Mr-JoE1/SS_AI_Traffic_Radar/README.md

<H1 align="center">SS_Project Backend Development </H1>

## Repo Structure

  -
