Mr-JoE1/SS_AI_Traffic_Radar/ML/README.md

<H1 align="center">SS_Project Backend Development </H1>

## Repo Structure

  - Hardware : contains hardware components config scripts for both cm4 and jetson
  	For repo structure: $ tree -d

  - Plate_detection:  contains sw for YOLOv8 modules for plate detection and text extraction using easyOCR
