Mr-JoE1/SS_AI_Traffic_Radar/Hardware/SS_CM4IO/SS_CM4IO_V2_1/SS_CM4IO_V2_2.png

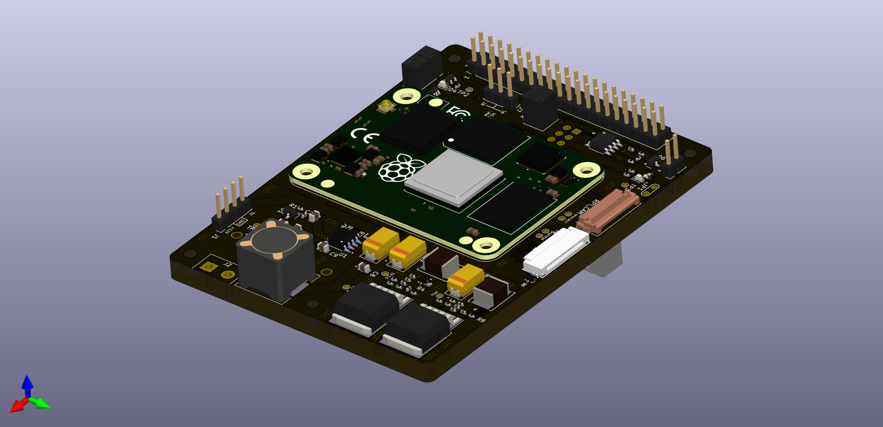
Hardware/SS_CM4IO/SS_CM4IO_V2_1/SS_CM4IO_V2_2.png
