Mr-JoE1/SS_AI_Traffic_Radar/Hardware/SS_JET_ORIN/LT_SIM/TimerDelay_Sim.png

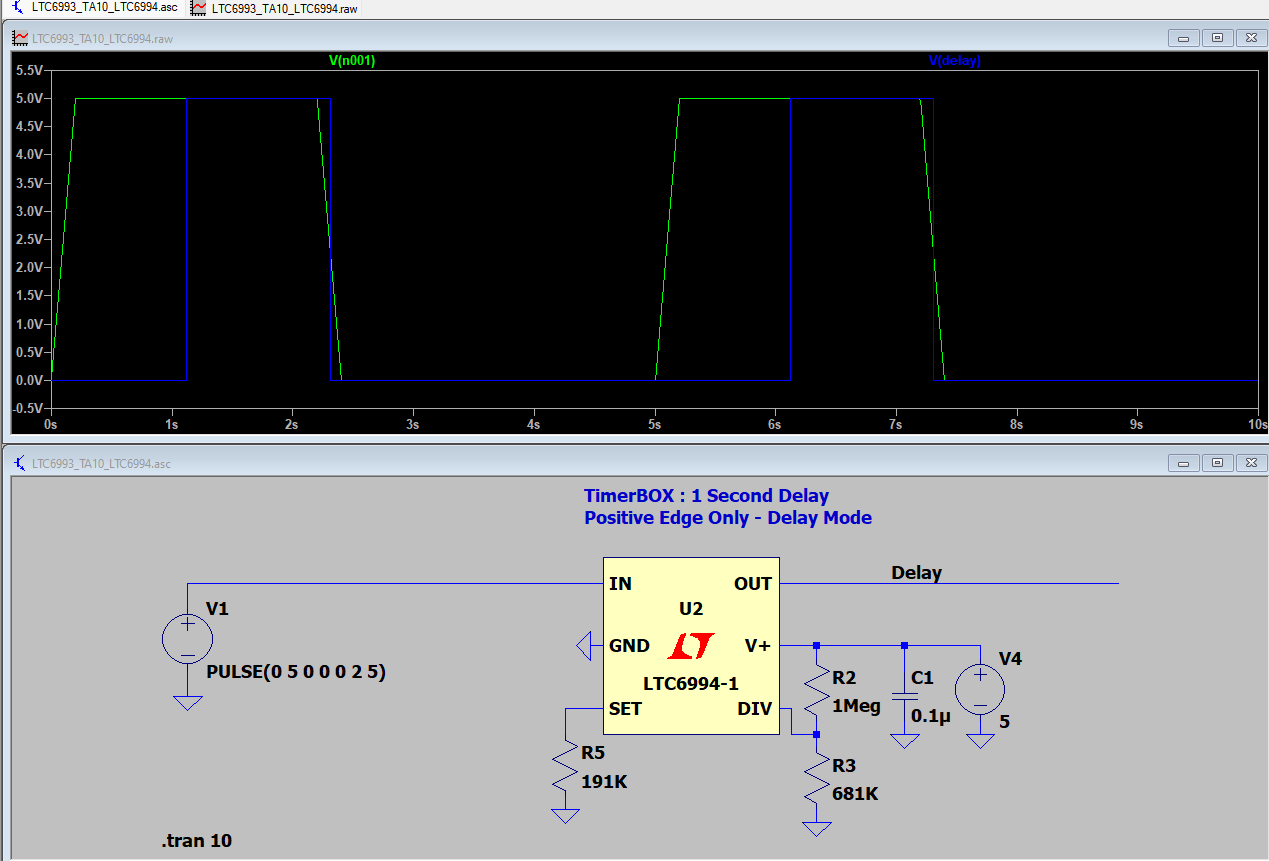
Hardware/SS_JET_ORIN/LT_SIM/TimerDelay_Sim.png
