Mr-JoE1/SS_AI_Traffic_Radar/Hardware/SS_JET_ORIN/REF/Block-diagram-of-Jetson-Orin-Nano.png

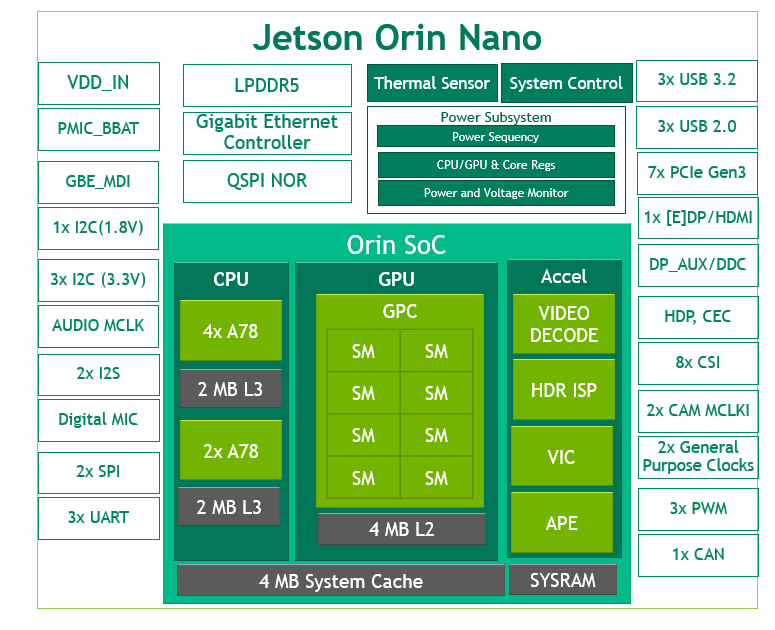
Hardware/SS_JET_ORIN/REF/Block-diagram-of-Jetson-Orin-Nano.png
