Mr-JoE1/SS_AI_Traffic_Radar/Hardware/SS_JET_ORIN/SS_JetOrin_V1/SS_JetOrin_2.png

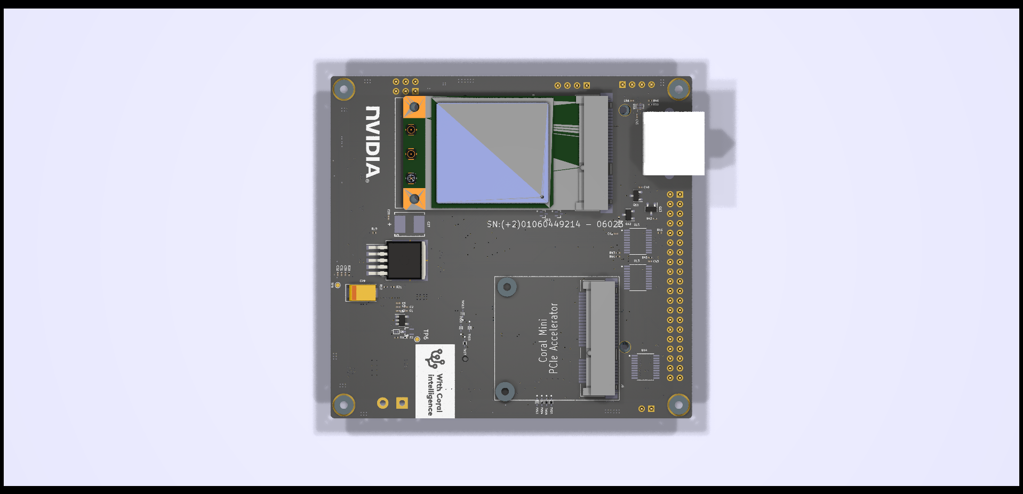
Hardware/SS_JET_ORIN/SS_JetOrin_V1/SS_JetOrin_2.png
