Mr-JoE1/SS_AI_Traffic_Radar/Hardware/PO_Prototype_List.xlsx

Items needed for Protoyping SS CM4 V2 BOARD
CM4 HARDWARE
N | ITEM | QYT | PRICE | LINK
1 | RPI CM4 with wifi and Emmc | 1 | $215 | Raspberry Pi Compute Module 4 With 8gb Ram Lite Emmc Flash Optional Support Wifi/bluetooth And External Antenna - Demo Board - AliExpress (https://www.aliexpress.us/item/3256803028967228.html?curPageLogUid=L7BpIR4CJ1Lk)
2 | RPI CM4 IO BOARD | 1 | $15 | IO Board for CM4 Compute Module for Raspberry Pi 4B Expansion Board Dual HDMI IO Board| | - AliExpress (https://www.aliexpress.us/item/3256805290910127.html?curPageLogUid=mT7mnrszEpVK)
 |  |  | $35 | CM4IO - Raspberry-pi - Compute Module 4 I/O Board, Raspberry Pi, BCM2711 (newark.com) (https://www.newark.com/raspberry-pi/cm4io/compute-module-4-board-arm-cortex/dp/86AH2064)
3 | Raspberry Pi Global Shutter Camera | 1 | $50 | Raspberry Pi Global Shutter Camera - PiShop.us (https://www.pishop.us/product/raspberry-pi-global-shutter-camera/?src=raspberrypi)
4 | SS_CM4_V2 Board JLC | 1 | NA
Common HARDWARE
5 | QuectelEG25GGB-MINIPCIE | 1 | $100 | EG25GGB-MINIPCIE Quectel - Distributors, Price Comparison, and Datasheets | Octopart component search (https://octopart.com/eg25ggb-minipcie-quectel-97300401)
6 | Mini PCIe Accelerator | 1 | $25 | Mini PCIe Accelerator | Coral (https://coral.ai/products/pcie-accelerator)
7 | Coral Camera | 1 | $20 | Camera | Coral (https://coral.ai/products/camera/)
