Mr-JoE1/SS_AI_Traffic_Radar/Hardware/SS_CM4IO/SS_CM4IO_V2_1/EXT_LIB/DALC208SC6/DALC208SC6.step

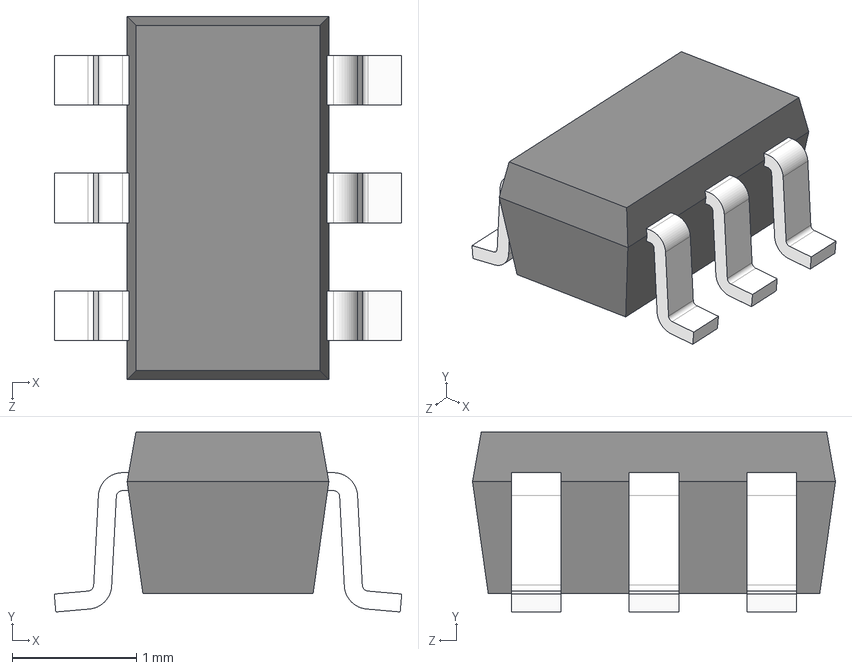
[picture p15: CAD file, 2023-10-18]
Hardware/SS_CM4IO/SS_CM4IO_V2_1/EXT_LIB/DALC208SC6/DALC208SC6.step
2.80 x 1.45 x 2.92 mm
