Mr-JoE1/SS_AI_Traffic_Radar/Hardware/SS_CM4IO/SS_CM4IO_V2_1/EXT_LIB/DTC143ZEBTL/DTC143ZEBTL.step

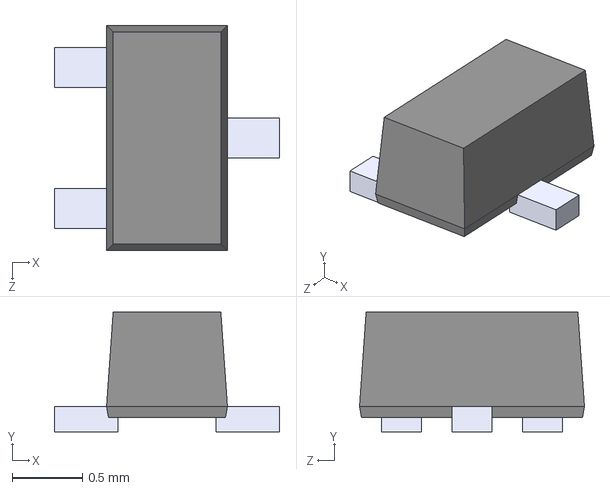
[picture p16: CAD file, 2023-10-18]
Hardware/SS_CM4IO/SS_CM4IO_V2_1/EXT_LIB/DTC143ZEBTL/DTC143ZEBTL.step
1.60 x 0.85 x 1.60 mm
