Mr-JoE1/SS_AI_Traffic_Radar/Hardware/SS_CM4IO/SS_CM4IO_V2_1/EXT_LIB/SIM-E-MFF2-GL-250/SIM-E-MFF2-GL-250.step

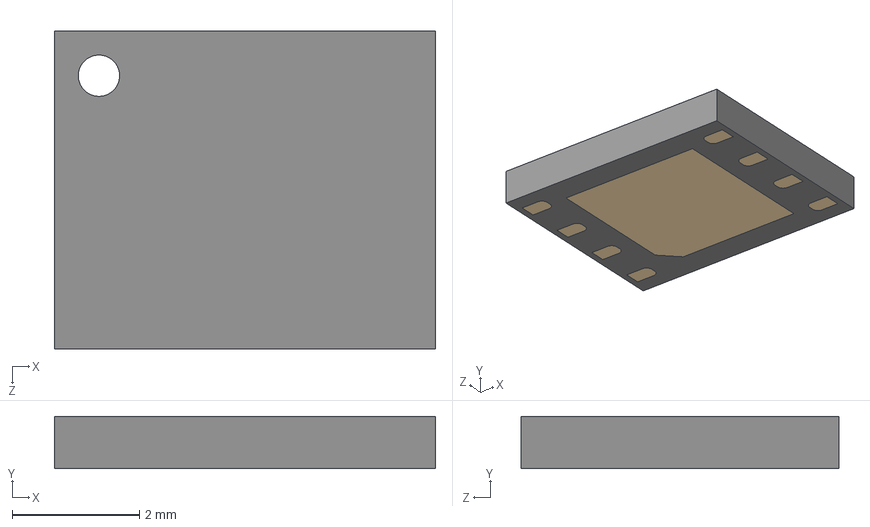
[picture p17: CAD file, 2023-10-18]
Hardware/SS_CM4IO/SS_CM4IO_V2_1/EXT_LIB/SIM-E-MFF2-GL-250/SIM-E-MFF2-GL-250.step
6.00 x 0.82 x 5.00 mm
