Mr-JoE1/SS_AI_Traffic_Radar/Hardware/SS_JET_ORIN/SS_JetOrin_V1/EXT-LIB/DMN26D0UFB4-7/DMN26D0UFB4-7.step

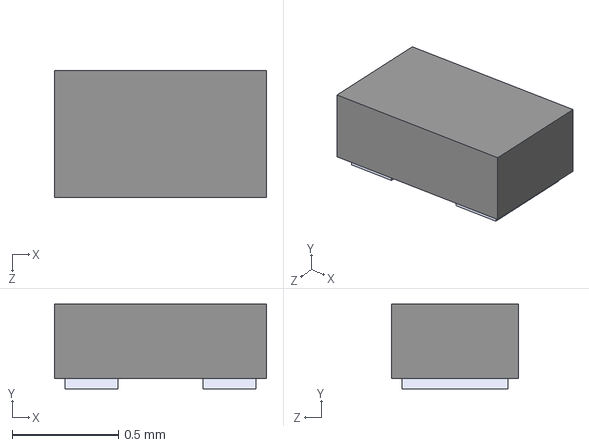
[picture p18: CAD file, 2023-10-18]
Hardware/SS_JET_ORIN/SS_JetOrin_V1/EXT-LIB/DMN26D0UFB4-7/DMN26D0UFB4-7.step
1.00 x 0.4 x 0.6 mm
