Mr-JoE1/SS_AI_Traffic_Radar/Hardware/SS_JET_ORIN/SS_JetOrin_V1/EXT-LIB/DMN61D9UW-7/DMN61D9UW-7.step

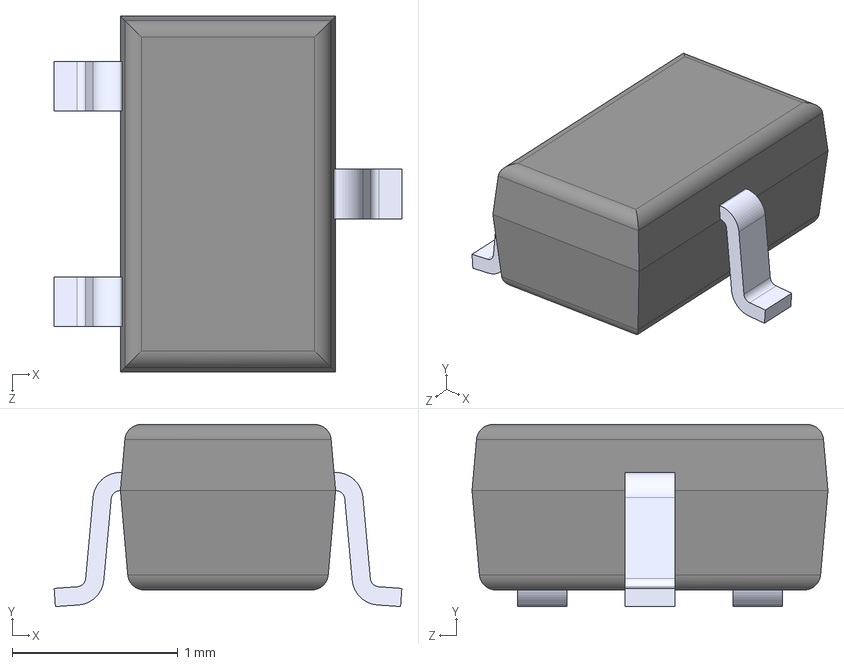
[picture p19: CAD file, 2023-10-18]
Hardware/SS_JET_ORIN/SS_JetOrin_V1/EXT-LIB/DMN61D9UW-7/DMN61D9UW-7.step
2.10 x 1.10 x 2.15 mm
