Mr-JoE1/SS_AI_Traffic_Radar/Hardware/SS_JET_ORIN/SS_JetOrin_V1/EXT-LIB/ESD9L5.0ST5G/ESD9L5.0ST5G.step

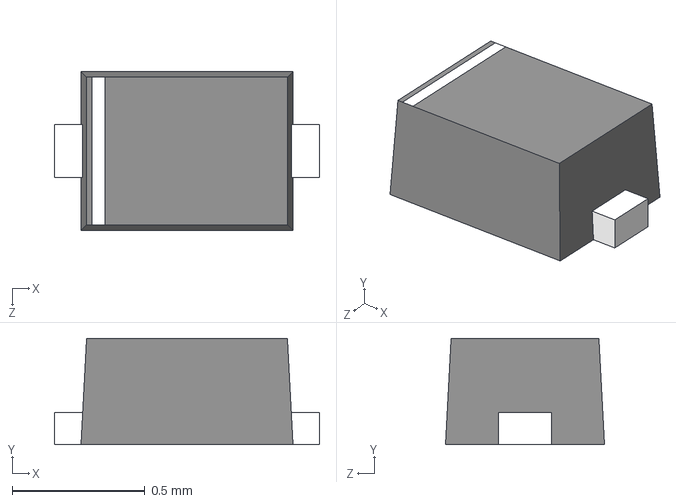
[picture p20: CAD file, 2023-10-18]
Hardware/SS_JET_ORIN/SS_JetOrin_V1/EXT-LIB/ESD9L5.0ST5G/ESD9L5.0ST5G.step
1 x 0.4 x 0.6 mm
