Mr-JoE1/SS_AI_Traffic_Radar/Hardware/SS_JET_ORIN/SS_JetOrin_V1/EXT-LIB/SN74LV1T125DCKR/SN74LV1T125DCKR.step

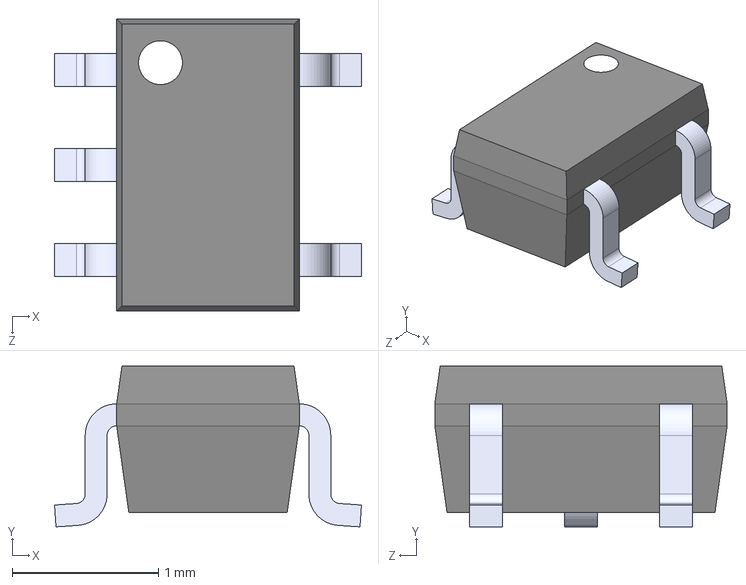
[picture p21: CAD file, 2023-10-18]
Hardware/SS_JET_ORIN/SS_JetOrin_V1/EXT-LIB/SN74LV1T125DCKR/SN74LV1T125DCKR.step
2.10 x 1.10 x 2.00 mm
