Mr-JoE1/SS_AI_Traffic_Radar/Hardware/SS_JET_ORIN/SS_JetOrin_V1/EXT-LIB/TPS5450DDAR/TPS5450DDAR.step

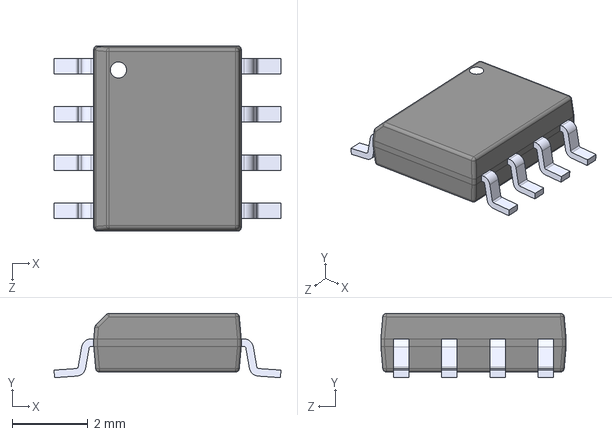
[picture p22: CAD file, 2023-10-18]
Hardware/SS_JET_ORIN/SS_JetOrin_V1/EXT-LIB/TPS5450DDAR/TPS5450DDAR.step
6.00 x 1.70 x 4.90 mm
