Mr-JoE1/SS_AI_Traffic_Radar/Hardware/SS_JET_ORIN/SS_JetOrin_V1/EXT-LIB/TS3USB30ERSWR/TS3USB30ERSWR.step

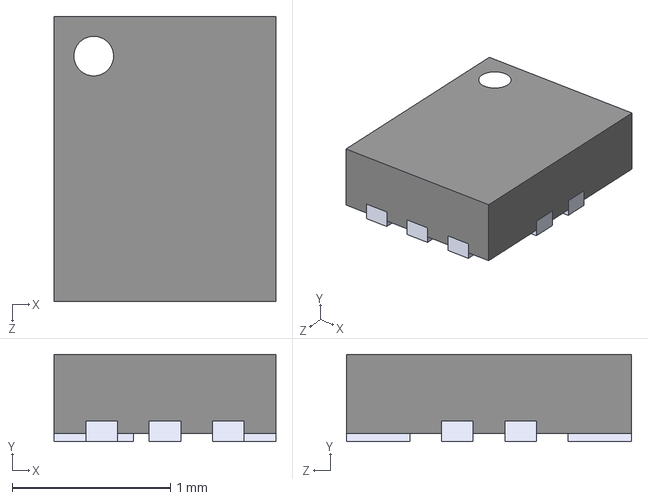
[picture p23: CAD file, 2023-10-18]
Hardware/SS_JET_ORIN/SS_JetOrin_V1/EXT-LIB/TS3USB30ERSWR/TS3USB30ERSWR.step
1.40 x 0.55 x 1.80 mm
