Mr-JoE1/SS_AI_Traffic_Radar/Hardware/SS_JET_ORIN/SS_JetOrin_V1/EXT-LIB/TXB0108PWR/TXB0108PWR.step

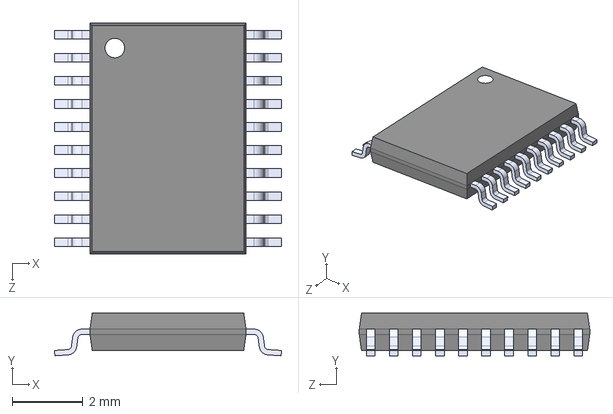
[picture p24: CAD file, 2023-10-18]
Hardware/SS_JET_ORIN/SS_JetOrin_V1/EXT-LIB/TXB0108PWR/TXB0108PWR.step
6.40 x 1.20 x 6.50 mm
