Mr-JoE1/SS_AI_Traffic_Radar/Hardware/SS_JET_ORIN/SS_JetOrin_V1/EXT-LIB/TXB0302DQMR/TXB0302DQMR.step

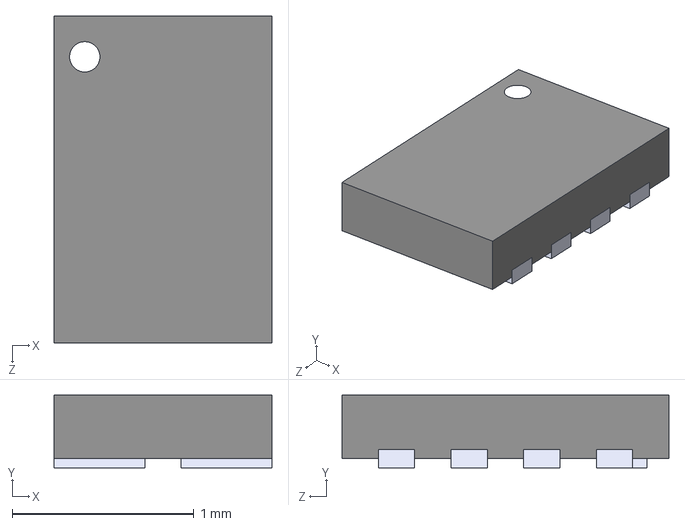
[picture p25: CAD file, 2023-10-18]
Hardware/SS_JET_ORIN/SS_JetOrin_V1/EXT-LIB/TXB0302DQMR/TXB0302DQMR.step
1.20 x 0.4 x 1.80 mm
