Mr-JoE1/SS_AI_Traffic_Radar/Hardware/SS_JET_ORIN/SS_JetOrin_V1/3d_shapes/PowerDI3333-8_Type-UX.STP

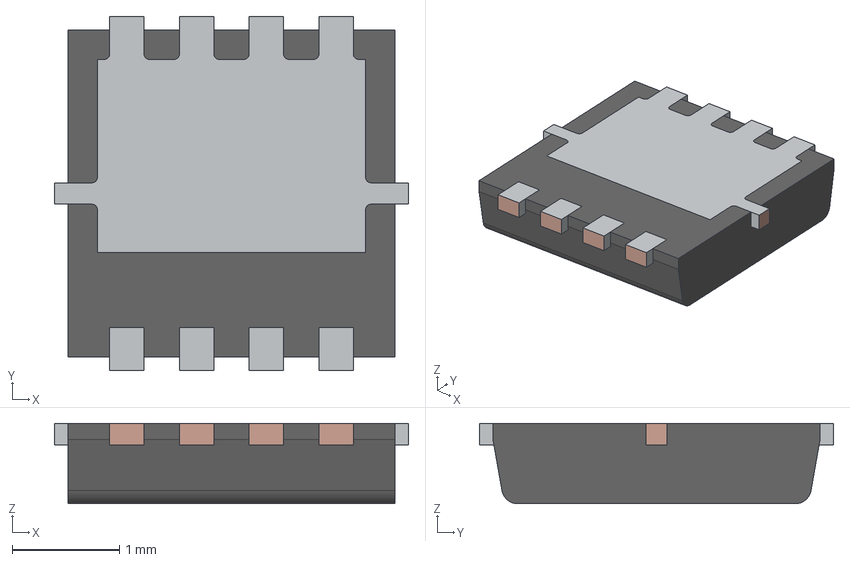
[picture p26: CAD file, 2023-10-18]
Hardware/SS_JET_ORIN/SS_JetOrin_V1/3d_shapes/PowerDI3333-8_Type-UX.STP
3.30 x 3.30 x 0.75 mm
Mold
LDF
