Mr-JoE1/SS_AI_Traffic_Radar/Hardware/SS_JET_ORIN/SS_JetOrin_V1/3d_shapes/P3767-pcba-envelop_20230310.stp

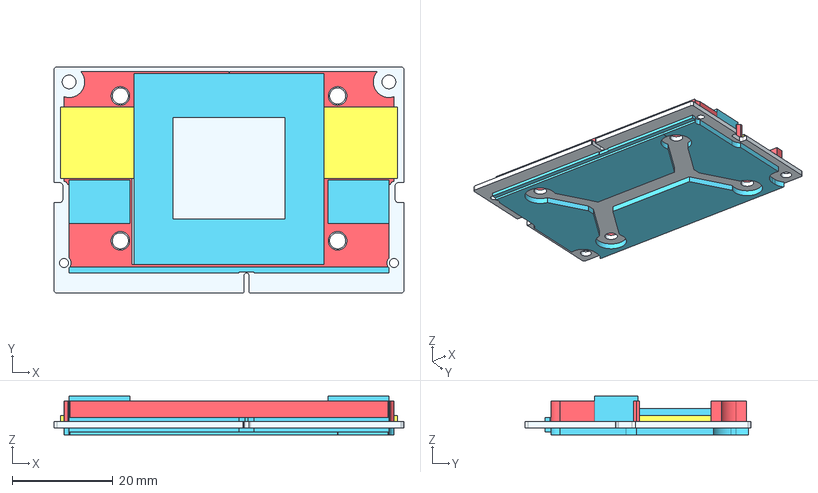
[picture p27: CAD file, 2023-10-18]
Hardware/SS_JET_ORIN/SS_JetOrin_V1/3d_shapes/P3767-pcba-envelop_20230310.stp
69.6 x 45.0 x 7.68 mm
