Mr-JoE1/SS_AI_Traffic_Radar/Hardware/SS_JET_ORIN/SS_JetOrin_V1/3d_shapes/FPC-SMD_P0.50-24P_QCHF-SM-H2.0.obj

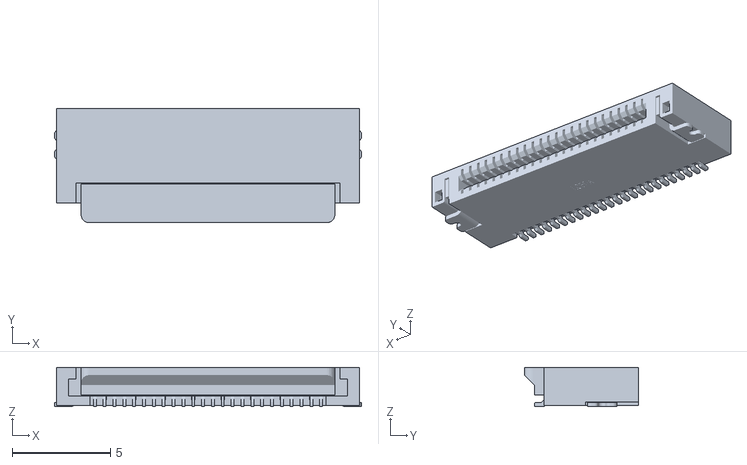
[picture p28: CAD file, 2023-10-18]
Hardware/SS_JET_ORIN/SS_JetOrin_V1/3d_shapes/FPC-SMD_P0.50-24P_QCHF-SM-H2.0.obj
15.6 x 5.80 x 2.00
