Mr-JoE1/SS_AI_Traffic_Radar/Hardware/SS_JET_ORIN/SS_JetOrin_V1/3d_shapes/FH12-22S-0.5SH.STEP

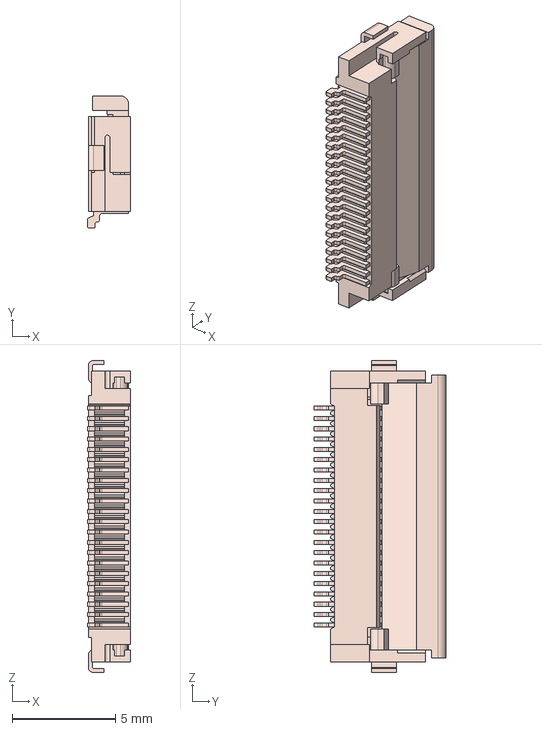
[picture p29: CAD file, 2023-10-18]
Hardware/SS_JET_ORIN/SS_JetOrin_V1/3d_shapes/FH12-22S-0.5SH.STEP
2.10 x 6.40 x 15.1 mm
