Mr-JoE1/SS_AI_Traffic_Radar/Hardware/SS_JET_ORIN/SS_JetOrin_V1/3d_shapes/pcie_52_h.stp

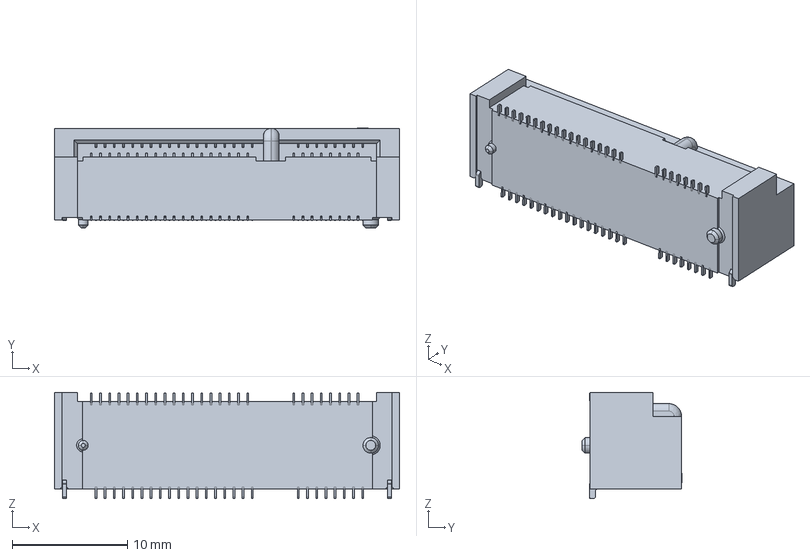
[picture p30: CAD file, 2023-10-18]
Hardware/SS_JET_ORIN/SS_JetOrin_V1/3d_shapes/pcie_52_h.stp
30.0 x 8.68 x 9.22 mm
