Mr-JoE1/SS_AI_Traffic_Radar/(list of files, cad)

Other CAD files:
Hardware/SS_JET_ORIN/SS_JetOrin_V1/3d_shapes/9774025151.stp
