Mr-JoE1/SS_AI_Traffic_Radar/Hardware/SS_JET_ORIN/SS_JetOrin_V1/SS_JetOrin_V1-PSUs-P_Seq_M.pdf

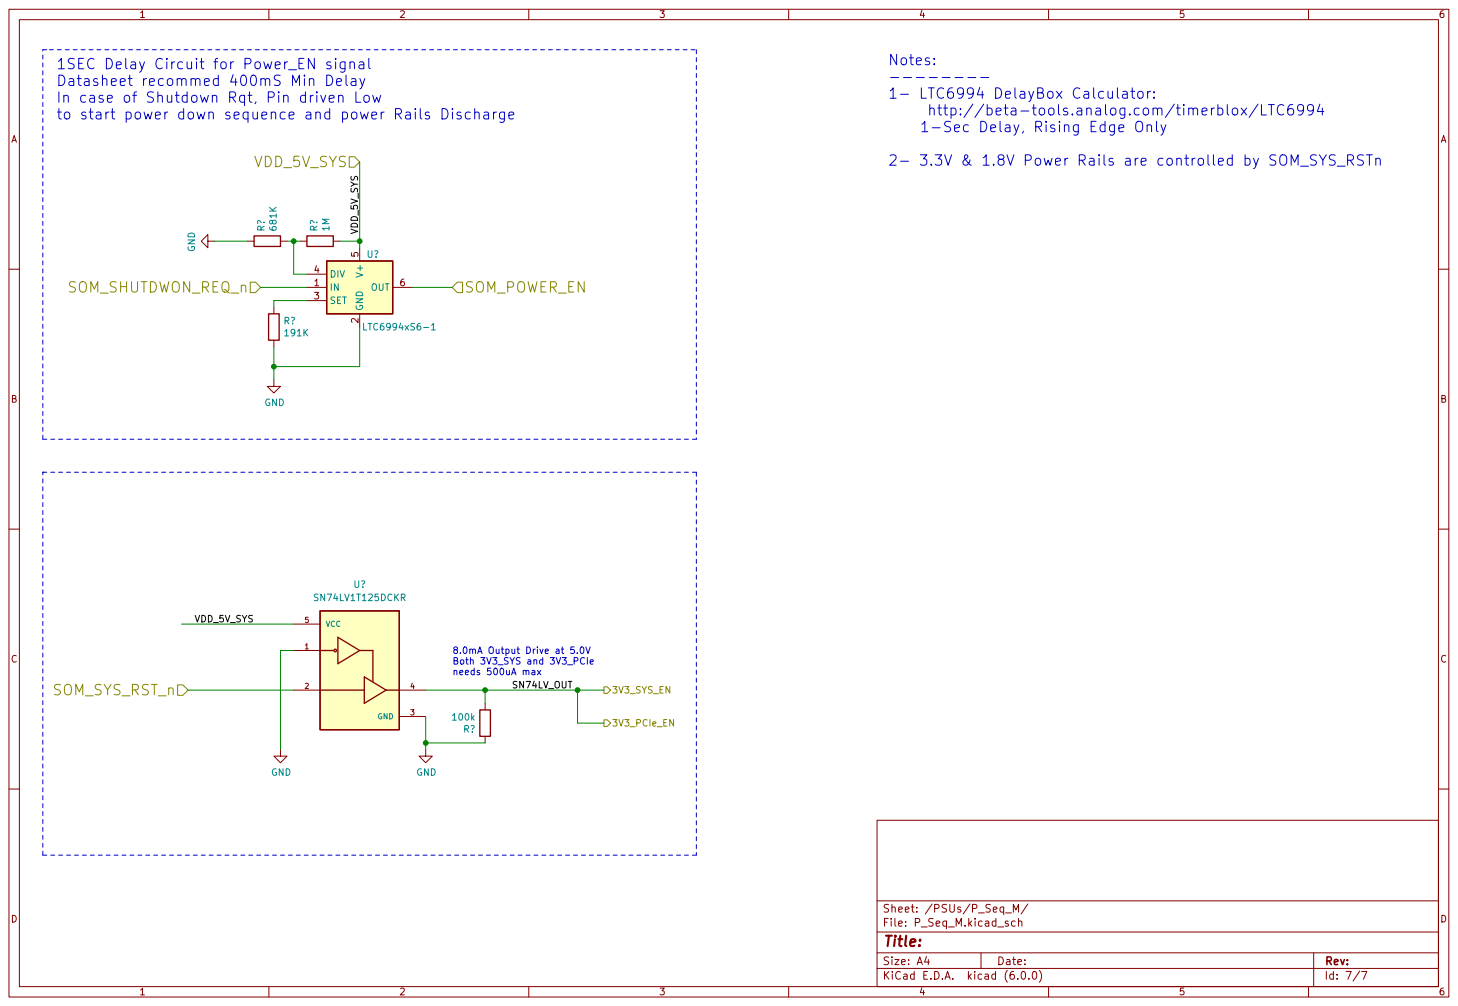
[picture p31: page 1]

1SEC Delay Circuit for Power_EN signal
Datasheet recommed 400mS Min Delay
In case of Shutdown Rqt, Pin driven Low
to start power down sequence and power Rails Discharge

http://beta-tools.analog.com/timerblox/LTC6994
1-Sec Delay, Rising Edge Only

2- 3.3V & 1.8V Power Rails are controlled by SOM_SYS_RSTn
