Mr-JoE1/SS_AI_Traffic_Radar/Hardware/SS_JET_ORIN/SS_JetOrin_V1/production/SS_JetOrin_V1.pdf

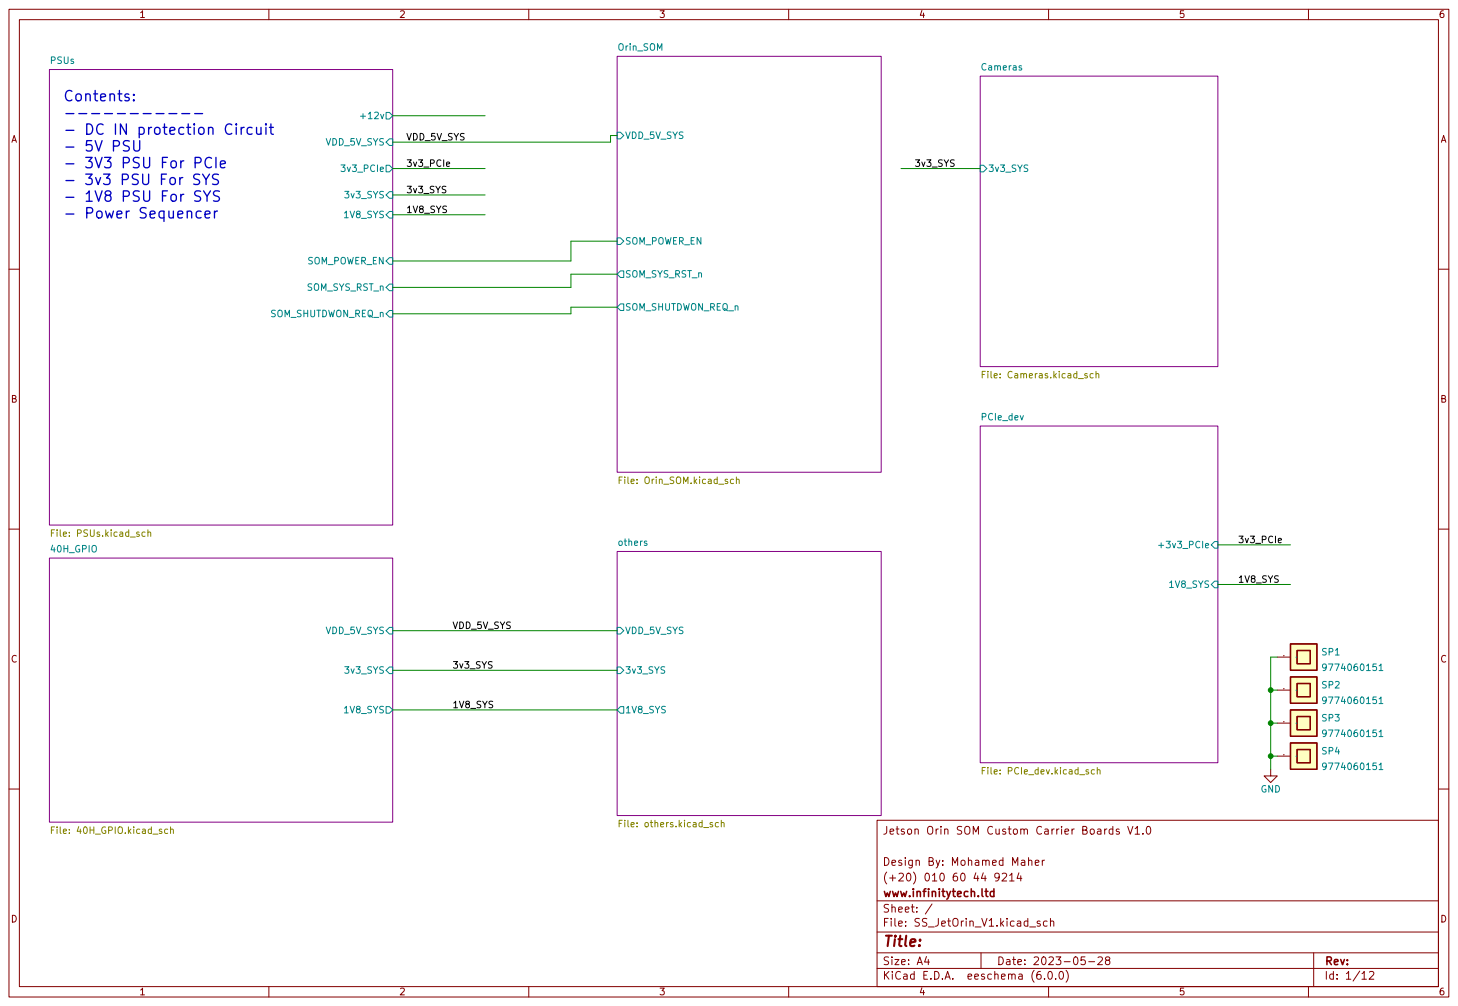
[picture p32: page 1]

PSUs File: PSUs.kicad_sch
3v3_SYS Contents:
- DC IN protection Circuit
- 5V PSU
- 3V3 PSU For PCIe
- 3v3 PSU For SYS
- 1V8 PSU For SYS
- Power Sequencer

Design By: Mohamed Maher Jetson Orin SOM Custom Carrier Boards V1.0

File: SS_JetOrin_V1.kicad_sch Sheet: / www.infinitytech.ltd

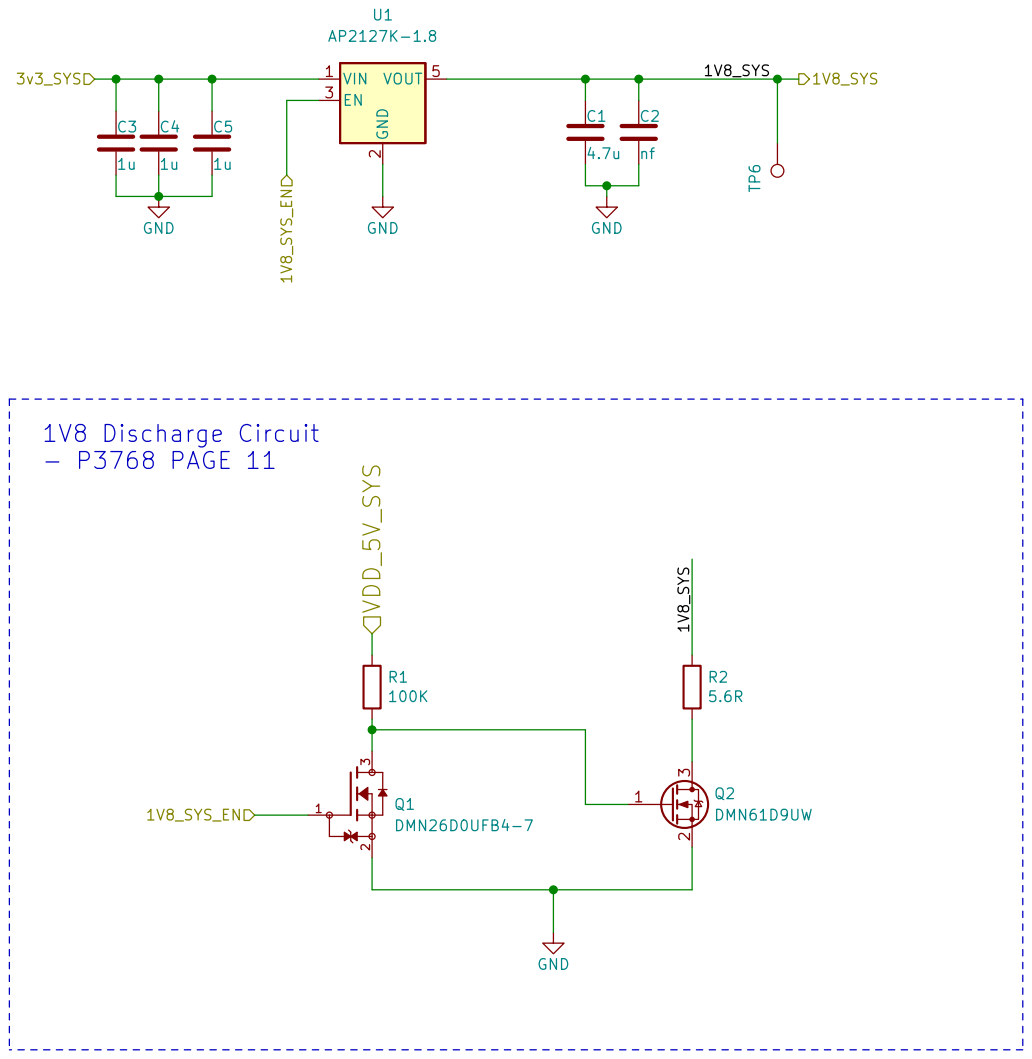
[picture p33: page 2]

Design By: Mohamed Maher Jetson Orin SOM Custom Carrier Boards V1.0 R1

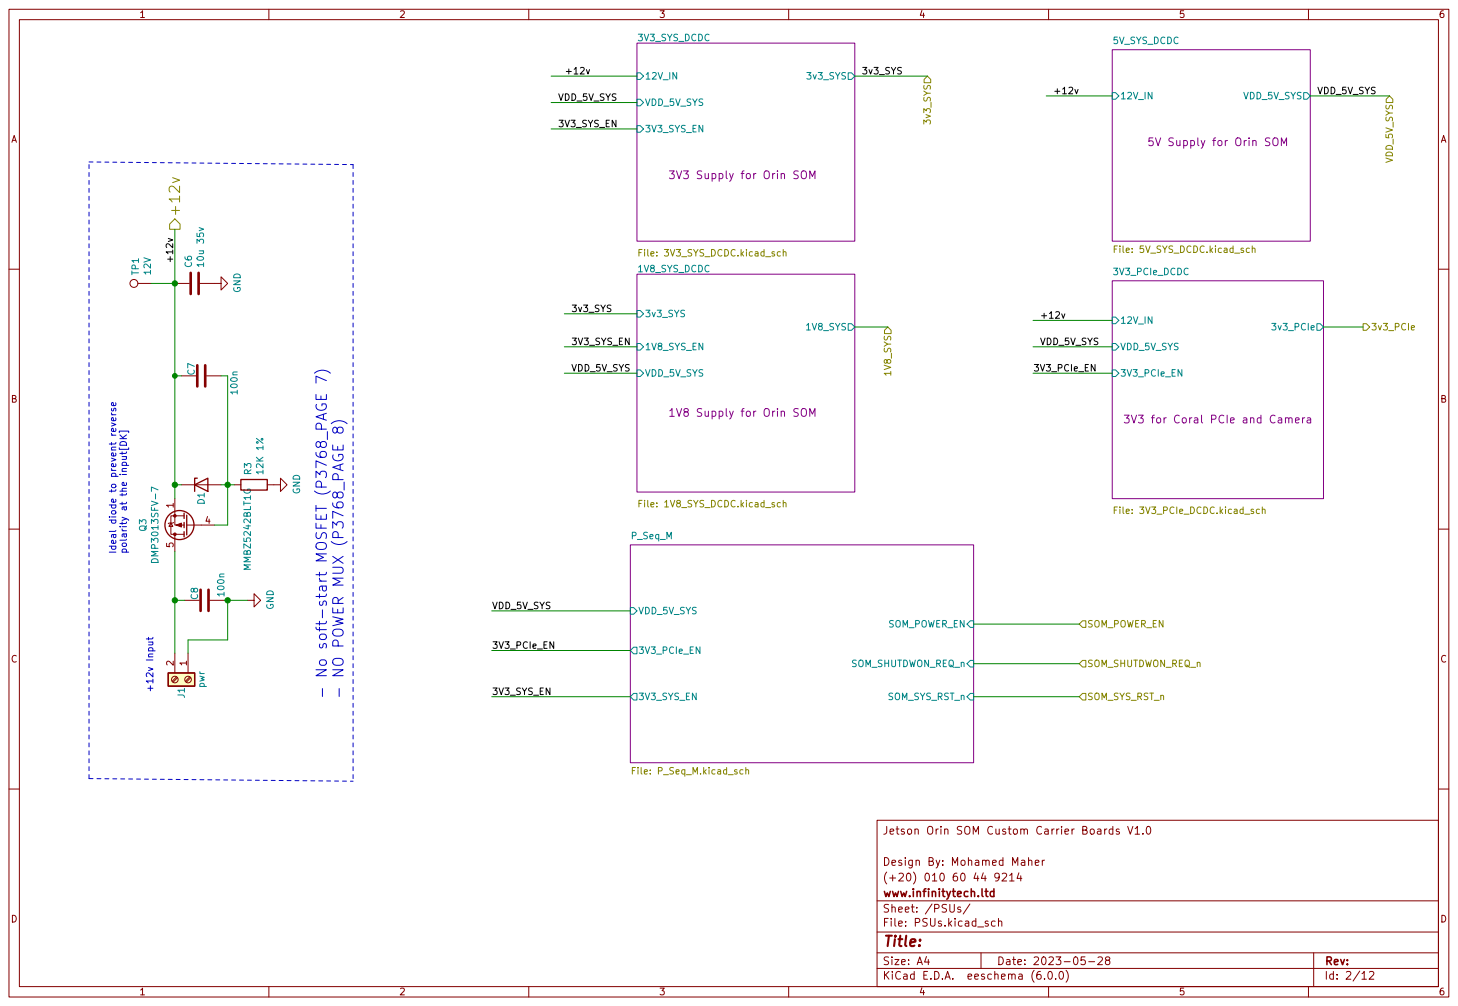
[picture p34: page 3]

File: 5V_SYS_DCDC.kicad_sch 5V Supply for Orin SOM

File: 3V3_SYS_DCDC.kicad_sch 3V3 Supply for Orin SOM

File: 1V8_SYS_DCDC.kicad_sch 1V8 Supply for Orin SOM

File: 3V3_PCIe_DCDC.kicad_sch 3V3 for Coral PCIe and Camera

Design By: Mohamed Maher Jetson Orin SOM Custom Carrier Boards V1.0

File: PSUs.kicad_sch Sheet: /PSUs/ www.infinitytech.ltd

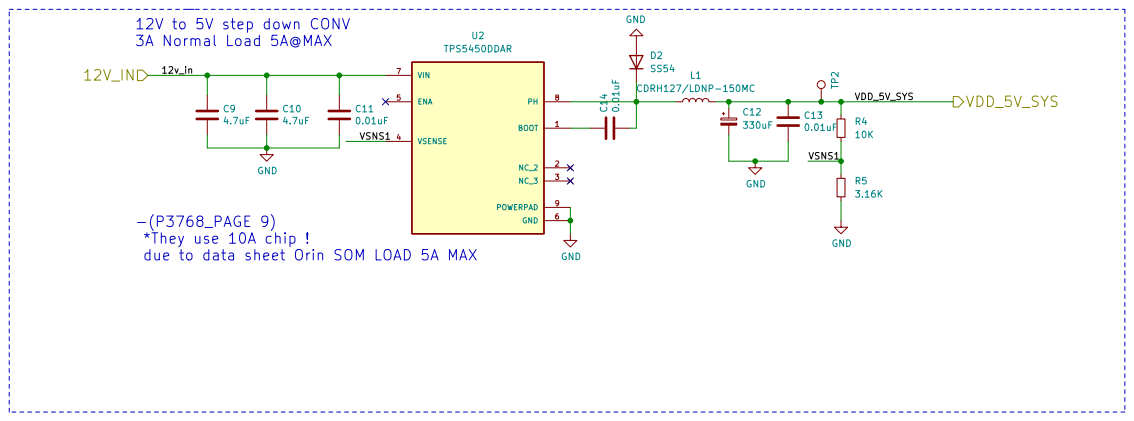
[picture p35: page 4]

VSNS1 12V to 5V step down CONV
3A Normal Load 5A@MAX

-(P3768_PAGE 9)
*They use 10A chip !
due to data sheet Orin SOM LOAD 5A MAX

Design By: Mohamed Maher Jetson Orin SOM Custom Carrier Boards V1.0

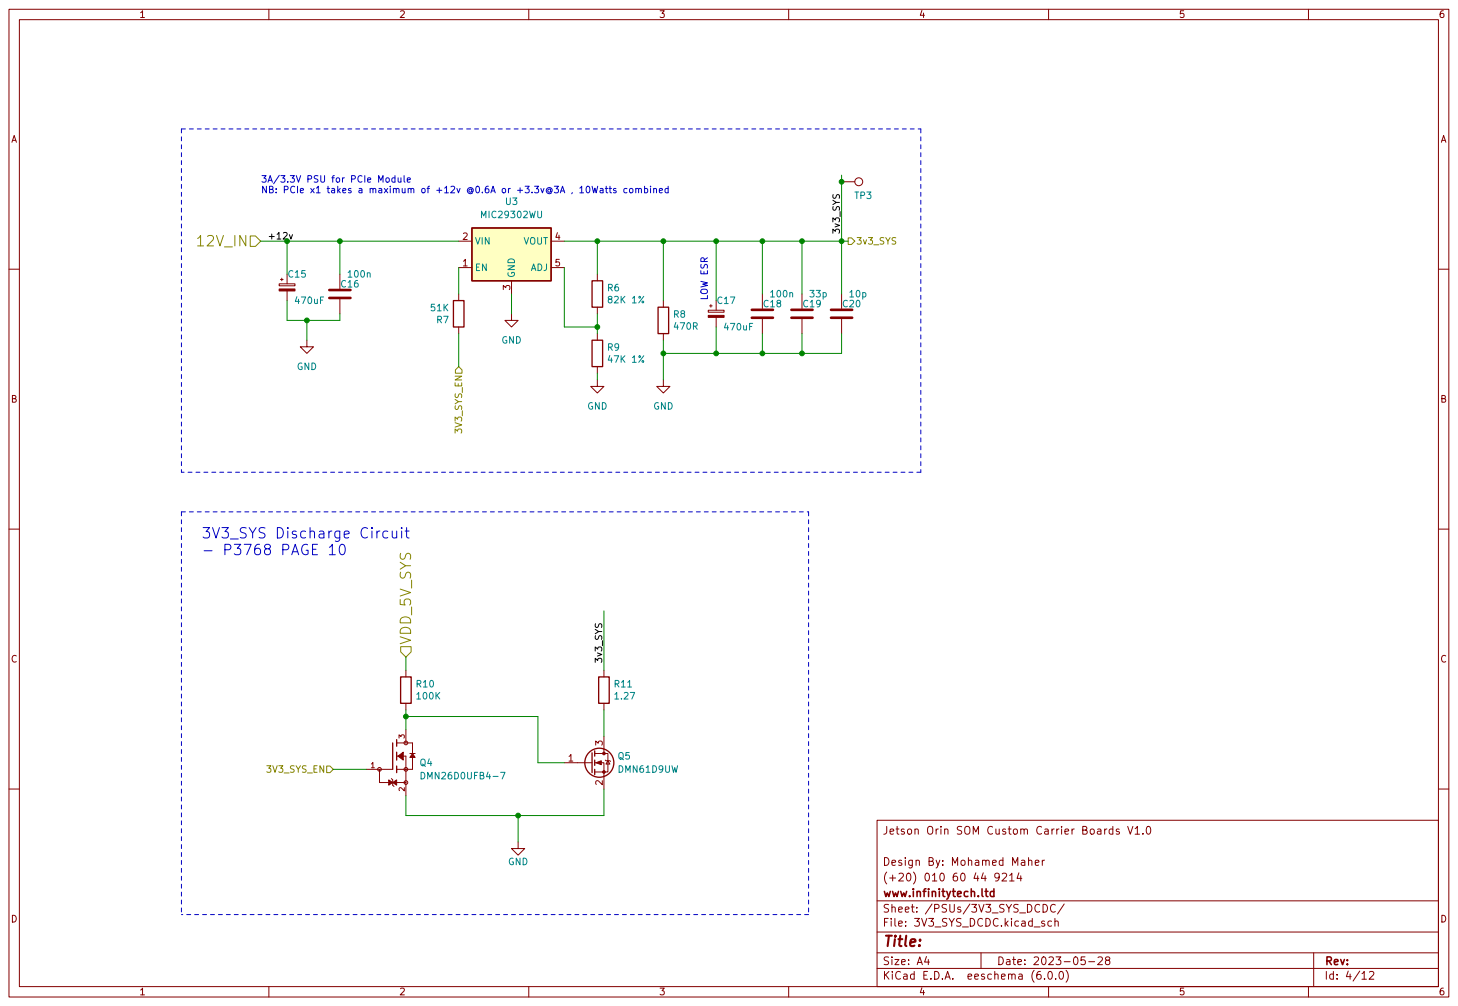
[picture p36: page 5]

Design By: Mohamed Maher Jetson Orin SOM Custom Carrier Boards V1.0 GND

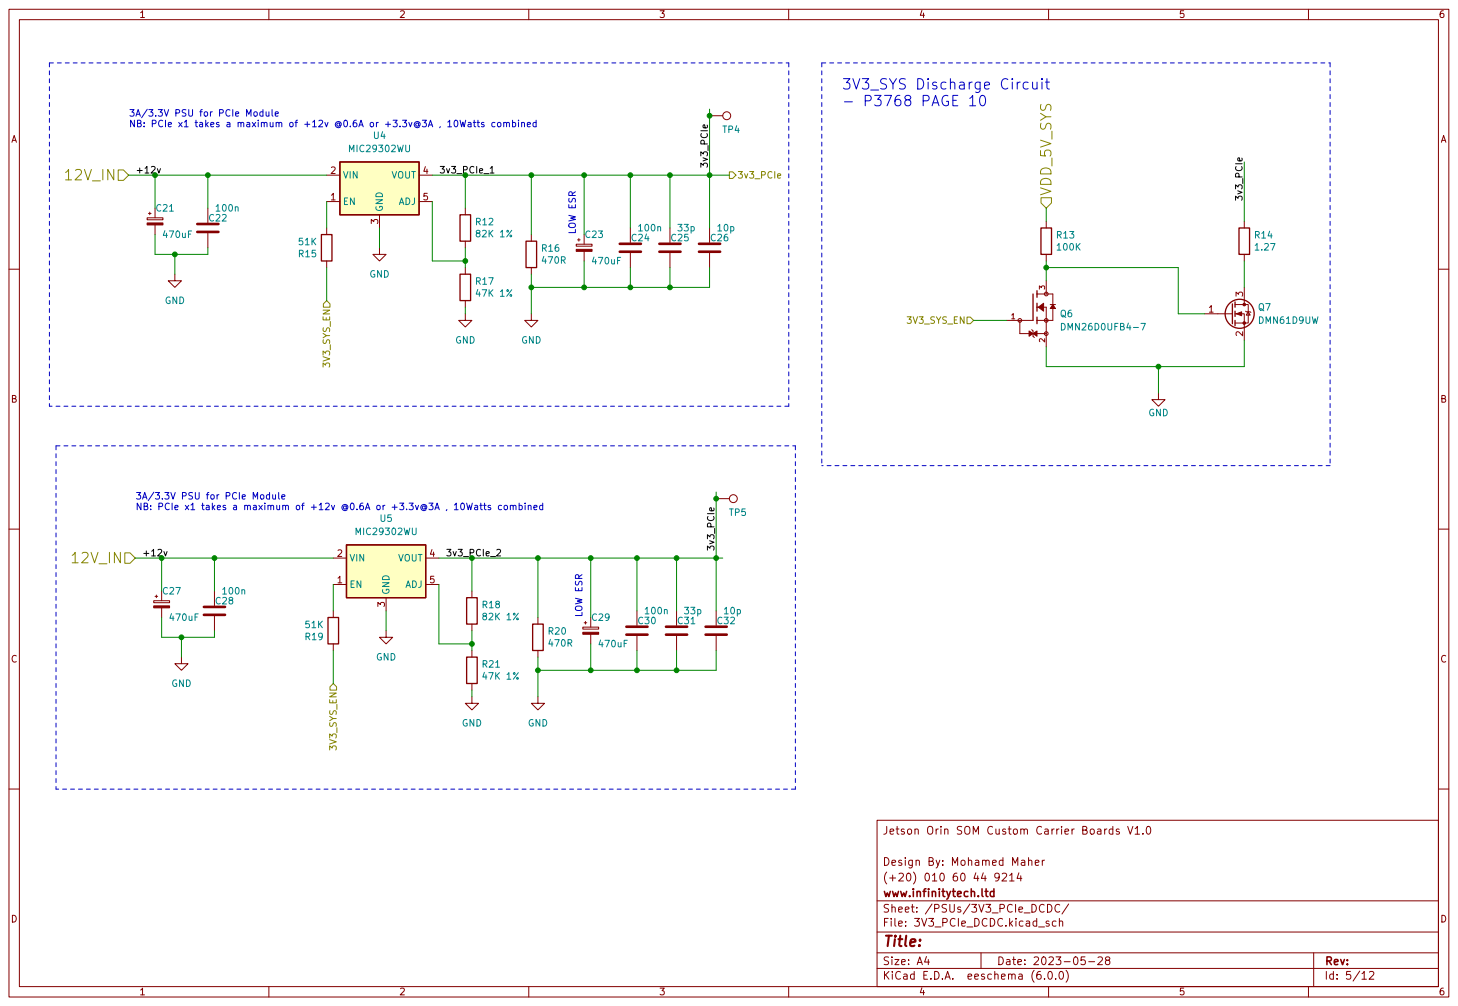
[picture p37: page 6]

- P3768 PAGE 10 LOW ESR LOW ESR

3A/3.3V PSU for PCIe Module NB: PCIe x1 takes a maximum of +12v @0.6A or +3.3v@3A , 10Watts combined

Design By: Mohamed Maher Jetson Orin SOM Custom Carrier Boards V1.0

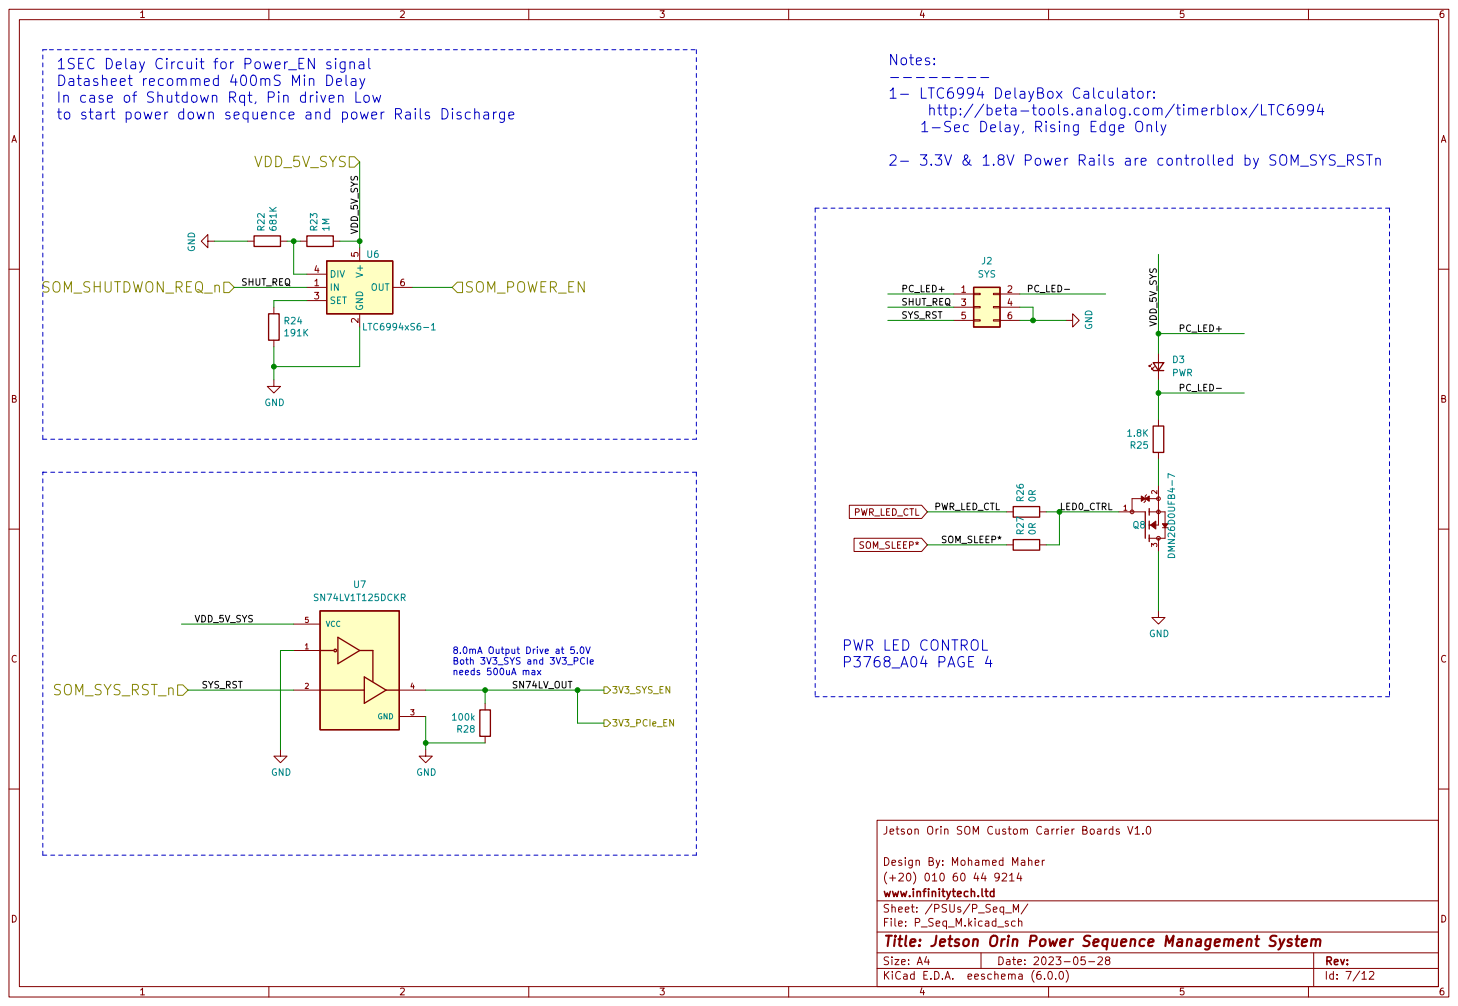
[picture p38: page 7]

1SEC Delay Circuit for Power_EN signal
Datasheet recommed 400mS Min Delay
In case of Shutdown Rqt, Pin driven Low
to start power down sequence and power Rails Discharge

http://beta-tools.analog.com/timerblox/LTC6994
1-Sec Delay, Rising Edge Only

2- 3.3V & 1.8V Power Rails are controlled by SOM_SYS_RSTn

www.infinitytech.ltd
Sheet: /PSUs/P_Seq_M/
File: P_Seq_M.kicad_sch
Id: 7/12 Title: Jetson Orin Power Sequence Management System

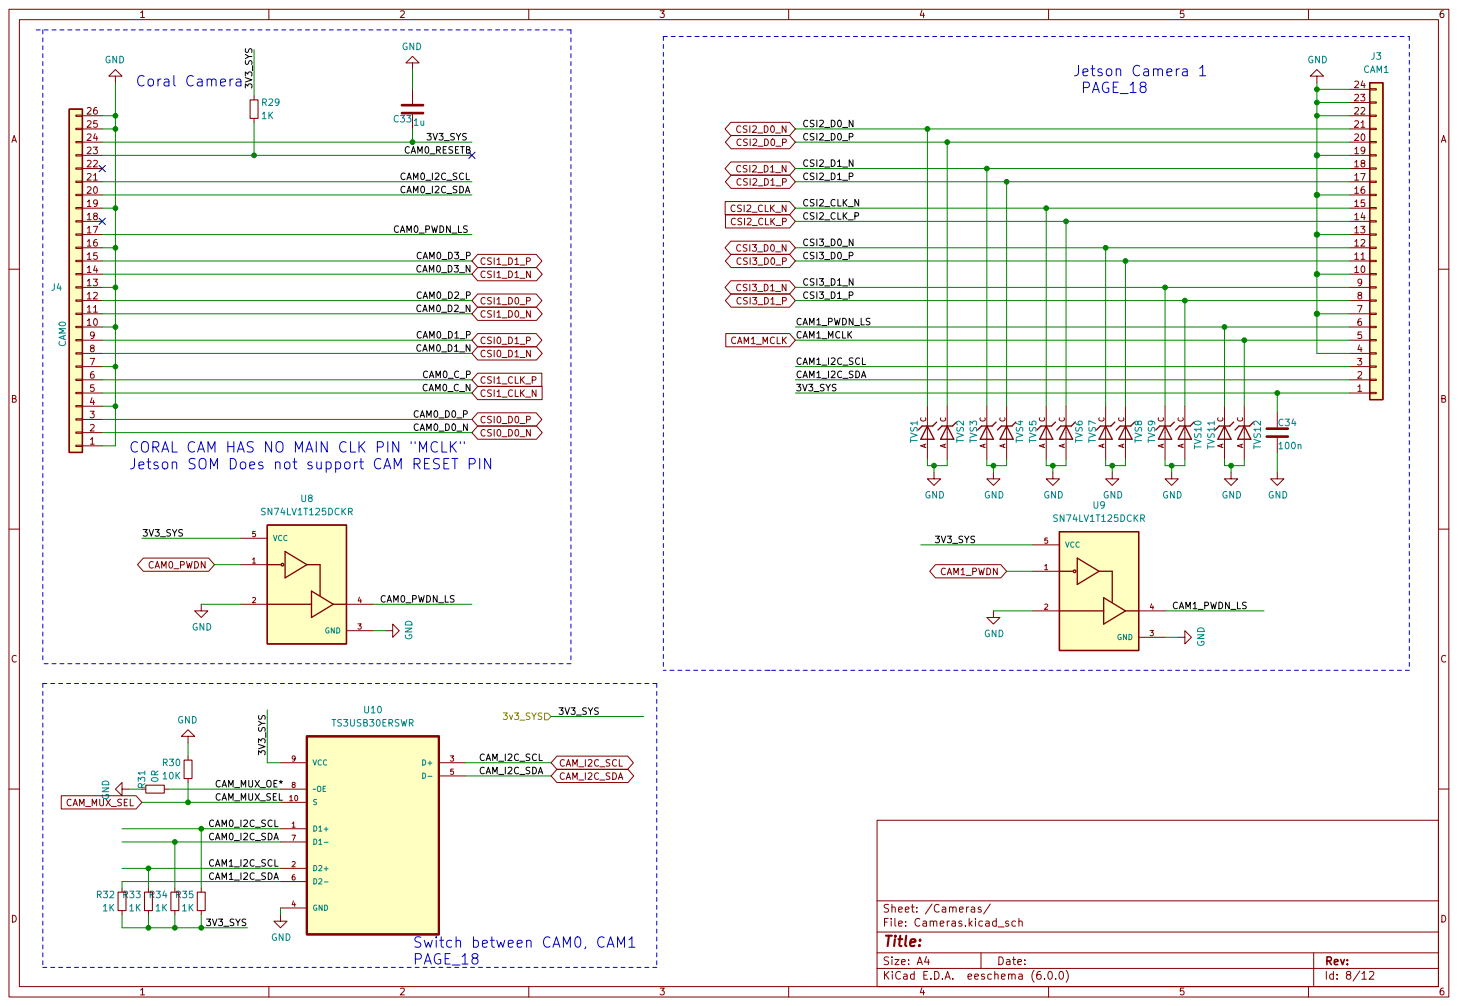
[picture p39: page 8]

3V3_SYS CAM1_I2C_SCL CSI3_D1_N
File: Cameras.kicad_sch Sheet: /Cameras/ GND

U8 SN74LV1T125DCKR | 4 VCC 5

U9 SN74LV1T125DCKR | 4 VCC 5

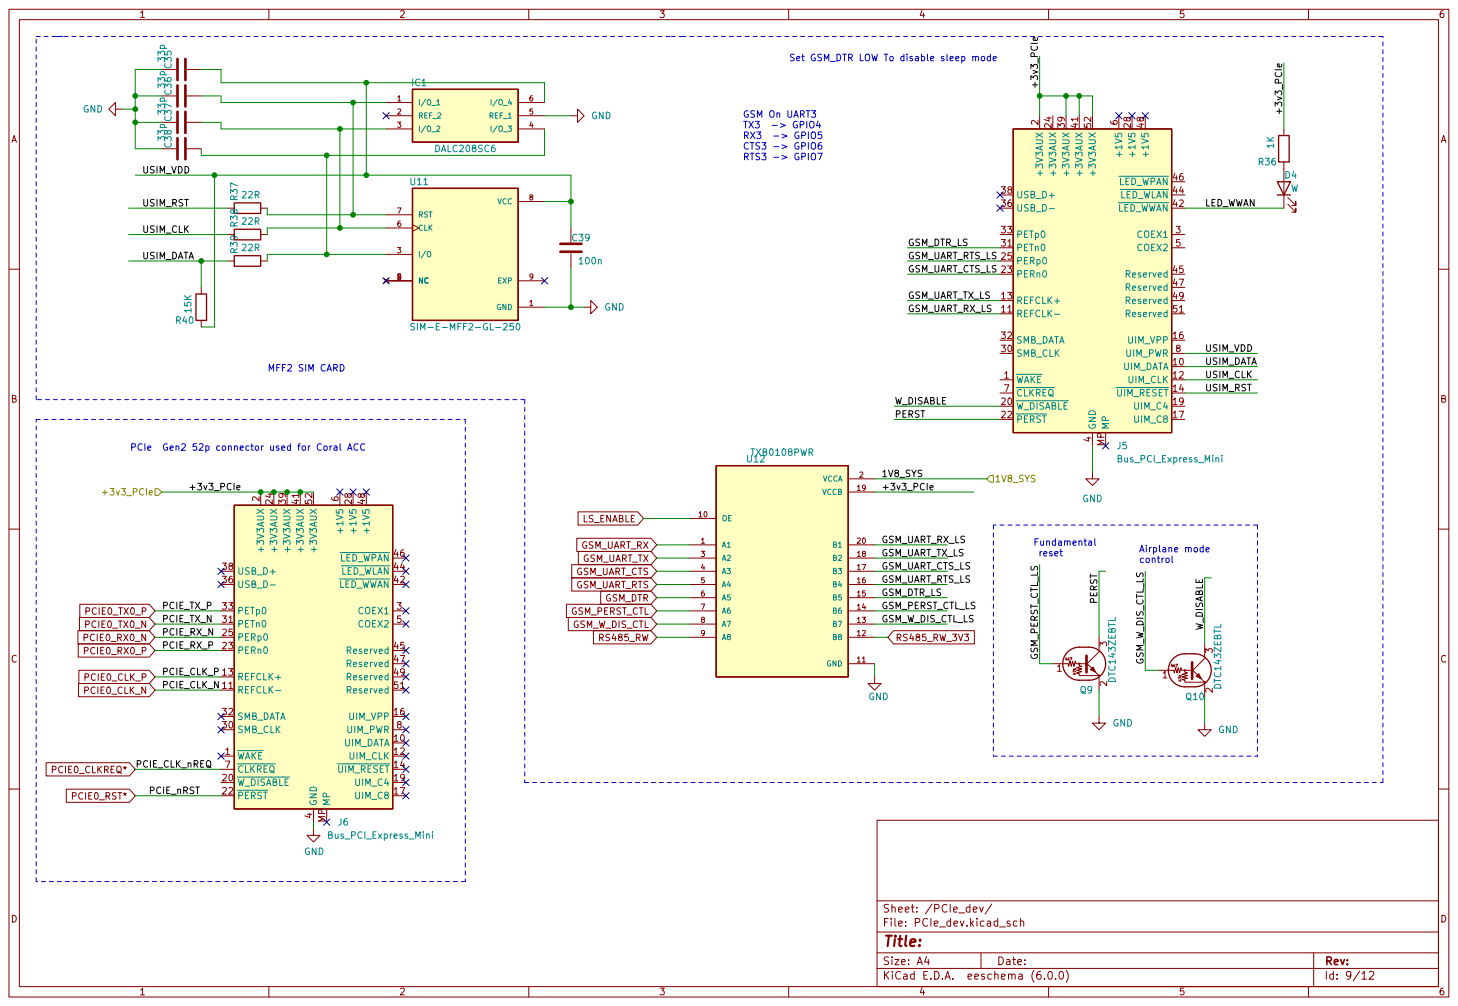
[picture p40: page 9]

6 ~{CLKREQ} 7 UIM_PWR 8 MP MP J5Bus_PCI_Express_Mini C3533p C3833p GND

4 +3V3AUX 41 ~{LED_WWAN}42 ~{LED_WLAN} 44 Reserved 45 ~{LED_WPAN}46 Reserved 47 +1V5 48 Reserved 49 COEX2 5 Reserved 51 +3V3AUX 52 +1V5

control MFF2 SIM CARD PCIe Gen2 52p connector used for Coral ACC

6 ~{CLKREQ} 7 UIM_PWR 8 MP MP J6 Bus_PCI_Express_Mini GND GND 47k 4k7 1

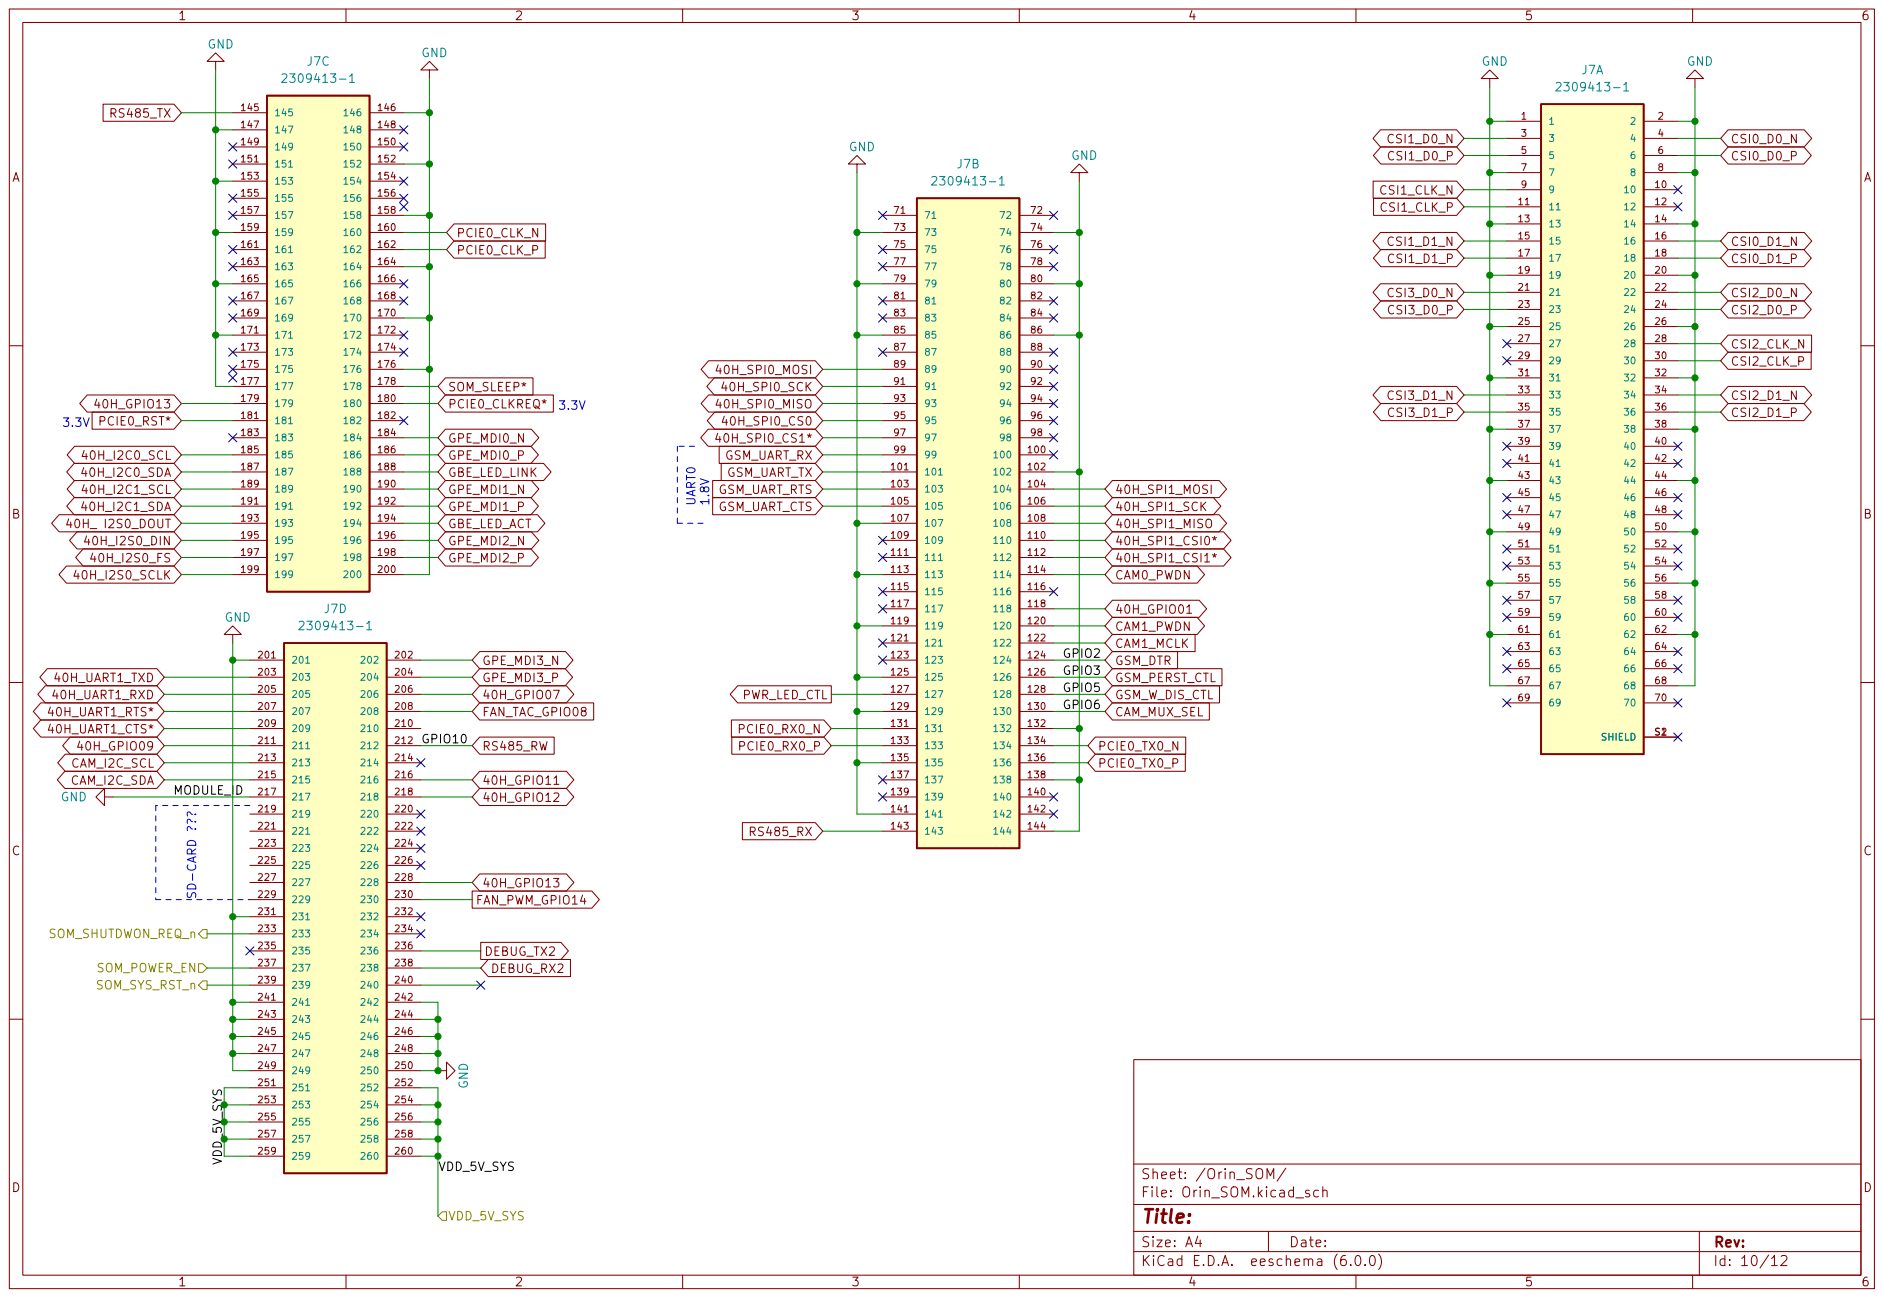
[picture p41: page 10]

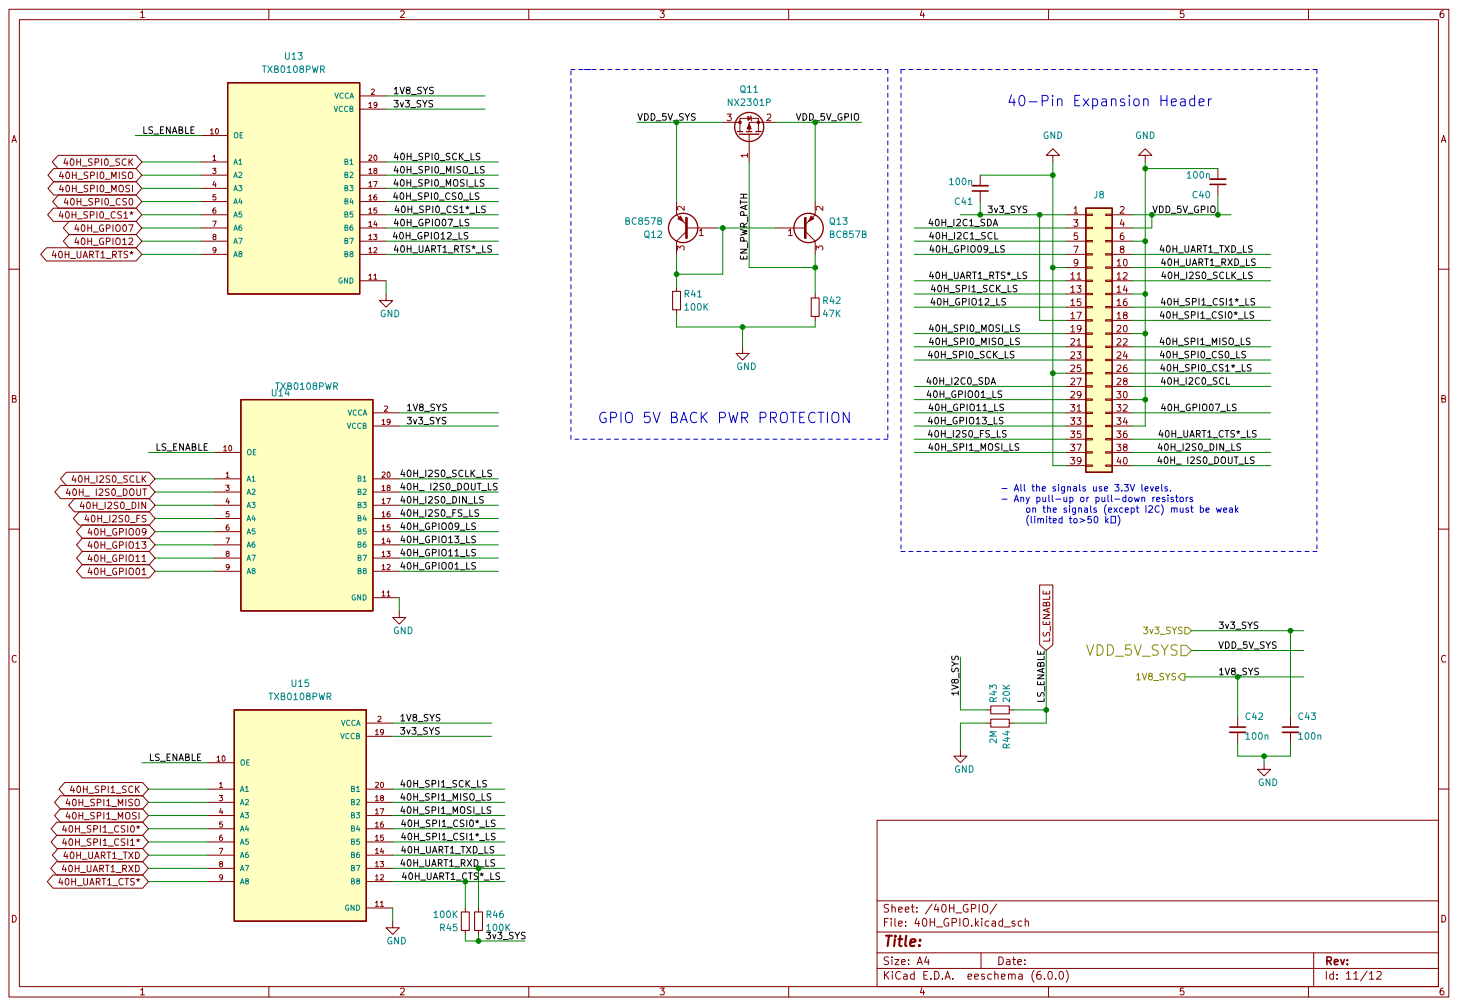
[picture p42: page 11]

GPIO 5V BACK PWR PROTECTION

- All the signals use 3.3V levels.
- Any pull-up or pull-down resistors
on the signals (except I2C) must be weak

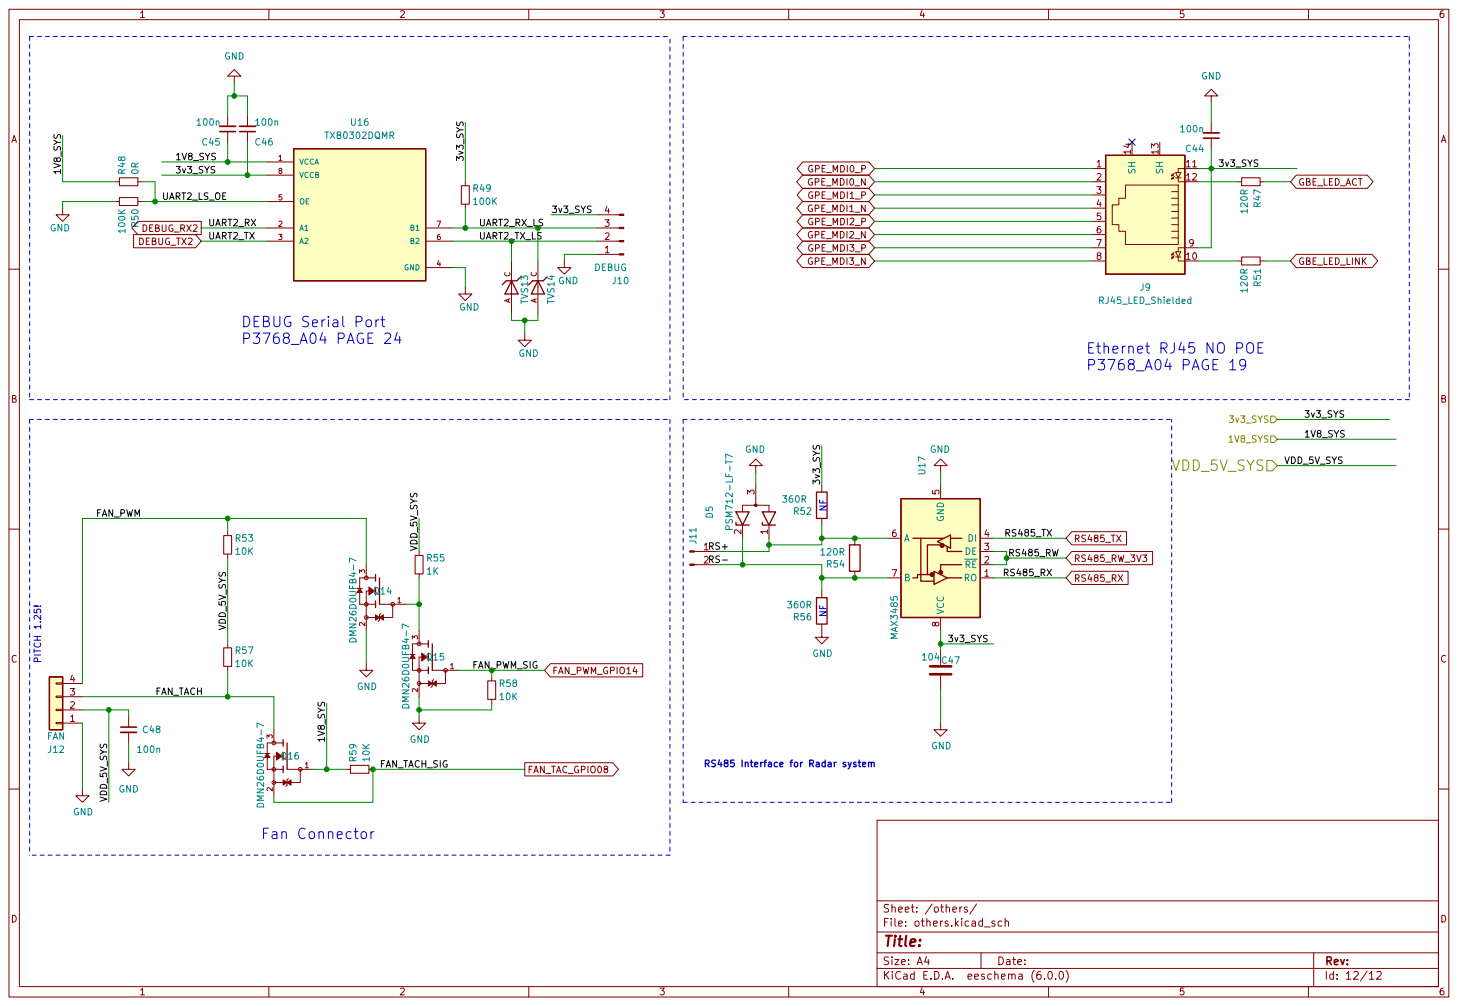
[picture p43: page 12]

File: others.kicad_sch Sheet: /others/ GND

RS485 Interface for Radar system
