Mr-JoE1/SS_AI_Traffic_Radar/Hardware/SS_JET_ORIN/LT_SIM/LTC6994_TimerDelay.asc

C1: cap; 0.1µ
R2: res; 1Meg
R3: res; 681K
R5: res; 191K
U2: LTC6994-1
V1: voltage; PULSE(0 5 0 0 0 2 5)
V4: voltage; 5
Named nets: 0, Delay
TimerBOX : 1 Second Delay
Positive Edge Only - Delay Mode
.tran 10
