Mr-JoE1/SS_AI_Traffic_Radar/(list of files, drawings)

Other design files:
Hardware/Ref/Coral-Dev-Board-baseboard-schematic-Altium/Coral_Dev_Baseboard.PrjPcb
Hardware/Ref/Coral-Dev-Board-baseboard-schematic-Altium/Schematic/01_COVER.SchDoc
Hardware/Ref/Coral-Dev-Board-baseboard-schematic-Altium/Schematic/02_BLOCK_DIAGRAM.SchDoc
Hardware/Ref/Coral-Dev-Board-baseboard-schematic-Altium/Schematic/03_USB.SchDoc
Hardware/Ref/Coral-Dev-Board-baseboard-schematic-Altium/Schematic/04_HDMI_MIPI.SchDoc
Hardware/Ref/Coral-Dev-Board-baseboard-schematic-Altium/Schematic/05_AUDIO.SchDoc
Hardware/Ref/Coral-Dev-Board-baseboard-schematic-Altium/Schematic/06_GBE_SDCARD.SchDoc
Hardware/Ref/Coral-Dev-Board-baseboard-schematic-Altium/Schematic/07_DEBUG.SchDoc
Hardware/Ref/Coral-Dev-Board-baseboard-schematic-Altium/Schematic/08_EXP_CN.SchDoc
Hardware/Ref/Coral-Dev-Board-baseboard-schematic-Altium/Schematic/09_EXP_CN_100PIN.SchDoc
Hardware/Ref/Coral-Dev-Board-baseboard-schematic-Altium/Schematic/10_MISC.SchDoc
Hardware/Ref/Coral-Dev-Board-baseboard-schematic-Altium/Schematic/11_CHANGE_LOG.SchDoc
Hardware/SS_CM4IO/SS_CM4IO_V2_1/SS_CM4IO_V2.dsn
