Mr-JoE1/SS_AI_Traffic_Radar/Hardware/SS_JET_ORIN/SS_JetOrin_V1/SS_JetOrin_V1.kicad_pcb

## KiCad design Hardware/SS_JET_ORIN/SS_JetOrin_V1/SS_JetOrin_V1.kicad_pcb (2023-10-18)

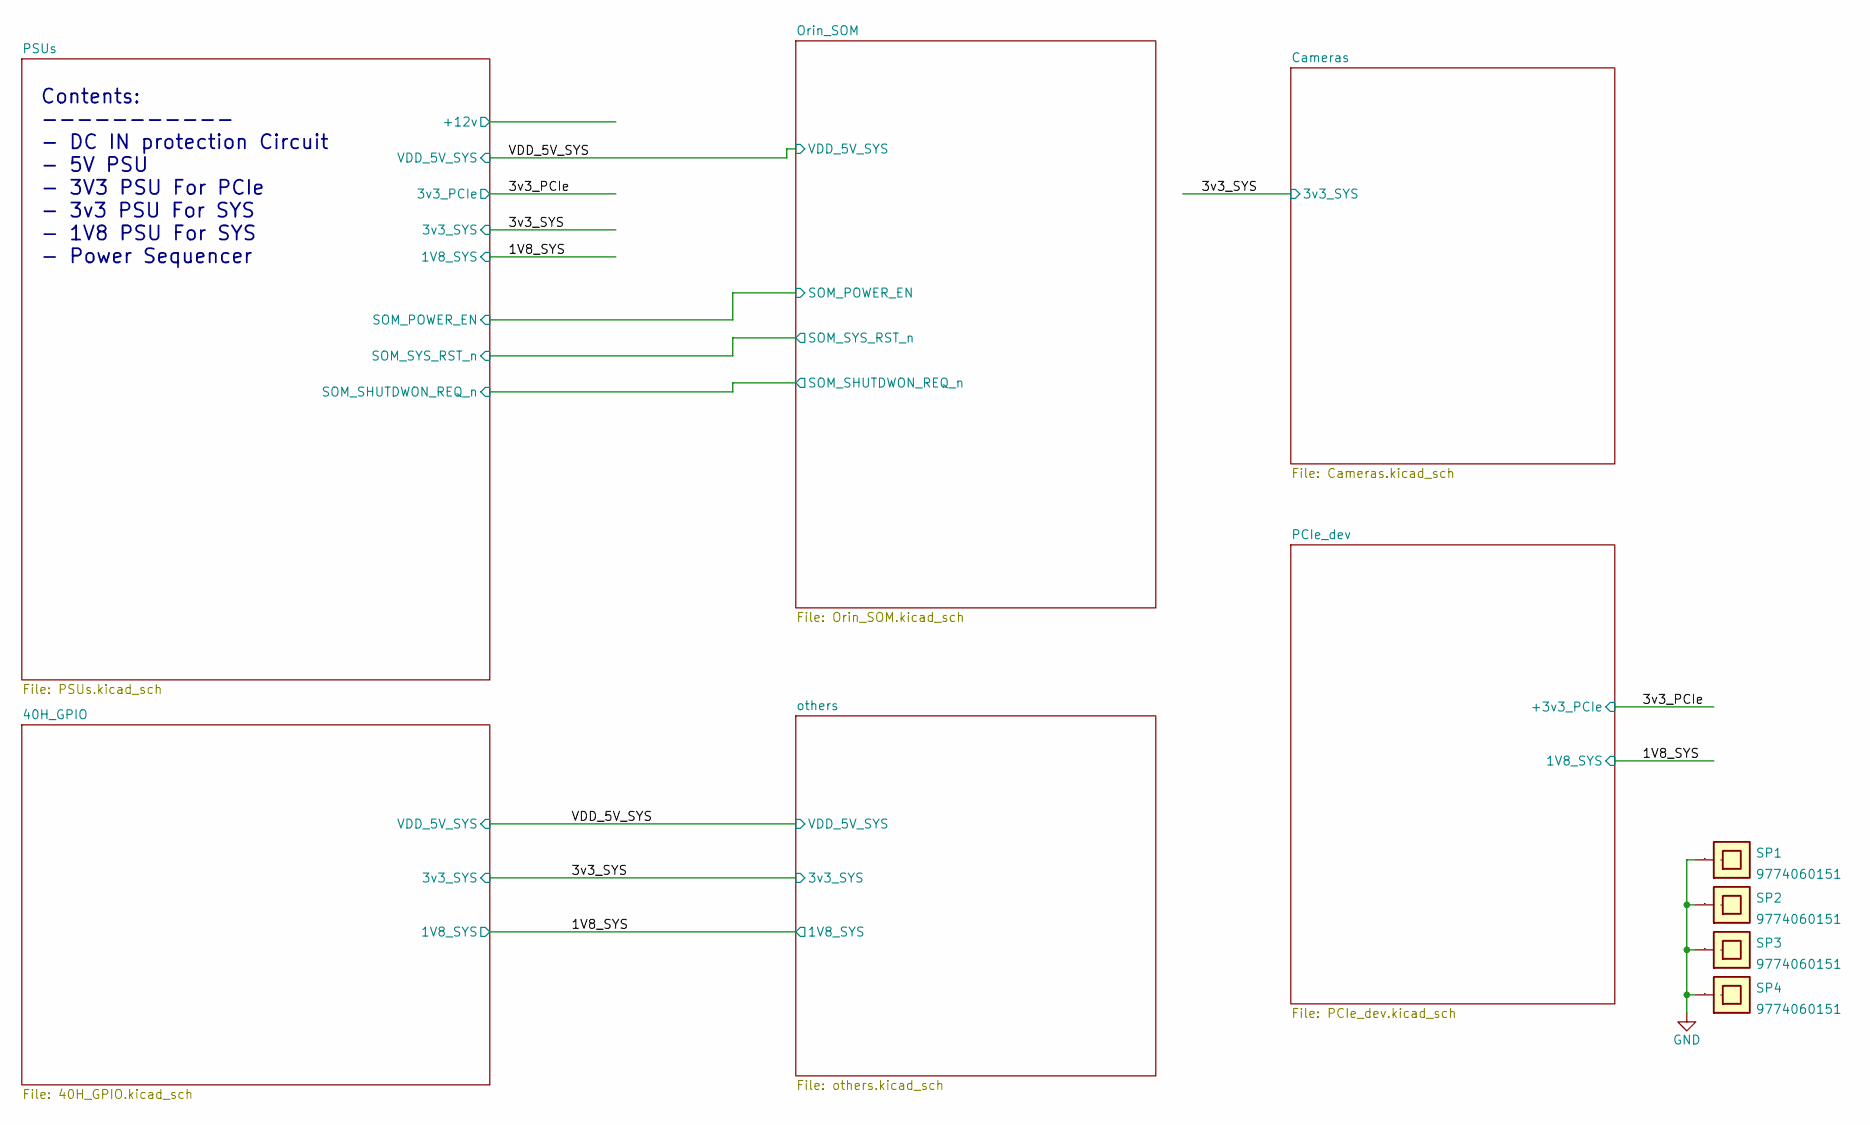
[picture p44: schematic SS_JetOrin_V1.kicad_sch]

Parts:
SP1, SP2, SP3, SP4: 9774060151; MPN 9774060151

Connections:
GND: SP1.1, SP2.1, SP3.1, SP4.1; also elsewhere on the board

Notes on the sheet:
Contents: ----------- - DC IN protection Circuit - 5V PSU - 3V3 PSU For PCIe - 3v3 PSU For SYS - 1V8 PSU For SYS - Power Sequencer

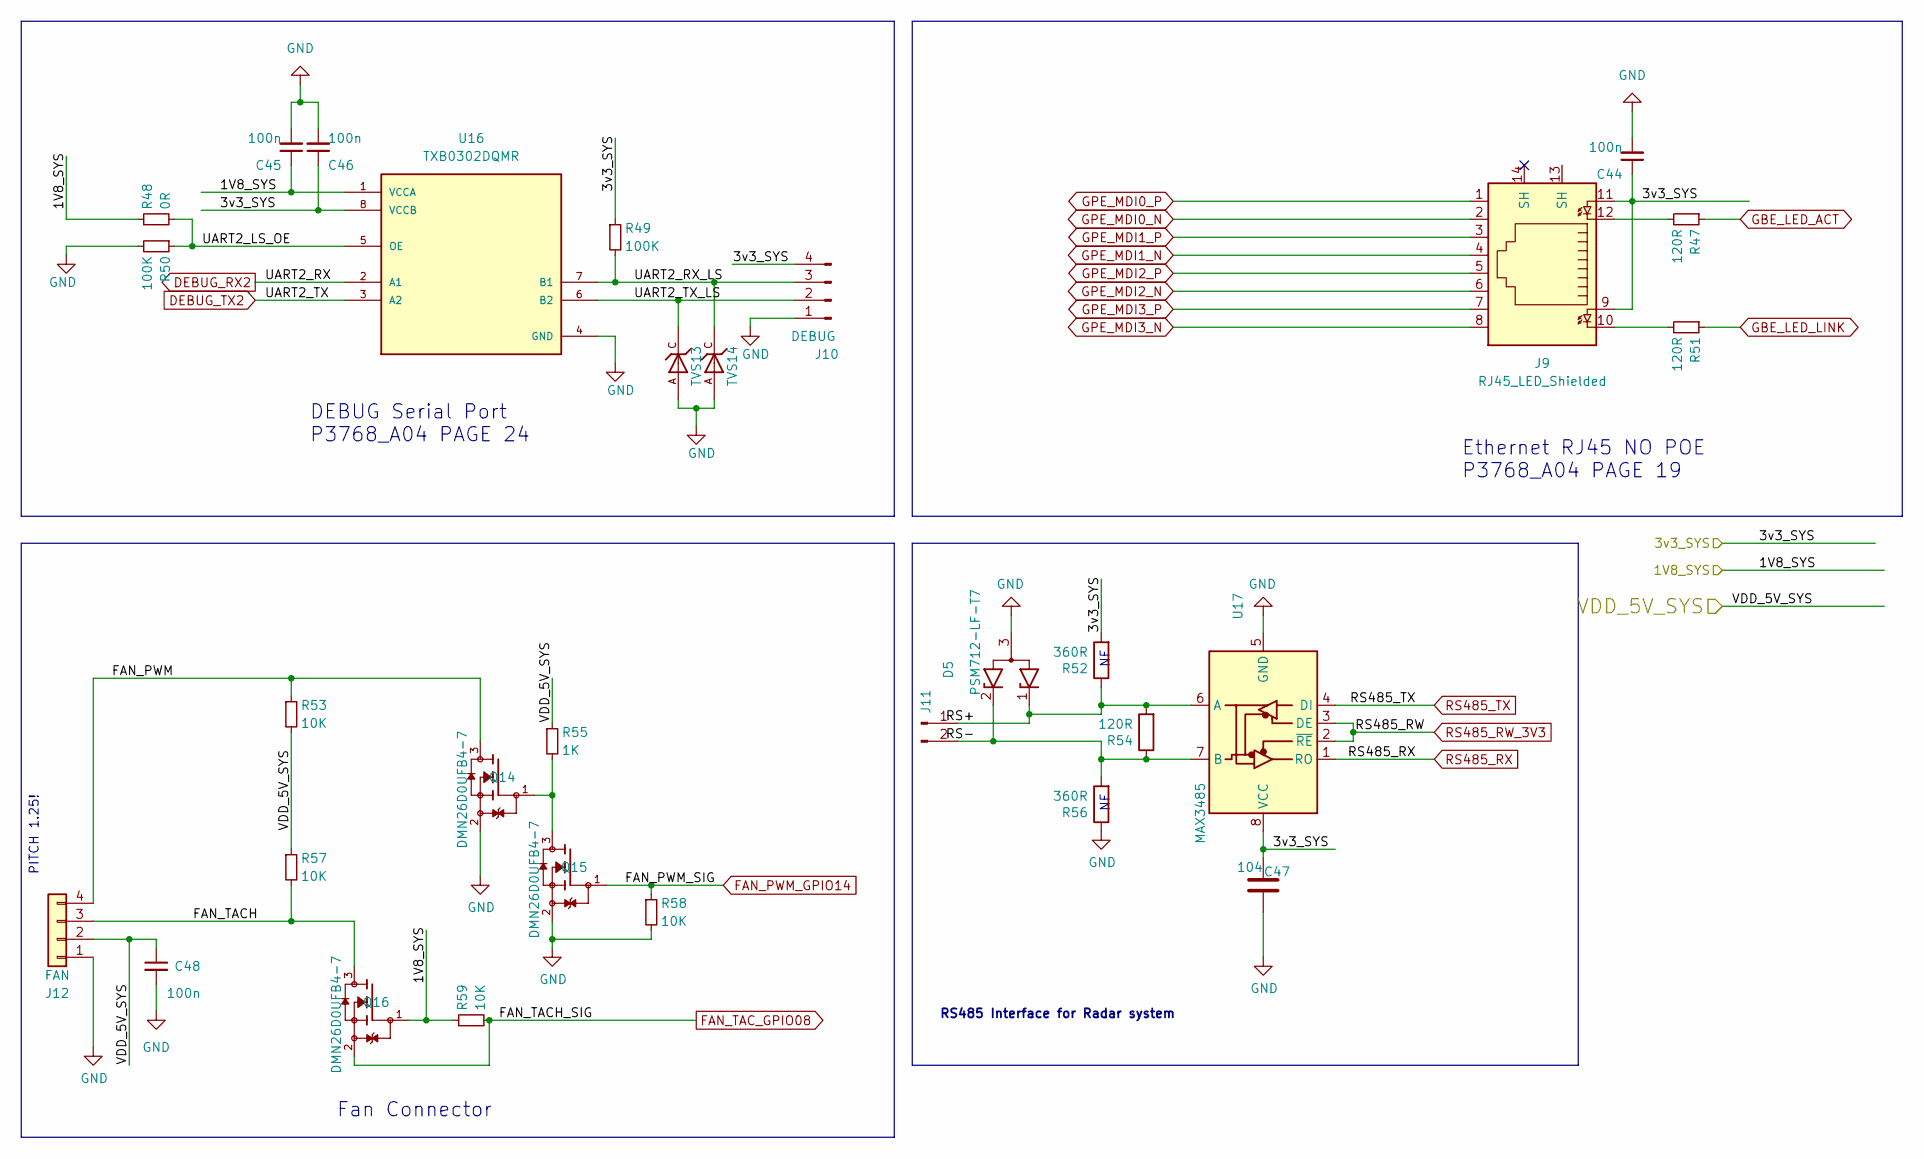
[picture p45: schematic others.kicad_sch]

Parts:
C44, C45, C46, C48: 100n; C_0201_0603Metric; LCSC C307380
C47: 104; C_0201_0603Metric; Part Description 0.1uF 10% 100V Ceramic Capacitor X5R 04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; LCSC C307380
D5: PSM712-LF-T7; SOT-23; LCSC C32677
J9: RJ45_LED_Shielded; RJ45-TH_R-RJ45R08P-C000; LCSC C386757
J10: DEBUG; PinHeader_1x04_P2.54mm_Vertical
J11: Conn_01x02_Male; PinHeader_1x02_P2.54mm_Vertical
J12: FAN; PinHeader_1x04_P2.54mm_Vertical; Part Description Wire-To-Board Connector, Right Angle, 2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; LCSC C5116483
Q14, Q15, Q16: DMN26D0UFB4-7; TRXDFN100X60X40-3N; PARTREV 12-2; LCSC C260867
R47, R51: 120R; R_0201_0603Metric; LCSC C295718
R48: 0R; R_0201_0603Metric; LCSC C106228
R49, R50: 100K; R_0201_0603Metric; LCSC C106224
R52, R56: 360R; R_0201_0603Metric; Part Description Resistor 1K M1005 1% 63mW; LCSC C2930003
R53, R57, R58, R59: 10K; R_0201_0603Metric; LCSC C106225
R54: 120R; R_0201_0603Metric; Part Description Resistor 1K M1005 1% 63mW; LCSC C295718
R55: 1K; R_0201_0603Metric; LCSC C131396
TVS13, TVS14: ESD9L5.0ST5G; DIOM1006X40N; PARTREV 7; LCSC C2682269
U16: TXB0302DQMR; IC_TXB0302DQMR; LCSC C2652938
U17: MAX3485; SOIC-8_3.9x4.9mm_P1.27mm; LCSC C9943

Connections:
/1V8_SYS: C45.1, Q16.1, R48.1, R59.1, U16.1 (VCCA); also elsewhere on the board
/3v3_SYS: C44.1, C46.1, C47.1, J9.9, J9.11, J10.4, R49.1, R52.2, U16.8 (VCCB), U17.8 (VCC); also elsewhere on the board
/VDD_5V_SYS: C48.1, J12.2, R53.2, R55.1, R57.1; also elsewhere on the board
/others/FAN_PWM: J12.4, Q14.3, R53.1
/others/FAN_TACH: J12.3, Q16.3, R57.2
/others/RS+: D5.1 (K1), J11.1, R52.1, R54.2, U17.6 (A)
/others/RS-: D5.2 (K2), J11.2, R54.1, R56.2, U17.7 (B)
/others/UART2_LS_OE: R48.2, R50.1, U16.5 (OE)
/others/UART2_RX_LS: J10.3, R49.2, TVS14.C, U16.7 (B1)
/others/UART2_TX_LS: J10.2, TVS13.C, U16.6 (B2)
DEBUG_RX2: U16.2 (A1); also elsewhere on the board
DEBUG_TX2: U16.3 (A2); also elsewhere on the board
FAN_PWM_GPIO14: Q15.1, R58.1; also elsewhere on the board
FAN_TAC_GPIO08: Q16.2, R59.2; also elsewhere on the board
GBE_LED_ACT: R47.1; also elsewhere on the board
GBE_LED_LINK: R51.1; also elsewhere on the board
GND: C44.2, C45.2, C46.2, C47.2, C48.2, D5.3 (A), J10.1, J12.1, Q14.2, Q15.2, R50.2, R56.1, R58.2, TVS13.A, TVS14.A, U16.4 (GND), U17.5 (GND); also elsewhere on the board
GPE_MDI0_N: J9.2; also elsewhere on the board
GPE_MDI0_P: J9.1; also elsewhere on the board
GPE_MDI1_N: J9.4; also elsewhere on the board
GPE_MDI1_P: J9.3; also elsewhere on the board
GPE_MDI2_N: J9.6; also elsewhere on the board
GPE_MDI2_P: J9.5; also elsewhere on the board
GPE_MDI3_N: J9.8; also elsewhere on the board
GPE_MDI3_P: J9.7; also elsewhere on the board
unnamed: J9.10, R51.2
unnamed: J9.12, R47.2
unnamed: Q14.1, Q15.3, R55.2
RS485_RW_3V3: U17.2 (~RE), U17.3 (DE); also elsewhere on the board
RS485_RX: U17.1 (RO); also elsewhere on the board
RS485_TX: U17.4 (DI); also elsewhere on the board

Notes on the sheet:
DEBUG Serial Port P3768_A04 PAGE 24
Ethernet RJ45 NO POE P3768_A04 PAGE 19
RS485 Interface for Radar system
Fan Connector
PITCH 1.25!

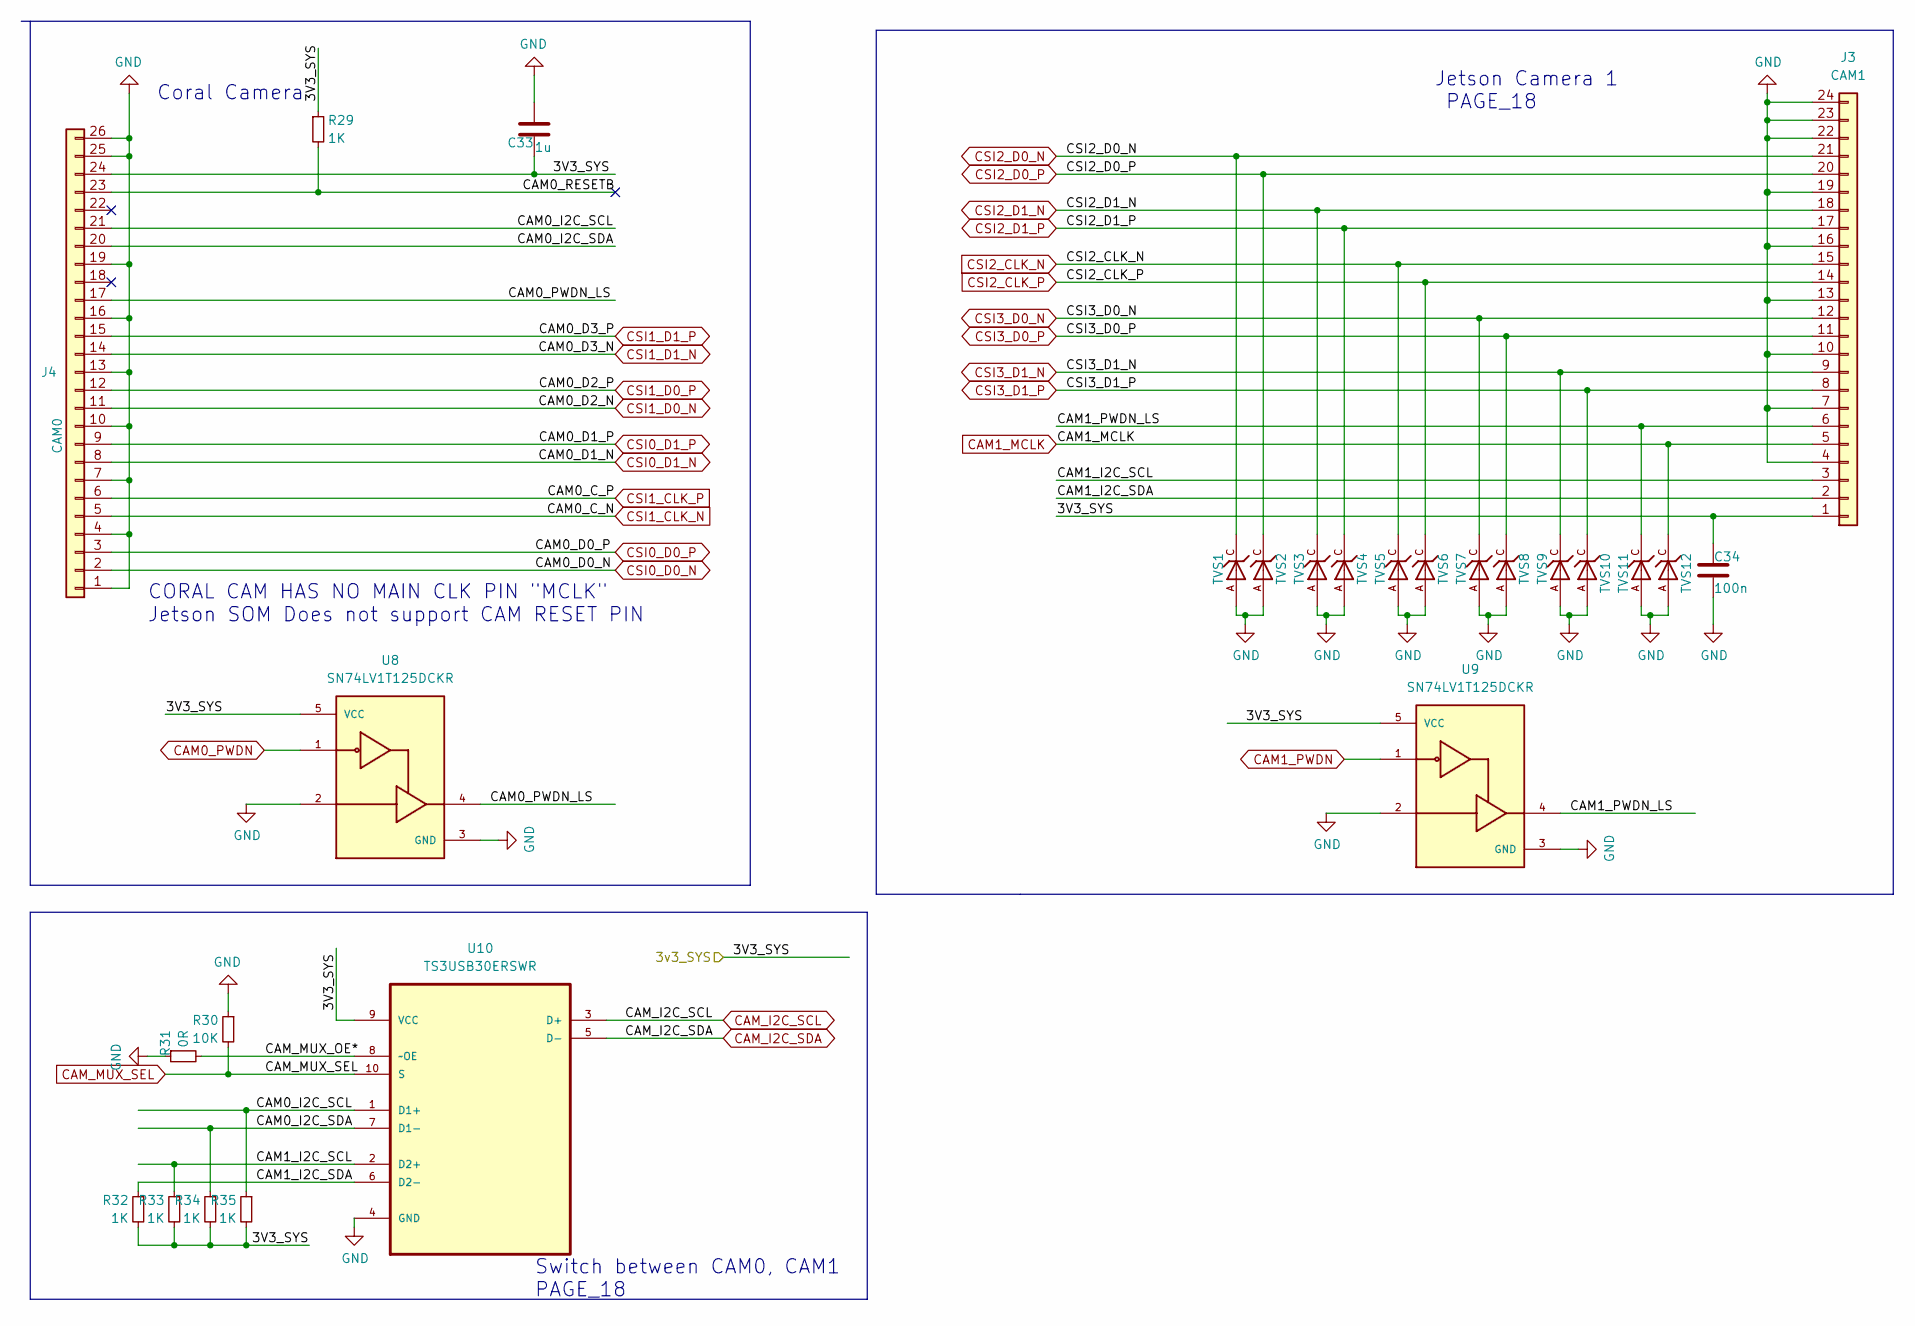
[picture p46: schematic Cameras.kicad_sch]

Parts:
C33: 1u; C_0201_0603Metric; LCSC C107005
C34: 100n; C_0201_0603Metric; Part Description 0.1uF 10% 100V Ceramic Capacitor X5R 04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; LCSC C307331
J3: CAM1; Hirose_FH12-22S-0.5SH_1x22-1MP_P0.50mm_Horizontal; LCSC C262668
J4: CAM0; FPC-SMD_P0.50-24P_QCHF-SM-H2.0; MPN FH12-24S-0.5SH(55); LCSC C262683
R29, R32, R33, R34, R35: 1K; R_0201_0603Metric; LCSC C131396
R30: 10K; R_0201_0603Metric; LCSC C106225
R31: 0R; R_0201_0603Metric; LCSC C106228
TVS1, TVS2, TVS3, TVS4, TVS5, TVS6, TVS7, TVS8, TVS9, TVS10, TVS11, TVS12: ESD9L5.0ST5G; DIOM1006X40N; PARTREV 7; LCSC C2682269
U8, U9: SN74LV1T125DCKR; SOT65P210X110-5N; PARTREV A; LCSC C75925
U10: TS3USB30ERSWR; QFN40P140X180X55-10N; MPN TS3USB30ERSWR

Connections:
/3v3_SYS: C33.1, C34.1, J3.1, J4.24, R29.1, R32.2, R33.2, R34.2, R35.2, U8.5 (VCC), U9.5 (VCC), U10.9 (VCC); also elsewhere on the board
/Cameras/CAM0_I2C_SCL: J4.21, R35.1, U10.1 (D1+)
/Cameras/CAM0_I2C_SDA: J4.20, R34.1, U10.7 (D1-)
/Cameras/CAM0_PWDN_LS: J4.17, U8.4
/Cameras/CAM0_RESETB: J4.23, R29.2
/Cameras/CAM1_I2C_SCL: J3.3, R33.1, U10.2 (D2+)
/Cameras/CAM1_I2C_SDA: J3.2, R32.1, U10.6 (D2-)
/Cameras/CAM1_PWDN_LS: J3.6, TVS11.C, U9.4
/Cameras/CAM_MUX_OE*: R31.2, U10.8 (~OE)
CAM0_PWDN: U8.1; also elsewhere on the board
CAM1_MCLK: J3.5, TVS12.C; also elsewhere on the board
CAM1_PWDN: U9.1; also elsewhere on the board
CAM_I2C_SCL: U10.3 (D+); also elsewhere on the board
CAM_I2C_SDA: U10.5 (D-); also elsewhere on the board
CAM_MUX_SEL: R30.2, U10.10 (S); also elsewhere on the board
CSI0_D0_N: J4.2; also elsewhere on the board
CSI0_D0_P: J4.3; also elsewhere on the board
CSI0_D1_N: J4.8; also elsewhere on the board
CSI0_D1_P: J4.9; also elsewhere on the board
CSI1_CLK_N: J4.5; also elsewhere on the board
CSI1_CLK_P: J4.6; also elsewhere on the board
CSI1_D0_N: J4.11; also elsewhere on the board
CSI1_D0_P: J4.12; also elsewhere on the board
CSI1_D1_N: J4.14; also elsewhere on the board
CSI1_D1_P: J4.15; also elsewhere on the board
CSI2_CLK_N: J3.15, TVS5.C; also elsewhere on the board
CSI2_CLK_P: J3.14, TVS6.C; also elsewhere on the board
CSI2_D0_N: J3.21, TVS1.C; also elsewhere on the board
CSI2_D0_P: J3.20, TVS2.C; also elsewhere on the board
CSI2_D1_N: J3.18, TVS3.C; also elsewhere on the board
CSI2_D1_P: J3.17, TVS4.C; also elsewhere on the board
CSI3_D0_N: J3.12, TVS7.C; also elsewhere on the board
CSI3_D0_P: J3.11, TVS8.C; also elsewhere on the board
CSI3_D1_N: J3.9, TVS9.C; also elsewhere on the board
CSI3_D1_P: J3.8, TVS10.C; also elsewhere on the board
GND: C33.2, C34.2, J3.4, J3.7, J3.10, J3.13, J3.16, J3.19, J3.22, J3.23, J3.24, J4.1, J4.4, J4.7, J4.10, J4.13, J4.16, J4.19, J4.25, J4.26, R30.1, R31.1, TVS1.A, TVS2.A, TVS3.A, TVS4.A, TVS5.A, TVS6.A, TVS7.A, TVS8.A, TVS9.A, TVS10.A, TVS11.A, TVS12.A, U8.2, U8.3 (GND), U9.2, U9.3 (GND), U10.4 (GND); also elsewhere on the board

Notes on the sheet:
CORAL CAM HAS NO MAIN CLK PIN "MCLK" Jetson SOM Does not support CAM RESET PIN
Coral Camera
Switch between CAM0, CAM1 PAGE_18
Jetson Camera 1 PAGE_18

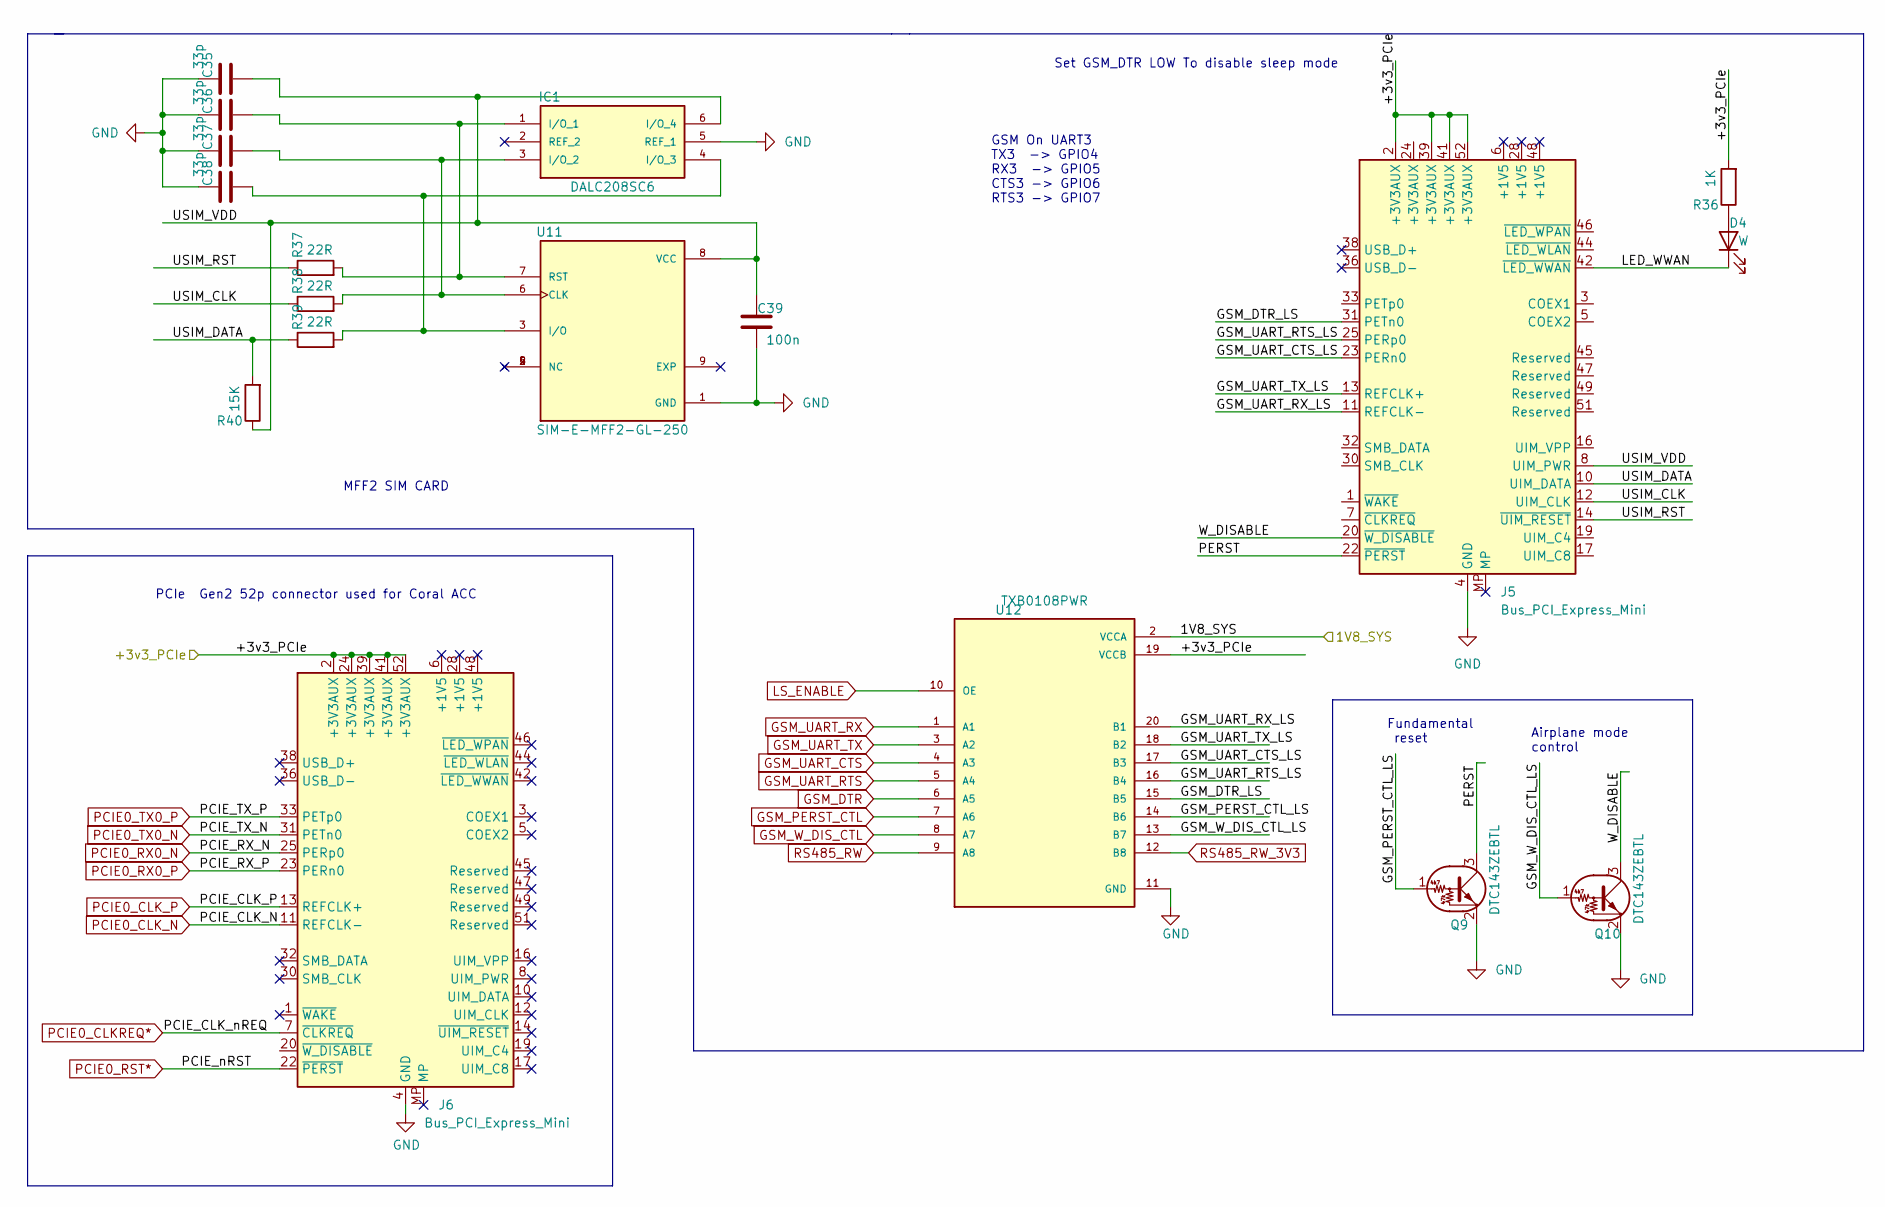
[picture p47: schematic PCIe_dev.kicad_sch]

Parts:
C35, C36, C37, C38: 33p; C_0201_0603Metric; LCSC C277477
C39: 100n; C_0201_0603Metric; Part Description 0.1uF 10% 100V Ceramic Capacitor X5R 04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; LCSC C307380
D4: W; LED_0402_1005Metric; LCSC C130724
IC1: DALC208SC6; SOT95P280X145-6N; MOUSER_PART_NUMBER 511-DALC208SC6
J5: Bus_PCI_Express_Mini; Quectel_EG25-G_Mini_PCIe; LCSC C266899
J6: Bus_PCI_Express_Mini; BUS_PCI_Express_Mini_Half; LCSC C266899
Q9, Q10: DTC143ZEBTL; SOTFL50P160X85-3N; LCSC C308696
R36: 1K; R_0201_0603Metric; LCSC C131396
R37, R38, R39: 22R; R_0201_0603Metric; LCSC C155743
R40: 15K; R_0201_0603Metric; LCSC C965337
U11: SIM-E-MFF2-GL-250; PSON127P500X600X82-9N; PARTREV V1.1
U12: TXB0108PWR; SOP65P640X120-20N; PARTREV H; LCSC C53406

Connections:
/1V8_SYS: U12.2 (VCCA); also elsewhere on the board
/3v3_PCIe: J5.2 (+3V3AUX), J5.39 (+3V3AUX), J5.41 (+3V3AUX), J5.52 (+3V3AUX), J6.2 (+3V3AUX), J6.24 (+3V3AUX), J6.39 (+3V3AUX), J6.41 (+3V3AUX), J6.52 (+3V3AUX), R36.2, U12.19 (VCCB); also elsewhere on the board
/PCIe_dev/GSM_DTR_LS: J5.31 (PETn0), U12.15 (B5)
/PCIe_dev/GSM_PERST_CTL_LS: Q9.1 (B), U12.14 (B6)
/PCIe_dev/GSM_UART_CTS_LS: J5.23 (PERn0), U12.17 (B3)
/PCIe_dev/GSM_UART_RTS_LS: J5.25 (PERp0), U12.16 (B4)
/PCIe_dev/GSM_UART_RX_LS: J5.11 (REFCLK-), U12.20 (B1)
/PCIe_dev/GSM_UART_TX_LS: J5.13 (REFCLK+), U12.18 (B2)
/PCIe_dev/GSM_W_DIS_CTL_LS: Q10.1 (B), U12.13 (B7)
/PCIe_dev/LED_WWAN: D4.1 (K), J5.42 (~LED_WWAN)
/PCIe_dev/PERST: J5.22 (~PERST), Q9.3 (C)
/PCIe_dev/USIM_CLK: J5.12 (UIM_CLK), R38.1
/PCIe_dev/USIM_DATA: J5.10 (UIM_DATA), R39.1, R40.2
/PCIe_dev/USIM_RST: J5.14 (~UIM_RESET), R37.1
/PCIe_dev/USIM_VDD: C35.2, C39.1, IC1.6 (I/O_4), J5.8 (UIM_PWR), R40.1, U11.8 (VCC)
/PCIe_dev/W_DISABLE: J5.20 (~W_DISABLE), Q10.3 (C)
GND: C35.1, C36.1, C37.1, C38.1, C39.2, IC1.5 (REF_1), J5.4 (GND), J5.9 (GND), J5.15 (GND), J5.18 (GND), J5.21 (GND), J5.26 (GND), J5.27 (GND), J5.29 (GND), J5.34 (GND), J5.35 (GND), J5.37 (GND), J5.40 (GND), J5.43 (GND), J5.50 (GND), J6.4 (GND), J6.9 (GND), J6.15 (GND), J6.18 (GND), J6.21 (GND), J6.26 (GND), J6.27 (GND), J6.29 (GND), J6.34 (GND), J6.35 (GND), J6.37 (GND), J6.40 (GND), J6.43 (GND), J6.50 (GND), Q9.2 (E), Q10.2 (E), U11.1 (GND), U12.11 (GND); also elsewhere on the board
GSM_DTR: U12.6 (A5); also elsewhere on the board
GSM_PERST_CTL: U12.7 (A6); also elsewhere on the board
GSM_UART_CTS: U12.4 (A3); also elsewhere on the board
GSM_UART_RTS: U12.5 (A4); also elsewhere on the board
GSM_UART_RX: U12.1 (A1); also elsewhere on the board
GSM_UART_TX: U12.3 (A2); also elsewhere on the board
GSM_W_DIS_CTL: U12.8 (A7); also elsewhere on the board
LS_ENABLE: U12.10 (OE); also elsewhere on the board
unnamed: C36.2, IC1.1 (I/O_1), R37.2, U11.7 (RST)
unnamed: C37.2, IC1.3 (I/O_2), R38.2, U11.6 (CLK)
unnamed: C38.2, IC1.4 (I/O_3), R39.2, U11.3 (I/O)
unnamed: D4.2 (A), R36.1
PCIE0_CLKREQ*: J6.7 (~CLKREQ); also elsewhere on the board
PCIE0_CLK_N: J6.11 (REFCLK-); also elsewhere on the board
PCIE0_CLK_P: J6.13 (REFCLK+); also elsewhere on the board
PCIE0_RST*: J6.22 (~PERST); also elsewhere on the board
PCIE0_RX0_N: J6.25 (PERp0); also elsewhere on the board
PCIE0_RX0_P: J6.23 (PERn0); also elsewhere on the board
PCIE0_TX0_N: J6.31 (PETn0); also elsewhere on the board
PCIE0_TX0_P: J6.33 (PETp0); also elsewhere on the board
RS485_RW: U12.9 (A8); also elsewhere on the board
RS485_RW_3V3: U12.12 (B8); also elsewhere on the board

Notes on the sheet:
GSM On UART3 TX3 -> GPIO4 RX3 -> GPIO5 CTS3 -> GPIO6 RTS3 -> GPIO7
Fundamental reset
Airplane mode control
PCIe Gen2 52p connector used for Coral ACC
Set GSM_DTR LOW To disable sleep mode
MFF2 SIM CARD

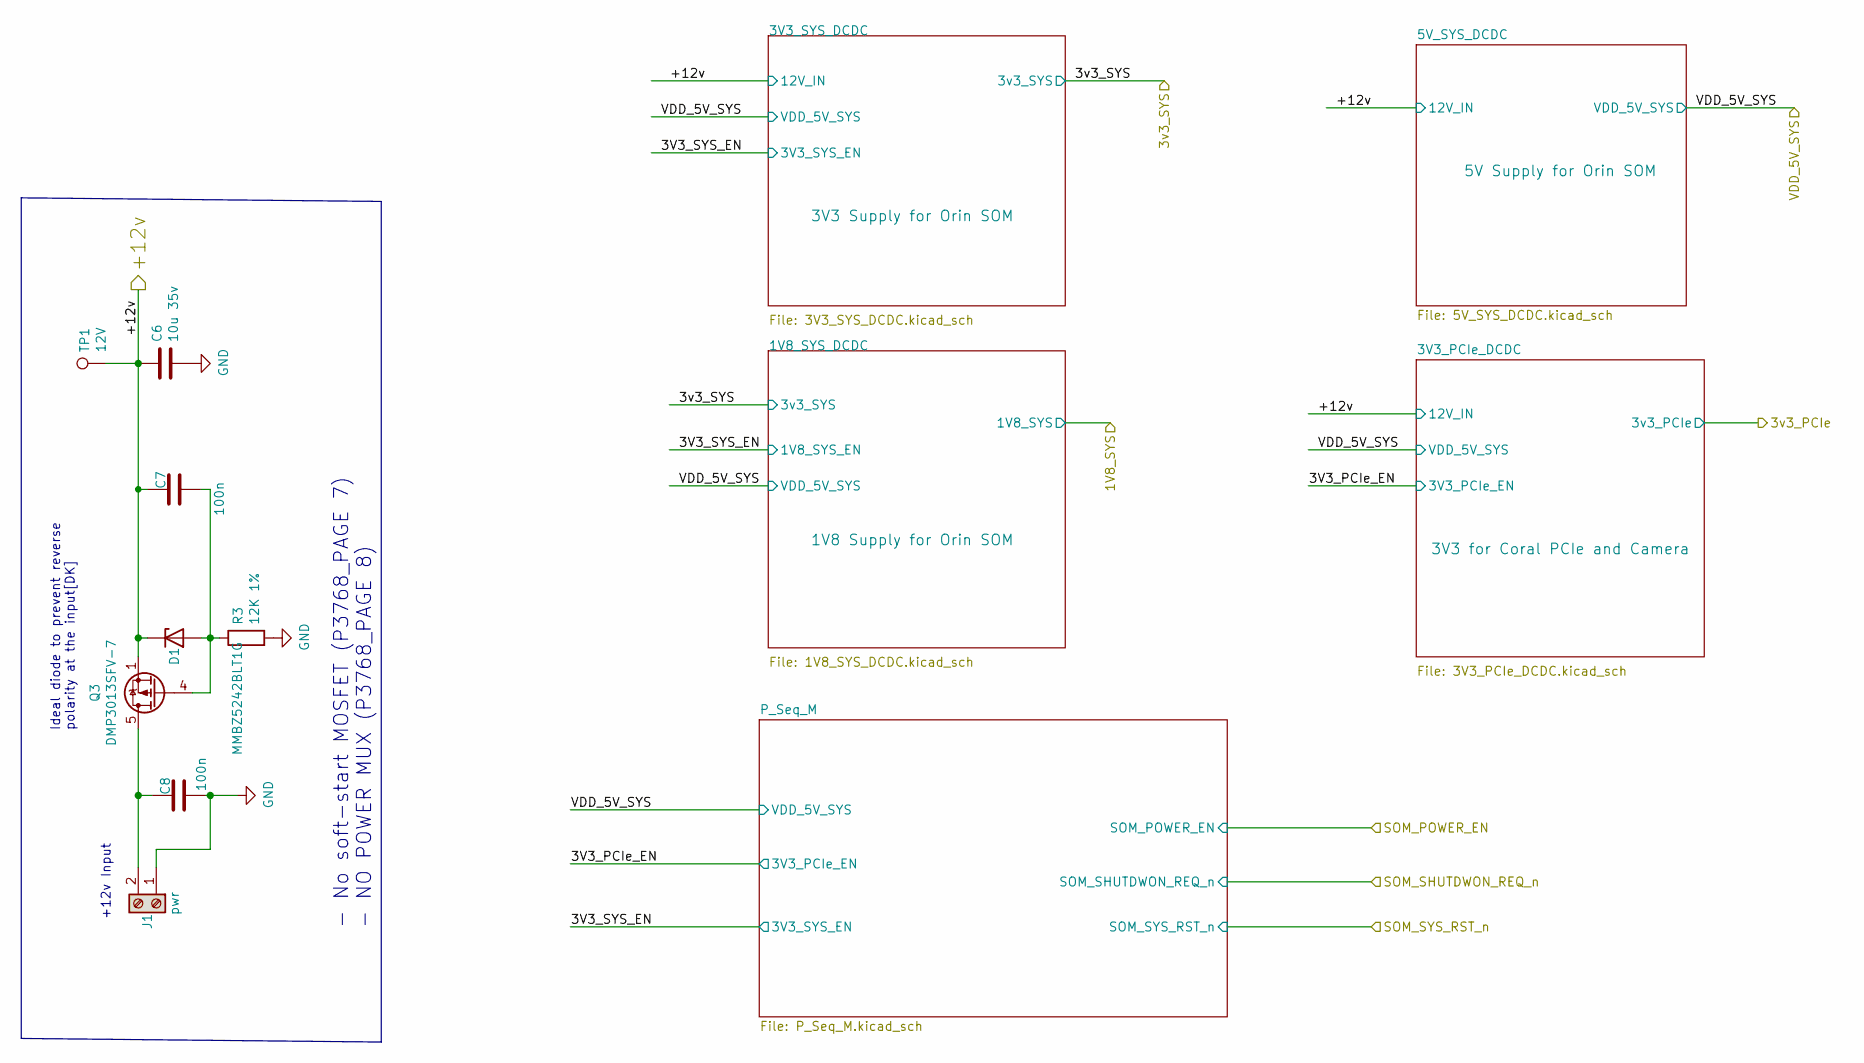
[picture p48: schematic PSUs.kicad_sch]

Parts:
C6: 10u 35v; C_0603_1608Metric; LCSC C194427
C7, C8: 100n; C_0201_0603Metric; Part Description 0.1uF 10% 100V Ceramic Capacitor X5R 04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; LCSC C307380
D1: MMBZ5242BLT1G; SOT-23; Part Description Zener Diode 12V 225mW 5% Surface Mount 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; LCSC C236184
J1: pwr; TerminalBlock_bornier-2_P5.08mm; LCSC C430455
Q3: DMP3013SFV-7; Diodes_PowerDI3333-8; Part Description DMP3013SFV-7 - Power MOSFET, P Channel,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; LCSC C264098
R3: 12K 1%; R_0201_0603Metric; Part Description Resistor 12K M1005 1% 63mW; LCSC C226413
TP1: 12V; TestPoint_Pad_D1.0mm

Connections:
/PSUs/+12v: C6.1, C7.1, D1.3 (K), Q3.1 (S), Q3.2 (S), Q3.3 (S), TP1.1; also elsewhere on the board
GND: C6.2, C8.2, J1.1, R3.2; also elsewhere on the board
unnamed: C7.2, D1.1 (A), Q3.4 (G), R3.1
unnamed: C8.1, J1.2, Q3.5 (D)

Notes on the sheet:
- No soft-start MOSFET (P3768_PAGE 7) - NO POWER MUX (P3768_PAGE 8)
Ideal diode to prevent reverse polarity at the input[DK]
+12v Input

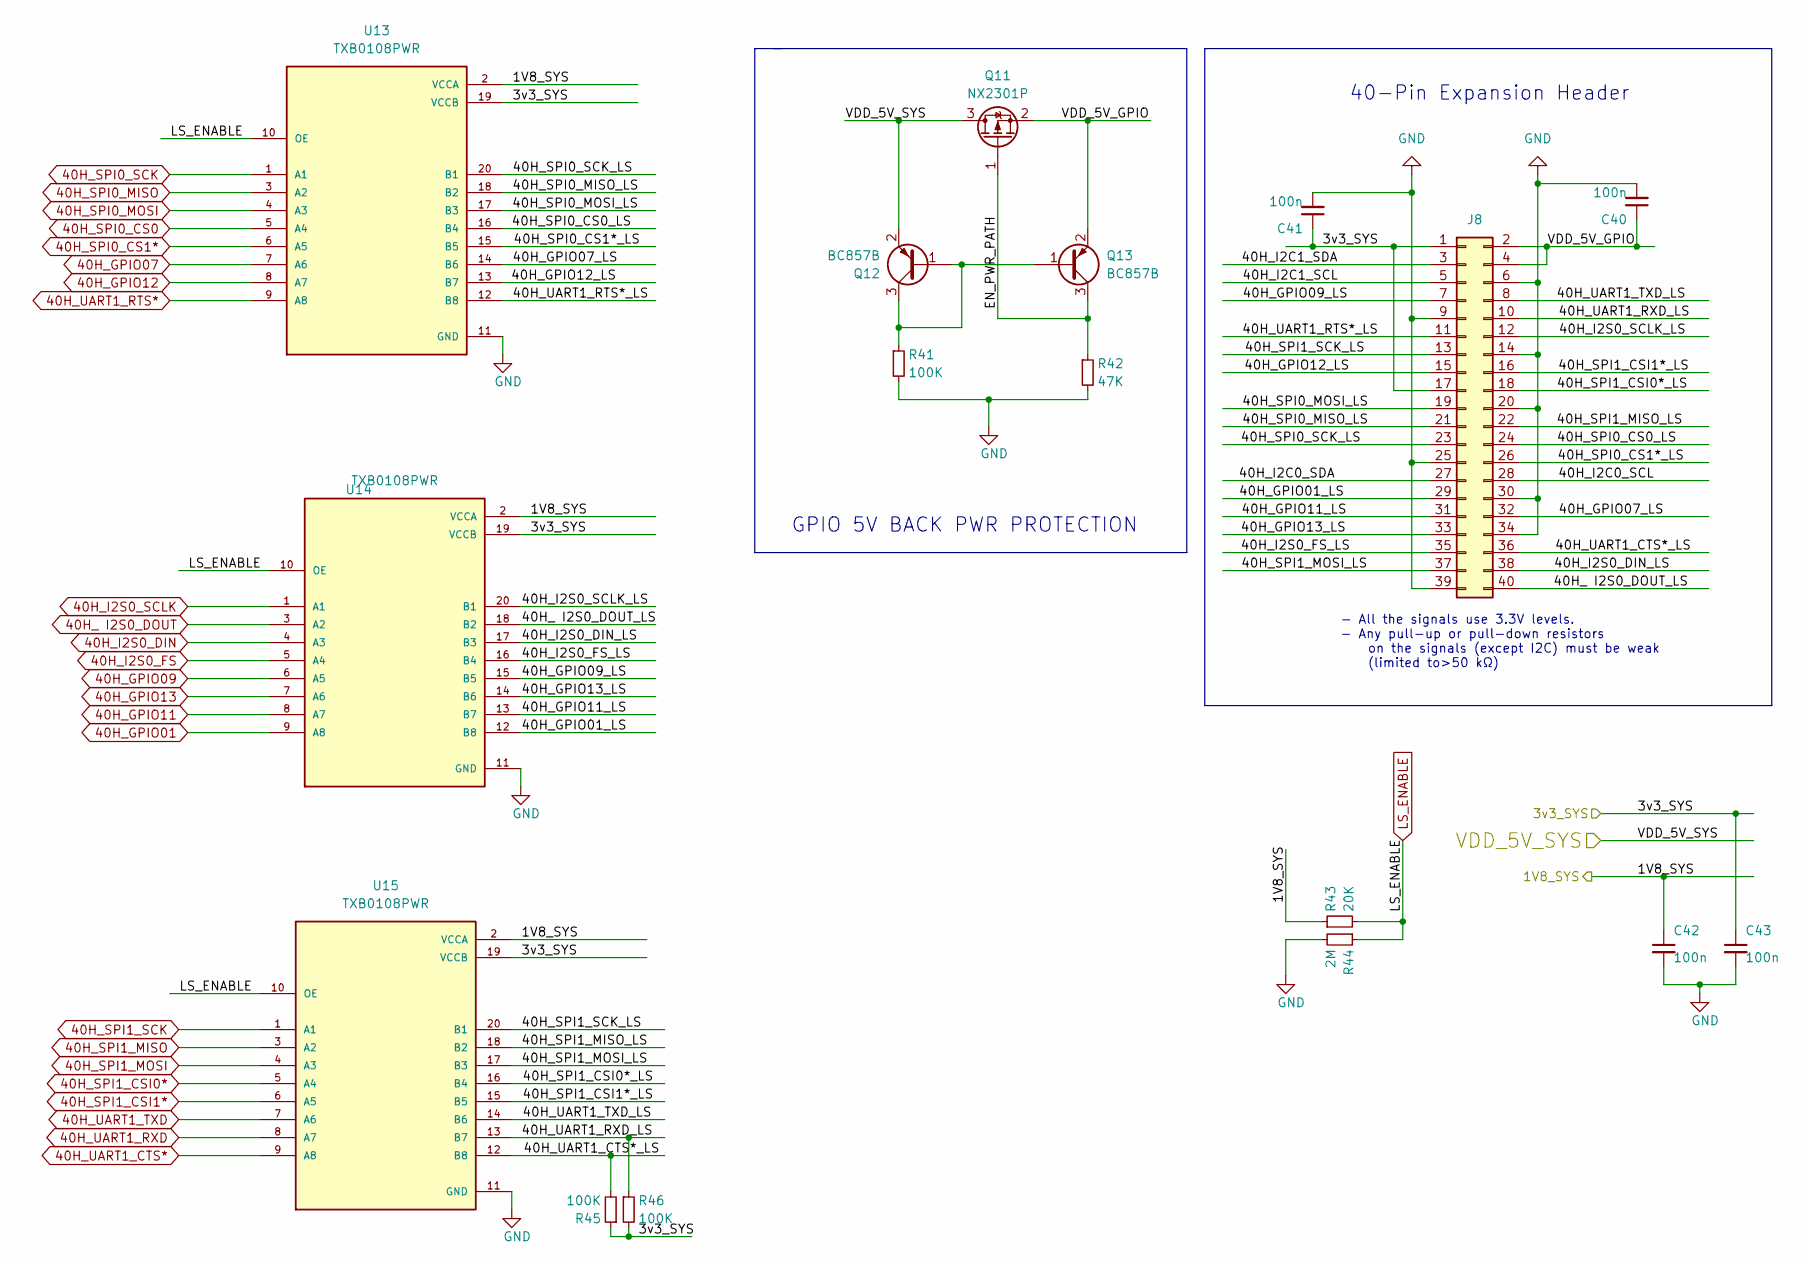
[picture p49: schematic 40H_GPIO.kicad_sch]

Parts:
C40, C41, C42, C43: 100n; C_0201_0603Metric; LCSC C307380
J8: Conn_02x20_Odd_Even; PinHeader_2x20_P2.54mm_Vertical
Q11: NX2301P; SOT-23; LCSC C191273
Q12, Q13: BC857B; SOT-23; LCSC C556165
R41, R45, R46: 100K; R_0201_0603Metric; LCSC C106224
R42: 47K; R_0201_0603Metric; LCSC C138139
R43: 20K; R_0201_0603Metric; LCSC C295787
R44: 2M; R_0201_0603Metric; LCSC C106228
U13, U14, U15: TXB0108PWR; SOP65P640X120-20N; PARTREV H; LCSC C53406

Connections:
40H_ I2S0_DOUT: U14.3 (A2); also elsewhere on the board
40H_GPIO01: U14.9 (A8); also elsewhere on the board
40H_GPIO07: U13.7 (A6); also elsewhere on the board
40H_GPIO09: U14.6 (A5); also elsewhere on the board
40H_GPIO11: U14.8 (A7); also elsewhere on the board
40H_GPIO12: U13.8 (A7); also elsewhere on the board
40H_GPIO13: U14.7 (A6); also elsewhere on the board
40H_I2S0_DIN: U14.4 (A3); also elsewhere on the board
40H_I2S0_FS: U14.5 (A4); also elsewhere on the board
40H_I2S0_SCLK: U14.1 (A1); also elsewhere on the board
40H_SPI0_CS0: U13.5 (A4); also elsewhere on the board
40H_SPI0_CS1*: U13.6 (A5); also elsewhere on the board
40H_SPI0_MISO: U13.3 (A2); also elsewhere on the board
40H_SPI0_MOSI: U13.4 (A3); also elsewhere on the board
40H_SPI0_SCK: U13.1 (A1); also elsewhere on the board
40H_SPI1_CSI0*: U15.5 (A4); also elsewhere on the board
40H_SPI1_CSI1*: U15.6 (A5); also elsewhere on the board
40H_SPI1_MISO: U15.3 (A2); also elsewhere on the board
40H_SPI1_MOSI: U15.4 (A3); also elsewhere on the board
40H_SPI1_SCK: U15.1 (A1); also elsewhere on the board
40H_UART1_CTS*: U15.9 (A8); also elsewhere on the board
40H_UART1_RTS*: U13.9 (A8); also elsewhere on the board
40H_UART1_RXD: U15.8 (A7); also elsewhere on the board
40H_UART1_TXD: U15.7 (A6); also elsewhere on the board
/1V8_SYS: C42.1, R43.1, U13.2 (VCCA), U14.2 (VCCA), U15.2 (VCCA); also elsewhere on the board
/3v3_SYS: C41.1, C43.1, J8.1, J8.17, R45.1, R46.2, U13.19 (VCCB), U14.19 (VCCB), U15.19 (VCCB); also elsewhere on the board
/40H_GPIO/40H_ I2S0_DOUT_LS: J8.40, U14.18 (B2)
/40H_GPIO/40H_GPIO01_LS: J8.29, U14.12 (B8)
/40H_GPIO/40H_GPIO07_LS: J8.32, U13.14 (B6)
/40H_GPIO/40H_GPIO09_LS: J8.7, U14.15 (B5)
/40H_GPIO/40H_GPIO11_LS: J8.31, U14.13 (B7)
/40H_GPIO/40H_GPIO12_LS: J8.15, U13.13 (B7)
/40H_GPIO/40H_GPIO13_LS: J8.33, U14.14 (B6)
/40H_GPIO/40H_I2C0_SCL: J8.28
/40H_GPIO/40H_I2C0_SDA: J8.27
/40H_GPIO/40H_I2C1_SCL: J8.5
/40H_GPIO/40H_I2C1_SDA: J8.3
/40H_GPIO/40H_I2S0_DIN_LS: J8.38, U14.17 (B3)
/40H_GPIO/40H_I2S0_FS_LS: J8.35, U14.16 (B4)
/40H_GPIO/40H_I2S0_SCLK_LS: J8.12, U14.20 (B1)
/40H_GPIO/40H_SPI0_CS0_LS: J8.24, U13.16 (B4)
/40H_GPIO/40H_SPI0_CS1*_LS: J8.26, U13.15 (B5)
/40H_GPIO/40H_SPI0_MISO_LS: J8.21, U13.18 (B2)
/40H_GPIO/40H_SPI0_MOSI_LS: J8.19, U13.17 (B3)
/40H_GPIO/40H_SPI0_SCK_LS: J8.23, U13.20 (B1)
/40H_GPIO/40H_SPI1_CSI0*_LS: J8.18, U15.16 (B4)
/40H_GPIO/40H_SPI1_CSI1*_LS: J8.16, U15.15 (B5)
/40H_GPIO/40H_SPI1_MISO_LS: J8.22, U15.18 (B2)
/40H_GPIO/40H_SPI1_MOSI_LS: J8.37, U15.17 (B3)
/40H_GPIO/40H_SPI1_SCK_LS: J8.13, U15.20 (B1)
/40H_GPIO/40H_UART1_CTS*_LS: J8.36, R45.2, U15.12 (B8)
/40H_GPIO/40H_UART1_RTS*_LS: J8.11, U13.12 (B8)
/40H_GPIO/40H_UART1_RXD_LS: J8.10, R46.1, U15.13 (B7)
/40H_GPIO/40H_UART1_TXD_LS: J8.8, U15.14 (B6)
/40H_GPIO/EN_PWR_PATH: Q11.1 (G), Q13.3 (C), R42.1
/40H_GPIO/VDD_5V_GPIO: C40.1, J8.2, J8.4, Q11.2 (S), Q13.2 (E)
/VDD_5V_SYS: Q11.3 (D), Q12.2 (E); also elsewhere on the board
GND: C40.2, C41.2, C42.2, C43.2, J8.6, J8.9, J8.14, J8.20, J8.25, J8.30, J8.34, J8.39, R41.2, R42.2, R44.2, U13.11 (GND), U14.11 (GND), U15.11 (GND); also elsewhere on the board
LS_ENABLE: R43.2, R44.1, U13.10 (OE), U14.10 (OE), U15.10 (OE); also elsewhere on the board
unnamed: Q12.1 (B), Q12.3 (C), Q13.1 (B), R41.1

Notes on the sheet:
40-Pin Expansion Header
GPIO 5V BACK PWR PROTECTION
- All the signals use 3.3V levels. - Any pull-up or pull-down resistors on the signals (except I2C) must be weak (limited to>50 kΩ)
