Mr-JoE1/SS_AI_Traffic_Radar/Hardware/SS_JET_ORIN/SS_JetOrin_V1/SS_JetOrin_V1.kicad_pcb

## KiCad design Hardware/SS_JET_ORIN/SS_JetOrin_V1/SS_JetOrin_V1.kicad_pcb (continued)

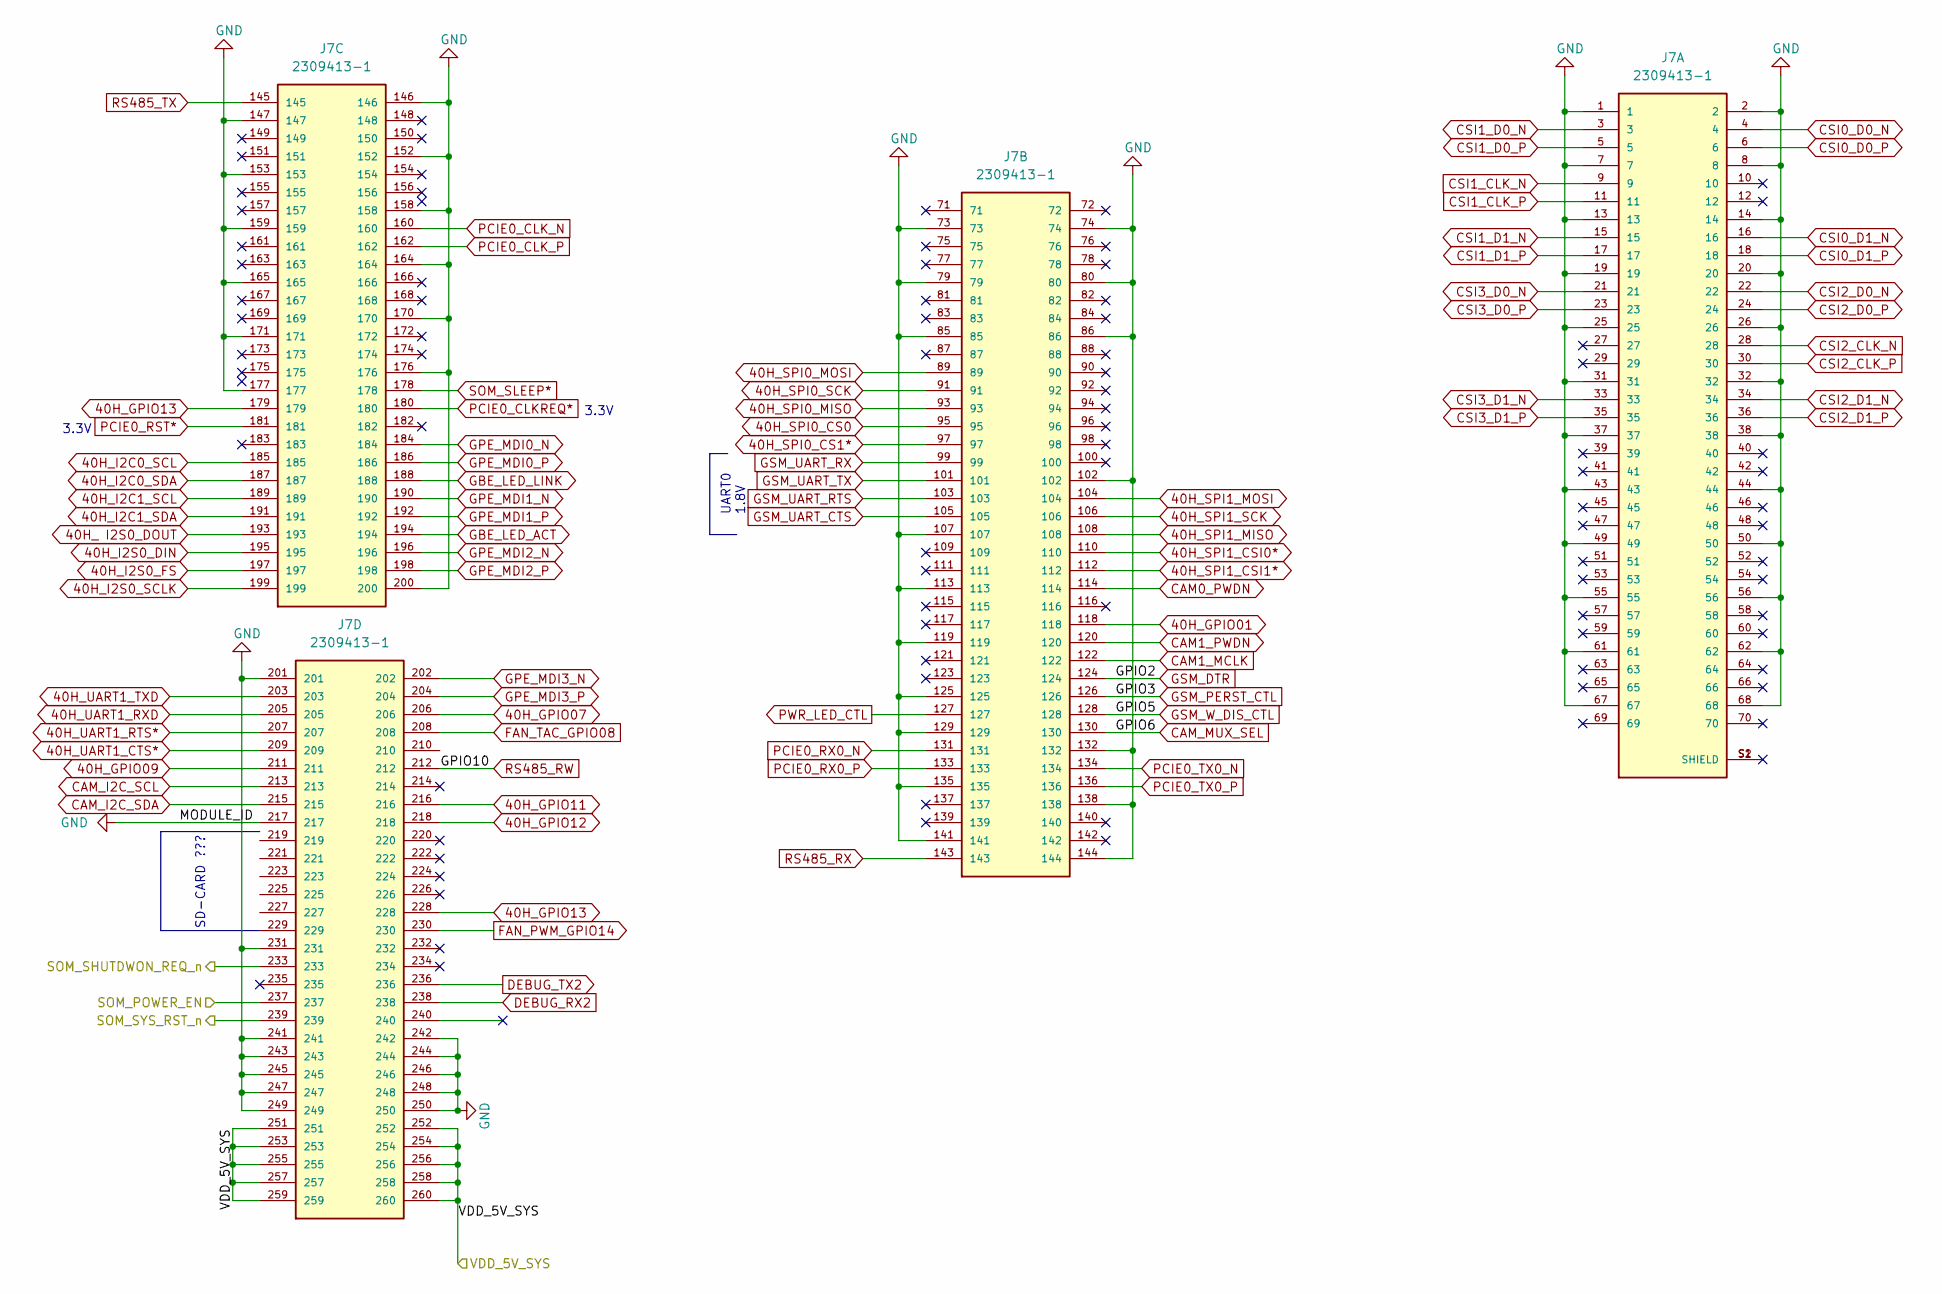
[picture p50: schematic Orin_SOM.kicad_sch]

Parts:
J7: 2309413-1; TE_2309413-1

Connections:
40H_ I2S0_DOUT: J7.193; also elsewhere on the board
40H_GPIO01: J7.118; also elsewhere on the board
40H_GPIO07: J7.206; also elsewhere on the board
40H_GPIO09: J7.211; also elsewhere on the board
40H_GPIO11: J7.216; also elsewhere on the board
40H_GPIO12: J7.218; also elsewhere on the board
40H_GPIO13: J7.179, J7.228; also elsewhere on the board
40H_I2C0_SCL: J7.185
40H_I2C0_SDA: J7.187
40H_I2C1_SCL: J7.189
40H_I2C1_SDA: J7.191
40H_I2S0_DIN: J7.195; also elsewhere on the board
40H_I2S0_FS: J7.197; also elsewhere on the board
40H_I2S0_SCLK: J7.199; also elsewhere on the board
40H_SPI0_CS0: J7.95; also elsewhere on the board
40H_SPI0_CS1*: J7.97; also elsewhere on the board
40H_SPI0_MISO: J7.93; also elsewhere on the board
40H_SPI0_MOSI: J7.89; also elsewhere on the board
40H_SPI0_SCK: J7.91; also elsewhere on the board
40H_SPI1_CSI0*: J7.110; also elsewhere on the board
40H_SPI1_CSI1*: J7.112; also elsewhere on the board
40H_SPI1_MISO: J7.108; also elsewhere on the board
40H_SPI1_MOSI: J7.104; also elsewhere on the board
40H_SPI1_SCK: J7.106; also elsewhere on the board
40H_UART1_CTS*: J7.209; also elsewhere on the board
40H_UART1_RTS*: J7.207; also elsewhere on the board
40H_UART1_RXD: J7.205; also elsewhere on the board
40H_UART1_TXD: J7.203; also elsewhere on the board
/Orin_SOM/SOM_POWER_EN: J7.237; also elsewhere on the board
/PSUs/P_Seq_M/SHUT_REQ: J7.233; also elsewhere on the board
/PSUs/P_Seq_M/SYS_RST: J7.239; also elsewhere on the board
/VDD_5V_SYS: J7.251, J7.252, J7.253, J7.254, J7.255, J7.256, J7.257, J7.258, J7.259, J7.260; also elsewhere on the board
CAM0_PWDN: J7.114; also elsewhere on the board
CAM1_MCLK: J7.122; also elsewhere on the board
CAM1_PWDN: J7.120; also elsewhere on the board
CAM_I2C_SCL: J7.213; also elsewhere on the board
CAM_I2C_SDA: J7.215; also elsewhere on the board
CAM_MUX_SEL: J7.130; also elsewhere on the board
CSI0_D0_N: J7.4; also elsewhere on the board
CSI0_D0_P: J7.6; also elsewhere on the board
CSI0_D1_N: J7.16; also elsewhere on the board
CSI0_D1_P: J7.18; also elsewhere on the board
CSI1_CLK_N: J7.9; also elsewhere on the board
CSI1_CLK_P: J7.11; also elsewhere on the board
CSI1_D0_N: J7.3; also elsewhere on the board
CSI1_D0_P: J7.5; also elsewhere on the board
CSI1_D1_N: J7.15; also elsewhere on the board
CSI1_D1_P: J7.17; also elsewhere on the board
CSI2_CLK_N: J7.28; also elsewhere on the board
CSI2_CLK_P: J7.30; also elsewhere on the board
CSI2_D0_N: J7.22; also elsewhere on the board
CSI2_D0_P: J7.24; also elsewhere on the board
CSI2_D1_N: J7.34; also elsewhere on the board
CSI2_D1_P: J7.36; also elsewhere on the board
CSI3_D0_N: J7.21; also elsewhere on the board
CSI3_D0_P: J7.23; also elsewhere on the board
CSI3_D1_N: J7.33; also elsewhere on the board
CSI3_D1_P: J7.35; also elsewhere on the board
DEBUG_RX2: J7.238; also elsewhere on the board
DEBUG_TX2: J7.236; also elsewhere on the board
FAN_PWM_GPIO14: J7.230; also elsewhere on the board
FAN_TAC_GPIO08: J7.208; also elsewhere on the board
GBE_LED_ACT: J7.194; also elsewhere on the board
GBE_LED_LINK: J7.188; also elsewhere on the board
GND: J7.1, J7.2, J7.7, J7.8, J7.13, J7.14, J7.19, J7.20, J7.25, J7.26, J7.31, J7.32, J7.37, J7.38, J7.43, J7.44, J7.49, J7.50, J7.55, J7.56, J7.61, J7.62, J7.67, J7.68, J7.73, J7.74, J7.79, J7.80, J7.85, J7.86, J7.102, J7.107, J7.113, J7.119, J7.125, J7.129, J7.132, J7.135, J7.138, J7.141, J7.144, J7.146, J7.147, J7.152, J7.153, J7.158, J7.159, J7.164, J7.165, J7.170, J7.171, J7.176, J7.177, J7.200, J7.201, J7.217, J7.231, J7.241, J7.242, J7.243, J7.244, J7.245, J7.246, J7.247, J7.248, J7.249, J7.250; also elsewhere on the board
GPE_MDI0_N: J7.184; also elsewhere on the board
GPE_MDI0_P: J7.186; also elsewhere on the board
GPE_MDI1_N: J7.190; also elsewhere on the board
GPE_MDI1_P: J7.192; also elsewhere on the board
GPE_MDI2_N: J7.196; also elsewhere on the board
GPE_MDI2_P: J7.198; also elsewhere on the board
GPE_MDI3_N: J7.202; also elsewhere on the board
GPE_MDI3_P: J7.204; also elsewhere on the board
GSM_DTR: J7.124; also elsewhere on the board
GSM_PERST_CTL: J7.126; also elsewhere on the board
GSM_UART_CTS: J7.105; also elsewhere on the board
GSM_UART_RTS: J7.103; also elsewhere on the board
GSM_UART_RX: J7.99; also elsewhere on the board
GSM_UART_TX: J7.101; also elsewhere on the board
GSM_W_DIS_CTL: J7.128; also elsewhere on the board
PCIE0_CLKREQ*: J7.180; also elsewhere on the board
PCIE0_CLK_N: J7.160; also elsewhere on the board
PCIE0_CLK_P: J7.162; also elsewhere on the board
PCIE0_RST*: J7.181; also elsewhere on the board
PCIE0_RX0_N: J7.131; also elsewhere on the board
PCIE0_RX0_P: J7.133; also elsewhere on the board
PCIE0_TX0_N: J7.134; also elsewhere on the board
PCIE0_TX0_P: J7.136; also elsewhere on the board
PWR_LED_CTL: J7.127; also elsewhere on the board
RS485_RW: J7.212; also elsewhere on the board
RS485_RX: J7.143; also elsewhere on the board
RS485_TX: J7.145; also elsewhere on the board
SOM_SLEEP*: J7.178; also elsewhere on the board

Notes on the sheet:
3.3V
SD-CARD ???
UART0 1.8V

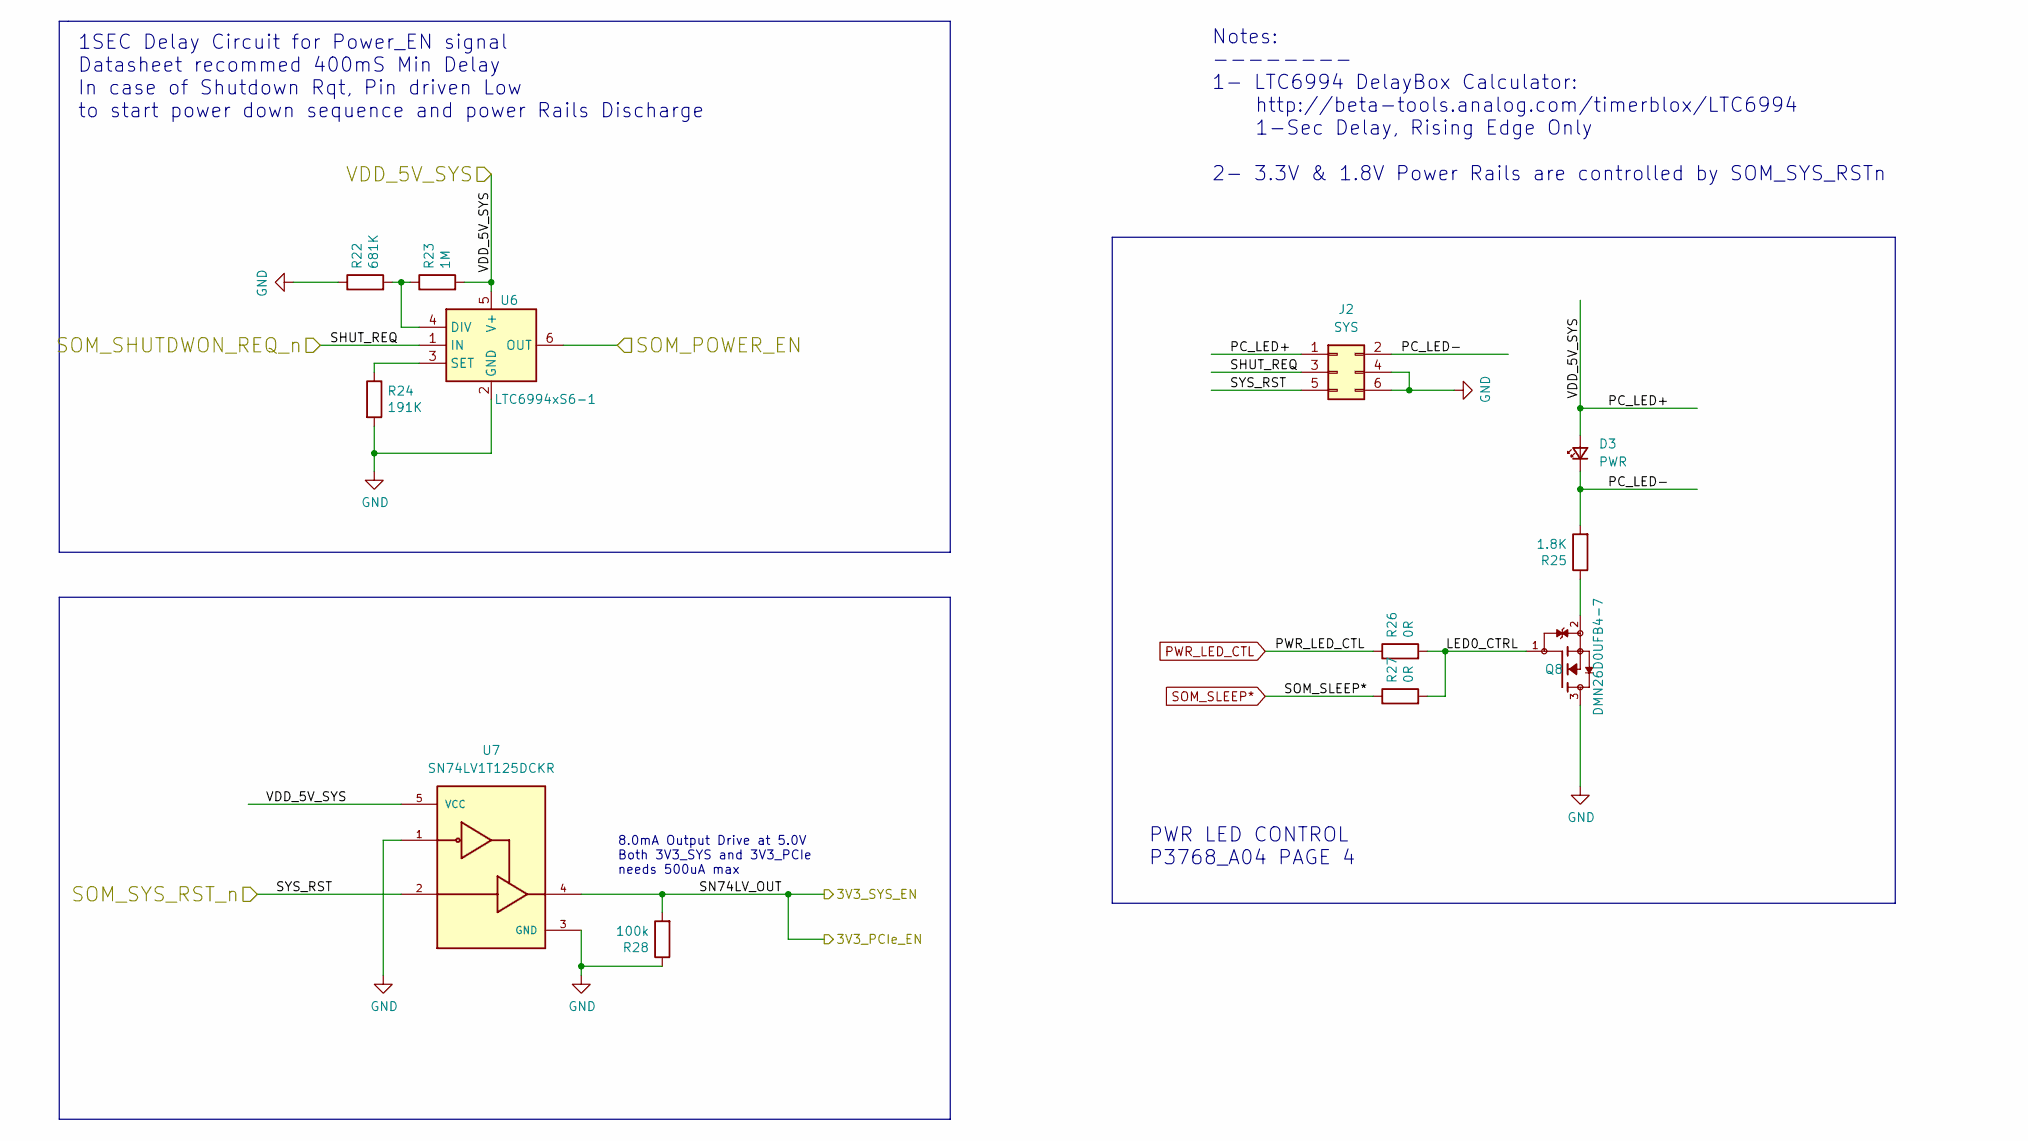
[picture p51: schematic P_Seq_M.kicad_sch, Jetson Orin Power Sequence Management System]

Parts:
D3: PWR; LED_0402_1005Metric; LCSC C130719
J2: SYS; PinHeader_2x03_P2.54mm_Vertical
Q8: DMN26D0UFB4-7; TRXDFN100X60X40-3N; PARTREV 12-2; LCSC C260867
R22: 681K; R_0201_0603Metric; Part Description Resistor 12K M1005 1% 63mW; LCSC C423447
R23: 1M; R_0201_0603Metric; Part Description Resistor 12K M1005 1% 63mW; LCSC C2105628
R24: 191K; R_0201_0603Metric; Part Description Resistor 12K M1005 1% 63mW; LCSC C778415
R25: 1.8K; R_0201_0603Metric; Part Description Resistor 12K M1005 1% 63mW; LCSC C171943
R26, R27: 0R; R_0201_0603Metric; Part Description Resistor 12K M1005 1% 63mW; LCSC C106228
R28: 100k; R_0201_0603Metric; Part Description Resistor 12K M1005 1% 63mW; LCSC C106224
U6: LTC6994xS6-1; TSOT-23-6; LCSC OUT_OS
U7: SN74LV1T125DCKR; SOT65P210X110-5N; PARTREV A; LCSC C75925

Connections:
/Orin_SOM/SOM_POWER_EN: U6.6 (OUT); also elsewhere on the board
/PSUs/3V3_PCIe_EN: R28.2, U7.4; also elsewhere on the board
/PSUs/P_Seq_M/LED0_CTRL: Q8.1, R26.2, R27.2
/PSUs/P_Seq_M/PC_LED-: D3.1 (K), J2.2, R25.2
/PSUs/P_Seq_M/SHUT_REQ: J2.3, U6.1 (IN); also elsewhere on the board
/PSUs/P_Seq_M/SYS_RST: J2.5, U7.2; also elsewhere on the board
/VDD_5V_SYS: D3.2 (A), J2.1, R23.2, U6.5 (V+), U7.5 (VCC); also elsewhere on the board
GND: J2.4, J2.6, Q8.3, R22.1, R24.2, R28.1, U6.2 (GND), U7.1, U7.3 (GND); also elsewhere on the board
unnamed: Q8.2, R25.1
unnamed: R22.2, R23.1, U6.4 (DIV)
unnamed: R24.1, U6.3 (SET)
PWR_LED_CTL: R26.1; also elsewhere on the board
SOM_SLEEP*: R27.1; also elsewhere on the board

Notes on the sheet:
1SEC Delay Circuit for Power_EN signal Datasheet recommed 400mS Min Delay In case of Shutdown Rqt, Pin driven Low to start power down sequence and power Rails Discharge
PWR LED CONTROL P3768_A04 PAGE 4
8.0mA Output Drive at 5.0V Both 3V3_SYS and 3V3_PCIe needs 500uA max
Notes: -------- 1- LTC6994 DelayBox Calculator: http://beta-tools.analog.com/timerblox/LTC6994 1-Sec Delay, Rising Edge Only 2- 3.3V & 1.8V Power Rails are controlled by SOM_SYS_RSTn

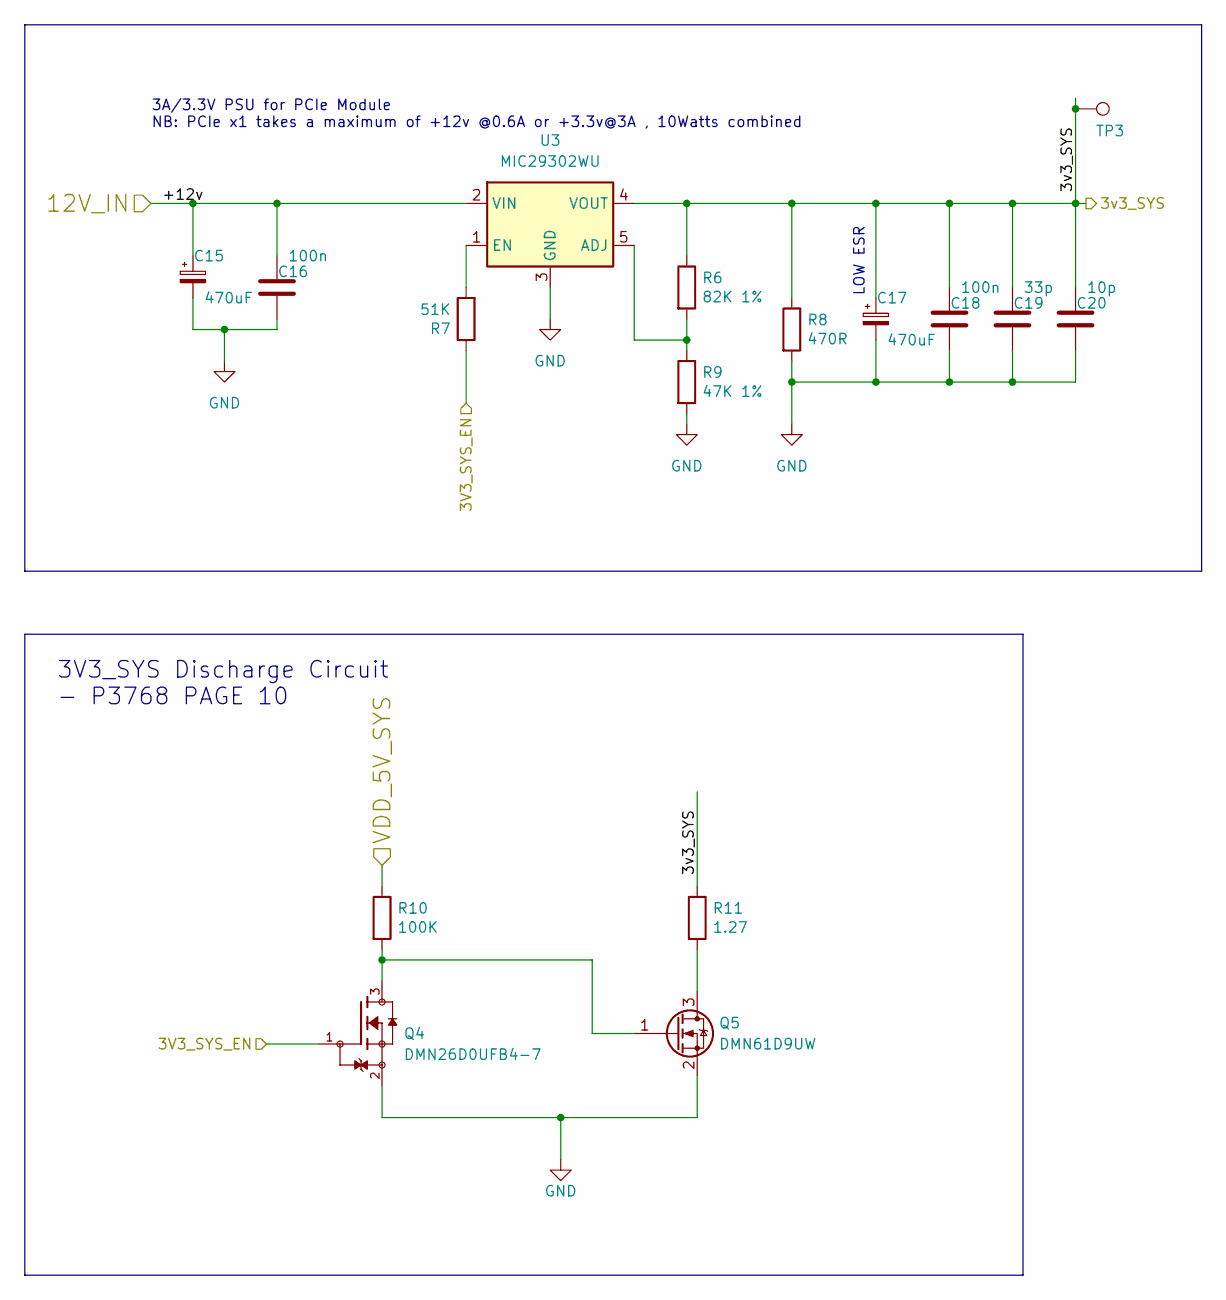
[picture p52: schematic 3V3_SYS_DCDC.kicad_sch]

Parts:
C15: 470uF; Kemet _3760_H; LCSC C600599
C16: 100n; C_0201_0603Metric; LCSC C307380
C17: 470uF; CP_EIA-7343-31_Kemet-D; LCSC C116576
C18: 100n; C_0201_0603Metric; Part Description 0.1uF 10% 100V Ceramic Capacitor X5R 04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; LCSC C307380
C19: 33p; C_0201_0603Metric; LCSC C277477
C20: 10p; C_0201_0603Metric; LCSC C272871
Q4: DMN26D0UFB4-7; TRXDFN100X60X40-3N; PARTREV 12-2; LCSC C260867
Q5: DMN61D9UW; SOT65P210X110-3N; LCSC C151592
R6: 82K 1%; R_0201_0603Metric; LCSC C384402
R7: 51K; R_0201_0603Metric; LCSC C171974
R8: 470R; R_0201_0603Metric; LCSC C304545
R9: 47K 1%; R_0201_0603Metric; LCSC C138139
R10: 100K; R_0201_0603Metric; Part Description Resistor 12K M1005 1% 63mW; LCSC C106224
R11: 1.27; R_0201_0603Metric; Part Description Resistor 12K M1005 1% 63mW; LCSC C158692
TP3: TestPoint; TestPoint_Pad_D1.0mm
U3: MIC29302WU; TO-263-5_TabPin3; LCSC C11149

Connections:
/3v3_SYS: C17.1, C18.1, C19.1, C20.1, R6.1, R8.1, R11.1, TP3.1, U3.4 (VOUT); also elsewhere on the board
/PSUs/3V3_PCIe_EN: Q4.1, R7.1; also elsewhere on the board
/PSUs/+12v: C15.1, C16.1, U3.2 (VIN); also elsewhere on the board
/VDD_5V_SYS: R10.1; also elsewhere on the board
GND: C15.2, C16.2, C17.2, C18.2, C19.2, C20.2, Q4.2, Q5.2 (S), R8.2, R9.2, U3.3 (GND); also elsewhere on the board
unnamed: Q4.3, Q5.1 (G), R10.2
unnamed: Q5.3 (D), R11.2
unnamed: R6.2, R9.1, U3.5 (ADJ)
unnamed: R7.2, U3.1 (EN)

Notes on the sheet:
3A/3.3V PSU for PCIe Module NB: PCIe x1 takes a maximum of +12v @0.6A or +3.3v@3A , 10Watts combined
3V3_SYS Discharge Circuit - P3768 PAGE 10
LOW ESR

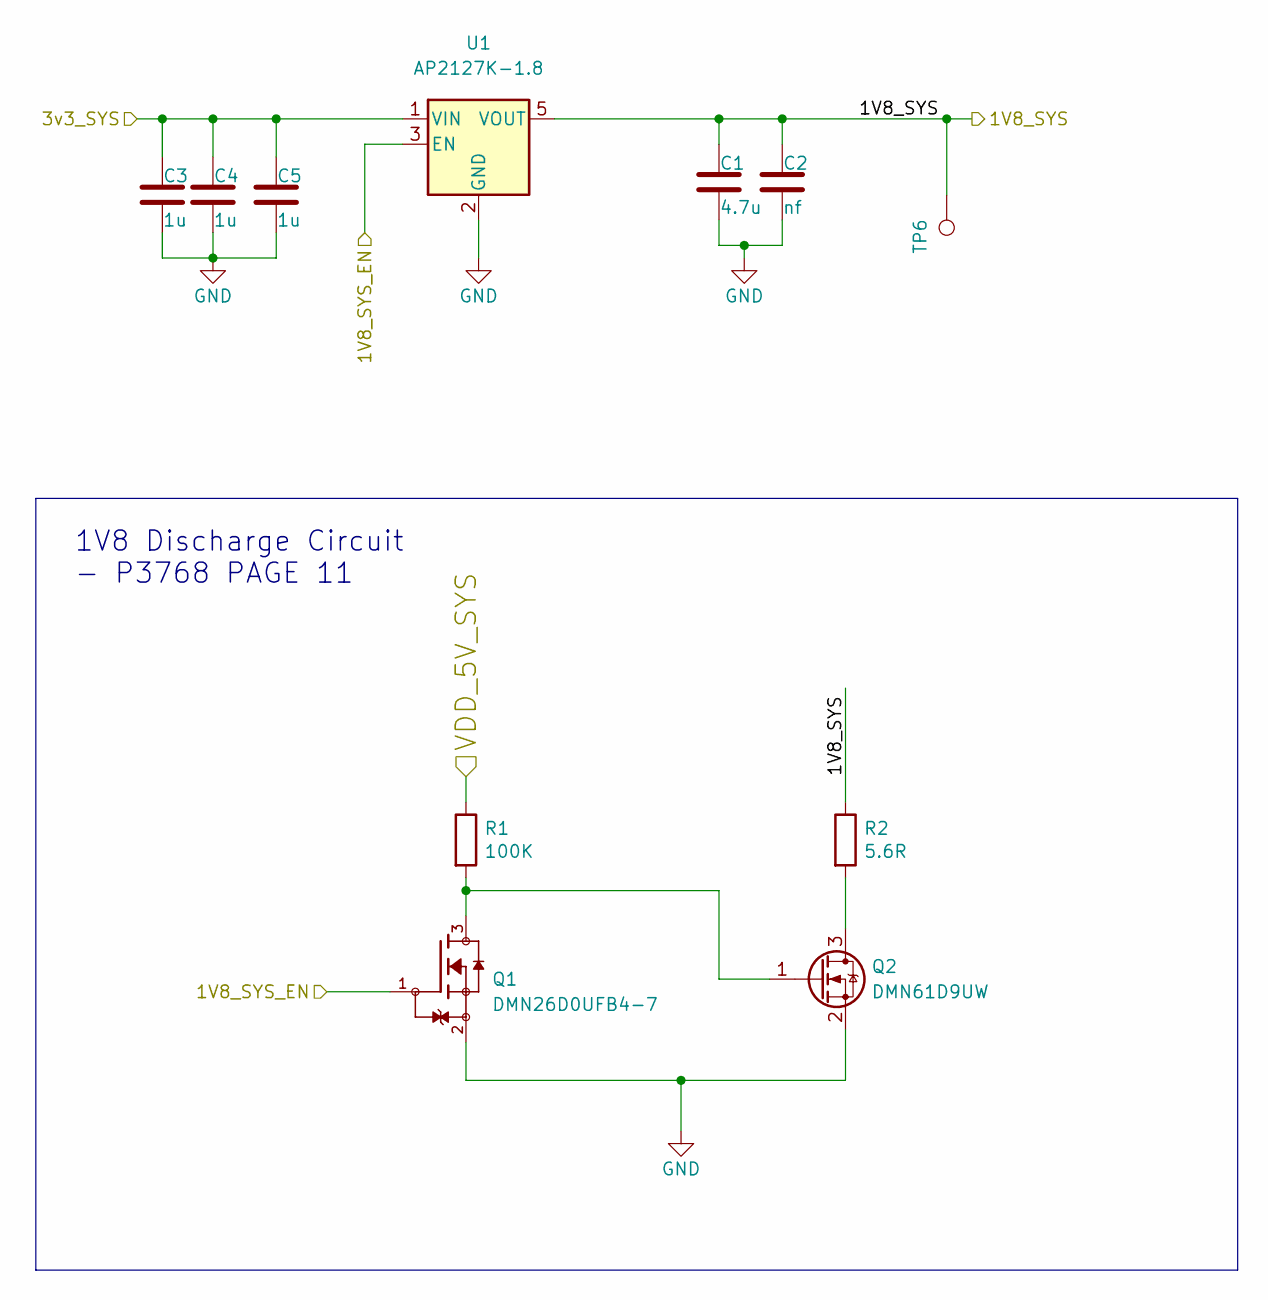
[picture p53: schematic 1V8_SYS_DCDC.kicad_sch]

Parts:
C1: 4.7u; C_0201_0603Metric; LCSC C335103
C2: nf; C_0201_0603Metric
C3, C4, C5: 1u; C_0201_0603Metric; LCSC C87143
Q1: DMN26D0UFB4-7; TRXDFN100X60X40-3N; PARTREV 12-2; LCSC C260867
Q2: DMN61D9UW; SOT65P210X110-3N; LCSC C151592
R1: 100K; R_0201_0603Metric; Part Description Resistor 12K M1005 1% 63mW; LCSC C106224
R2: 5.6R; R_0201_0603Metric; Part Description Resistor 12K M1005 1% 63mW; LCSC C367405
TP6: TestPoint; TestPoint_Pad_D1.0mm
U1: AP2127K-1.8; SOT-23-5; LCSC C151375

Connections:
/1V8_SYS: C1.1, C2.1, R2.1, TP6.1, U1.5 (VOUT); also elsewhere on the board
/3v3_SYS: C3.1, C4.1, C5.1, U1.1 (VIN); also elsewhere on the board
/PSUs/3V3_PCIe_EN: Q1.1, U1.3 (EN); also elsewhere on the board
/VDD_5V_SYS: R1.1; also elsewhere on the board
GND: C1.2, C2.2, C3.2, C4.2, C5.2, Q1.2, Q2.2 (S), U1.2 (GND); also elsewhere on the board
unnamed: Q1.3, Q2.1 (G), R1.2
unnamed: Q2.3 (D), R2.2

Notes on the sheet:
1V8 Discharge Circuit - P3768 PAGE 11

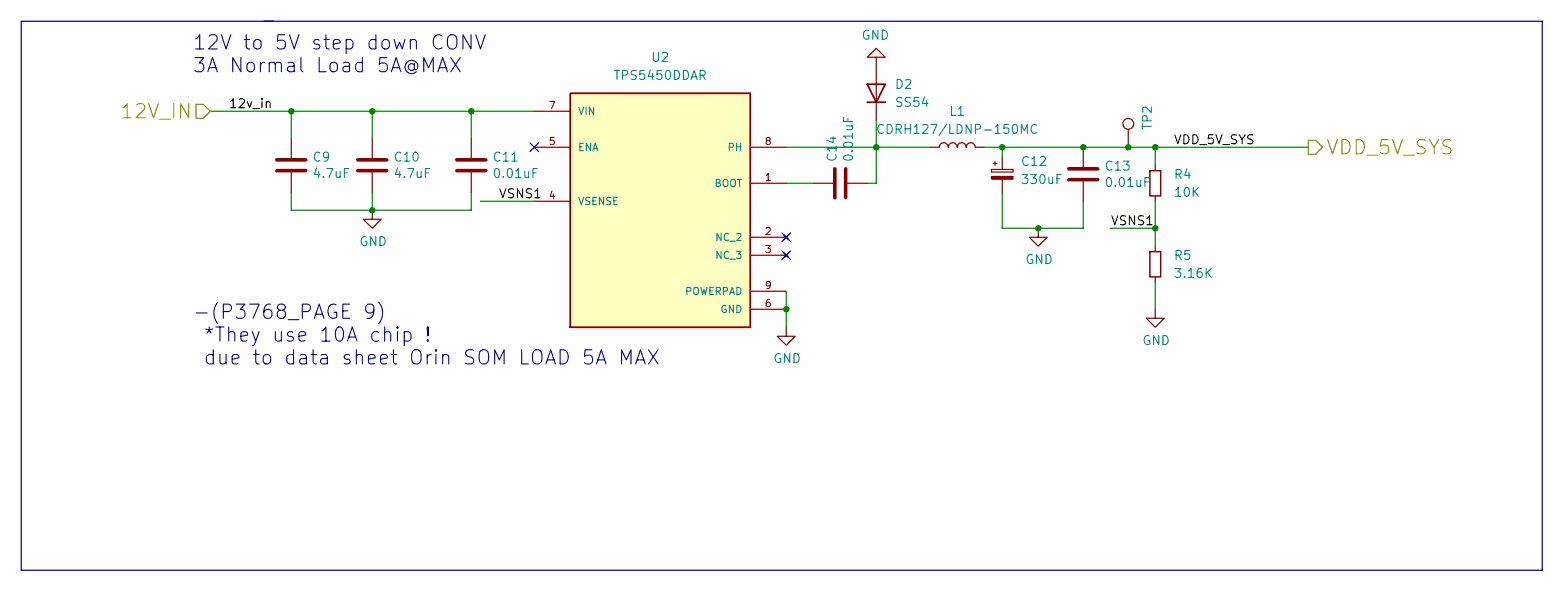
[picture p54: schematic 5V_SYS_DCDC.kicad_sch]

Parts:
C9, C10: 4.7uF; C_0402_1005Metric; Part Description 10uF 10% or 20% 35V Ceramic Capacitor X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; LCSC C2858031
C11, C14: 0.01uF; C_0201_0603Metric; LCSC C285010
C12: 330uF; CP_EIA-7343-31_Kemet-D; LCSC C105408
C13: 0.01uF; C_0201_0603Metric; Part Description 10uF 10% or 20% 35V Ceramic Capacitor X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; LCSC C285010
D2: SS54; D_SMA; LCSC C908681
L1: CDRH127/LDNP-150MC; L_12x12mm_H8mm; LCSC C879410
R4: 10K; R_0201_0603Metric; LCSC C106225
R5: 3.16K; R_0201_0603Metric; LCSC C367583
TP2: TestPoint; TestPoint_Pad_D1.0mm
U2: TPS5450DDAR; CONV_TPS5450DDAR; PARTREV D; LCSC C114425

Connections:
/PSUs/5V_SYS_DCDC/VSNS1: R4.2, R5.1, U2.4 (VSENSE)
/PSUs/+12v: C9.1, C10.1, C11.1, U2.7 (VIN); also elsewhere on the board
/VDD_5V_SYS: C12.1, C13.1, L1.2, R4.1, TP2.1; also elsewhere on the board
GND: C9.2, C10.2, C11.2, C12.2, C13.2, D2.1 (A), R5.2, U2.6 (GND), U2.9 (POWERPAD); also elsewhere on the board
unnamed: C14.1, U2.1 (BOOT)
unnamed: C14.2, D2.2 (K), L1.1, U2.8 (PH)

Notes on the sheet:
12V to 5V step down CONV 3A Normal Load 5A@MAX
-(P3768_PAGE 9) *They use 10A chip ! due to data sheet Orin SOM LOAD 5A MAX

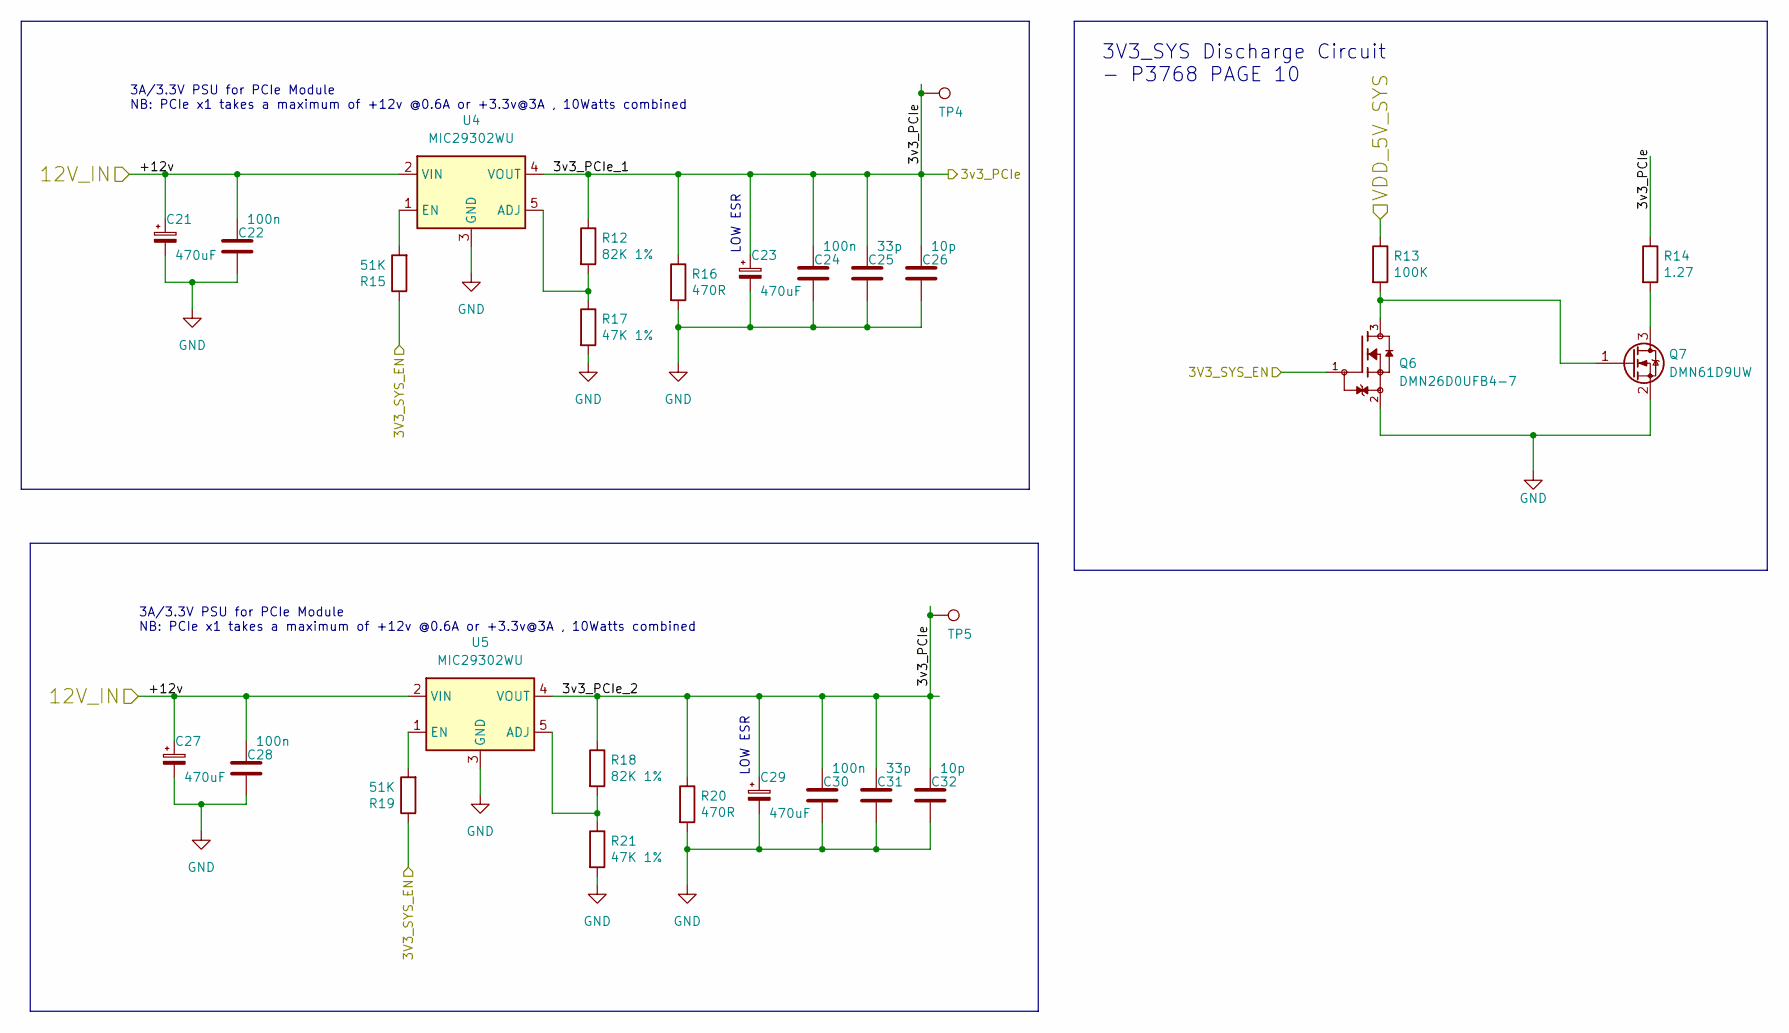
[picture p55: schematic 3V3_PCIe_DCDC.kicad_sch]

Parts:
C21, C27: 470uF; Kemet _3760_H; LCSC C600599
C22, C28: 100n; C_0201_0603Metric; LCSC C307380
C23, C29: 470uF; CP_EIA-7343-31_Kemet-D; LCSC C116576
C24, C30: 100n; C_0201_0603Metric; Part Description 0.1uF 10% 100V Ceramic Capacitor X5R 04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; LCSC C307380
C25, C31: 33p; C_0201_0603Metric; LCSC C277477
C26, C32: 10p; C_0201_0603Metric; LCSC C272871
Q6: DMN26D0UFB4-7; TRXDFN100X60X40-3N; PARTREV 12-2; LCSC C260867
Q7: DMN61D9UW; SOT65P210X110-3N; LCSC C151592
R12, R18: 82K 1%; R_0201_0603Metric; LCSC C384402
R13: 100K; R_0201_0603Metric; Part Description Resistor 12K M1005 1% 63mW; LCSC C106224
R14: 1.27; R_0201_0603Metric; Part Description Resistor 12K M1005 1% 63mW; LCSC C2691510
R15, R19: 51K; R_0201_0603Metric; LCSC C171974
R16, R20: 470R; R_0201_0603Metric; LCSC C304545
R17, R21: 47K 1%; R_0201_0603Metric; LCSC C138139
TP4, TP5: TestPoint; TestPoint_Pad_D1.0mm
U4, U5: MIC29302WU; TO-263-5_TabPin3; LCSC C11149

Connections:
/3v3_PCIe: C23.1, C24.1, C25.1, C26.1, C29.1, C30.1, C31.1, C32.1, R12.1, R14.1, R16.1, R18.1, R20.1, TP4.1, TP5.1, U4.4 (VOUT), U5.4 (VOUT); also elsewhere on the board
/PSUs/3V3_PCIe_DCDC/3V3_SYS_EN: Q6.1, R15.1, R19.1
/PSUs/+12v: C21.1, C22.1, C27.1, C28.1, U4.2 (VIN), U5.2 (VIN); also elsewhere on the board
/VDD_5V_SYS: R13.1; also elsewhere on the board
GND: C21.2, C22.2, C23.2, C24.2, C25.2, C26.2, C27.2, C28.2, C29.2, C30.2, C31.2, C32.2, Q6.2, Q7.2 (S), R16.2, R17.2, R20.2, R21.2, U4.3 (GND), U5.3 (GND); also elsewhere on the board
unnamed: Q6.3, Q7.1 (G), R13.2
unnamed: Q7.3 (D), R14.2
unnamed: R12.2, R17.1, U4.5 (ADJ)
unnamed: R15.2, U4.1 (EN)
unnamed: R18.2, R21.1, U5.5 (ADJ)
unnamed: R19.2, U5.1 (EN)

Notes on the sheet:
3V3_SYS Discharge Circuit - P3768 PAGE 10
3A/3.3V PSU for PCIe Module NB: PCIe x1 takes a maximum of +12v @0.6A or +3.3v@3A , 10Watts combined
LOW ESR

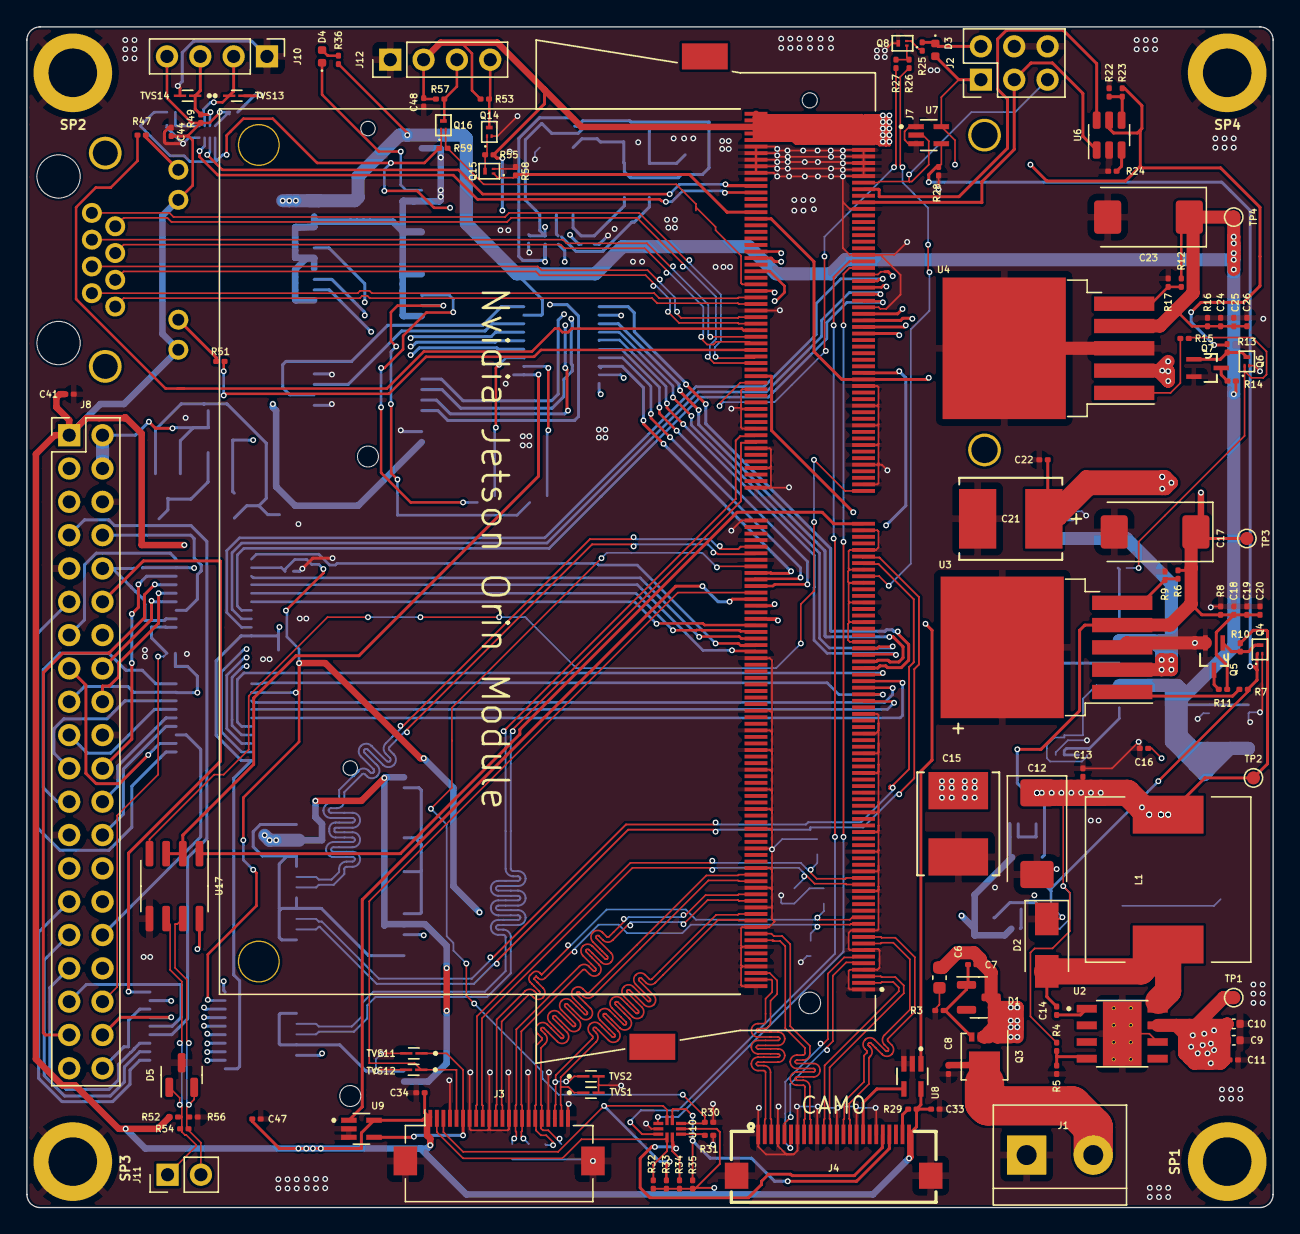
[picture p56: board SS_JetOrin_V1.kicad_pcb from above]

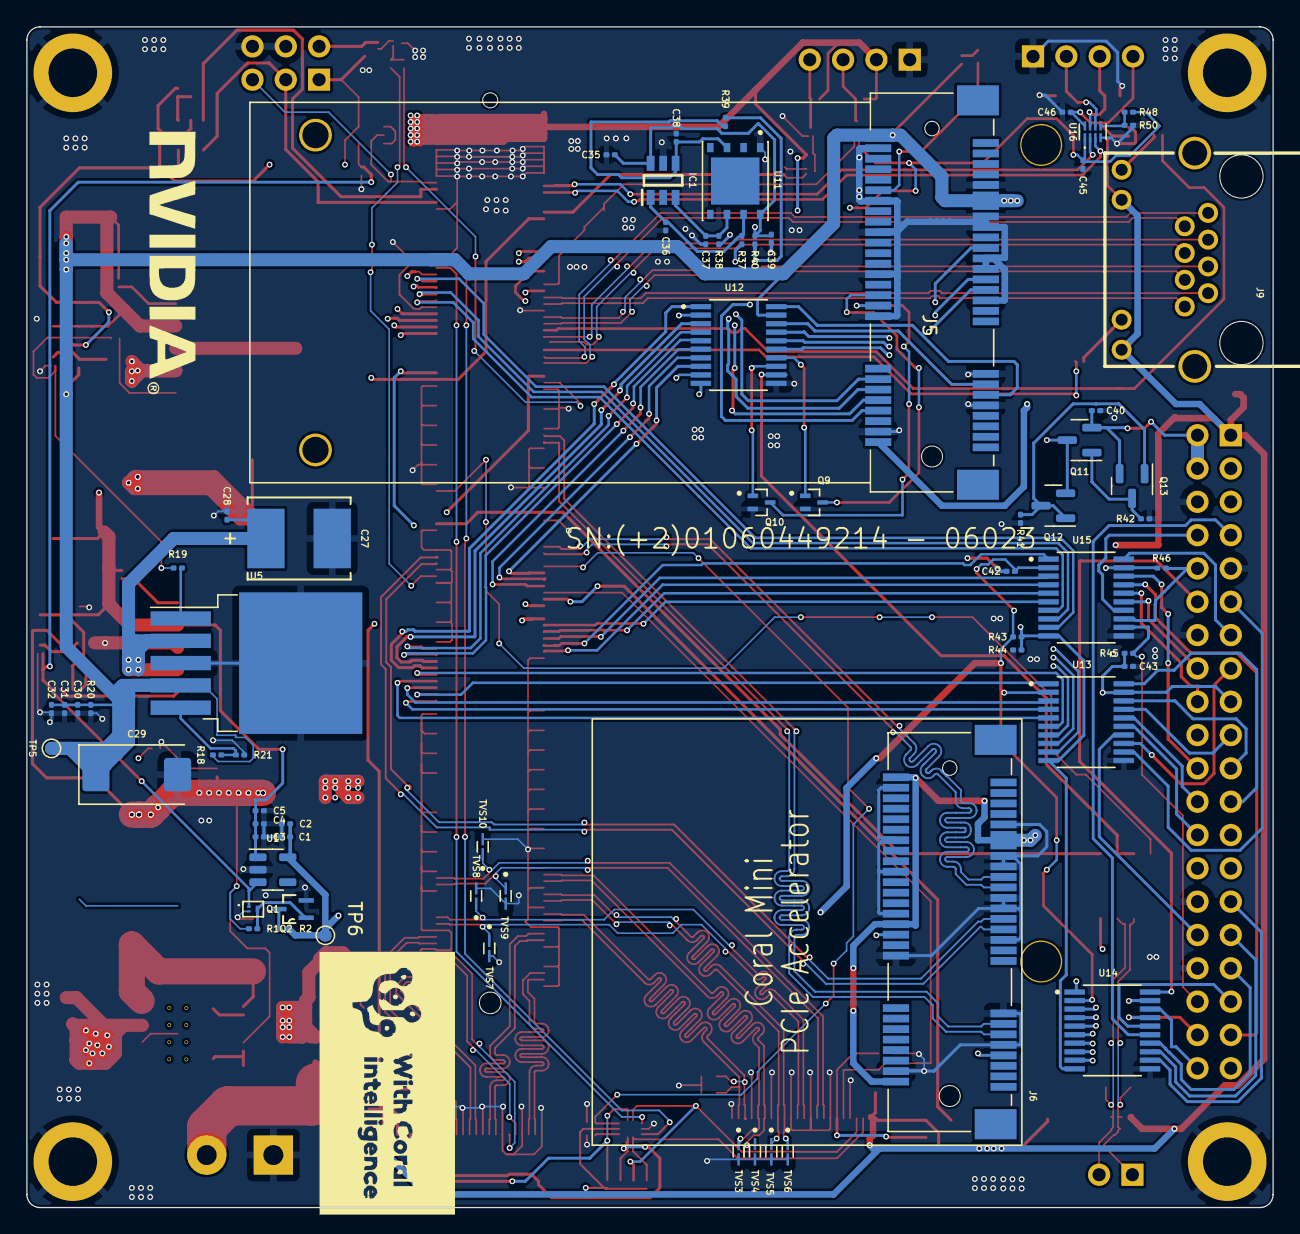
[picture p57: board SS_JetOrin_V1.kicad_pcb from below]

Board: 4 copper layers, 95.0 x 90.0 mm, 183 parts (68 on the bottom side), 182 nets.
