Mr-JoE1/SS_AI_Traffic_Radar/Hardware/SS_CM4IO/SS_CM4IO_V2_1/SS_CM4IO_V2.kicad_pcb

## KiCad design Hardware/SS_CM4IO/SS_CM4IO_V2_1/SS_CM4IO_V2.kicad_pcb (2023-10-18)

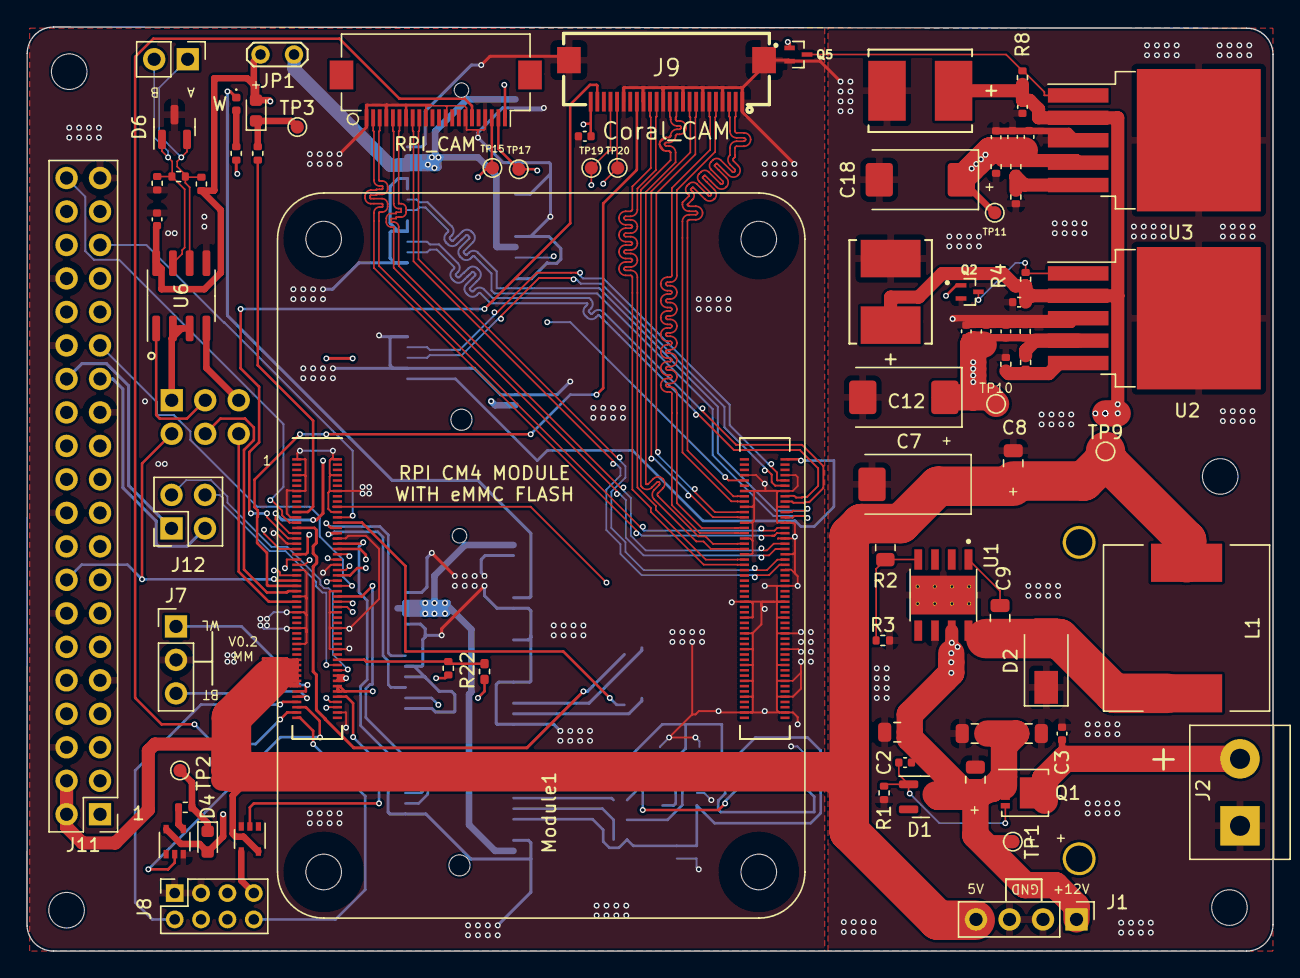
[picture p58: board SS_CM4IO_V2.kicad_pcb from above]

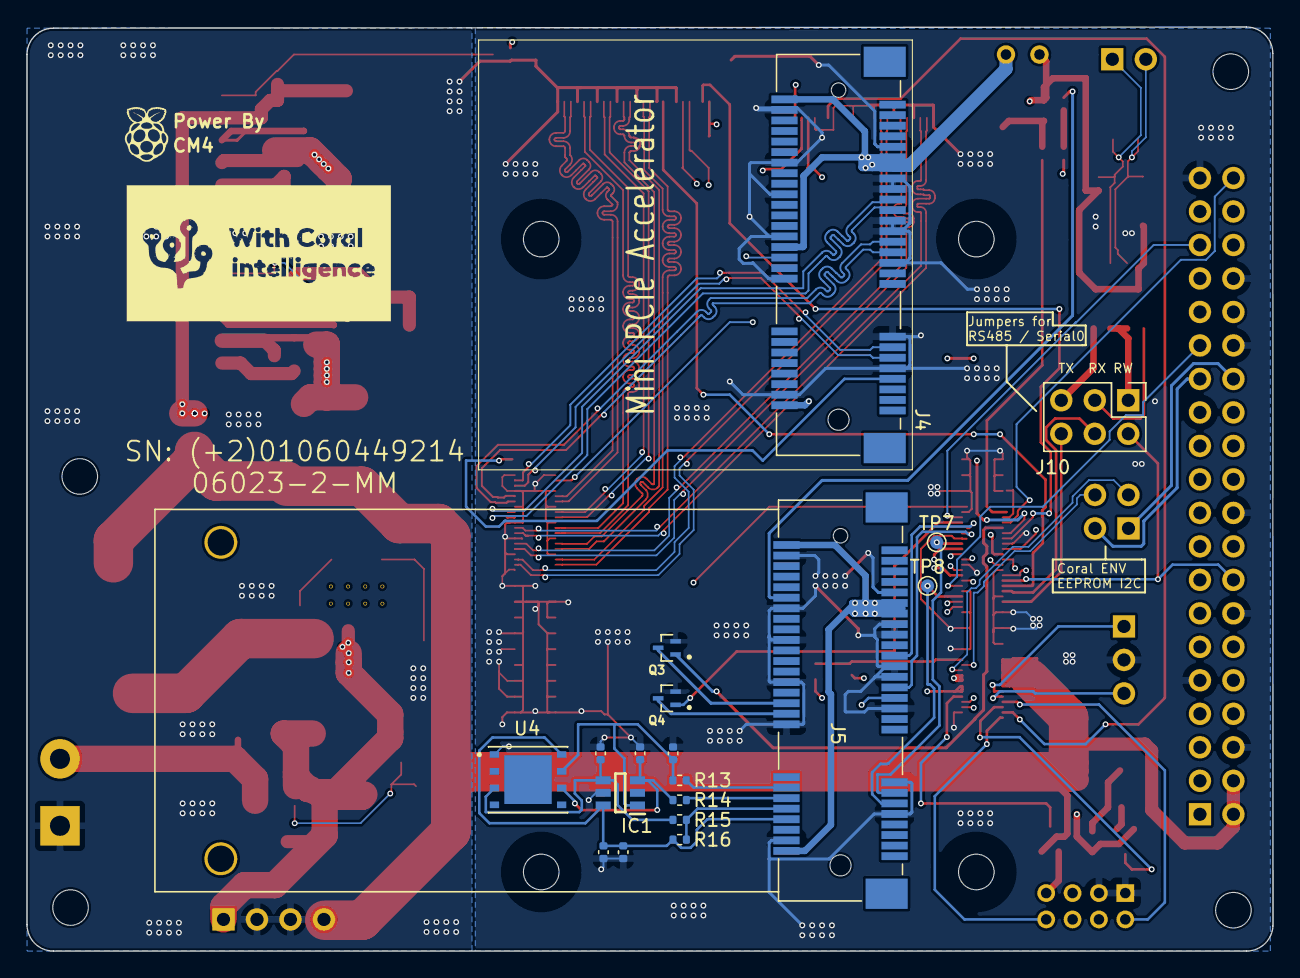
[picture p59: board SS_CM4IO_V2.kicad_pcb from below]

Board: 4 copper layers, 94.5 x 70.1 mm, 103 parts (18 on the bottom side), 47 nets.

Parts:
C1: 10u 35v; C_0805_2012Metric
C2, C3: 100n 100v; C_0402_1005Metric
C4, C5: 4.7uF; C_0805_2012Metric
C6, C8, C9: 0.01uF; C_0805_2012Metric
C7: 330uF; CP_EIA-7343-31_Kemet-D
C10, C16: 470uF; Kemet _3760_H
C11, C13, C17, C19, C26: 100n; C_0402_1005Metric
C12, C18: 470uF; CP_EIA-7343-31_Kemet-D
C14, C20, C22, C23, C24, C25: 33p; C_0402_1005Metric
C15, C21: 10p; C_0402_1005Metric
C27: 104; C_0402_1005Metric
C28: 1u; C_0402_1005Metric
CM4_A, CM4_B: DF40C-100DS; DF40C-100DS_CM4
D1: MMBZ5242BLT1G; SOT-23
D2: SS54; D_SMA
D3: W; LED_0402_1005Metric
D4: LED Red; LED_0603_1608Metric
D5: LED Green; LED_0603_1608Metric
D6: PSM712-LF-T7; SOT-23
H1, H2, H3, H4: MountingHole; MountingHole_2.7mm_M2.5
IC1: DALC208SC6; SOT95P280X145-6N
J1: AMP171826-4; PinHeader_1x04_P2.54mm_Vertical
J2: pwr; TerminalBlock_bornier-2_P5.08mm
J3: RPI_CAM; Hirose_FH12-22S-0.5SH_1x22-1MP_P0.50mm_Horizontal
J4, J5: Bus_PCI_Express_Mini; BUS_PCI_Express_Mini_Half
J6: Conn_01x02_Male; PinHeader_1x02_P2.54mm_Vertical
J7: W.BT; PinHeader_1x03_P2.54mm_Vertical
J8: Conn_02x04_Odd_Even; PinSocket_2x04_P2.00mm_Vertical
J9: Coral_CAM; FPC-SMD_P0.50-24P_QCHF-SM-H2.0
J10: RADAR_EN; PinHeader_2x03_P2.54mm_Vertical
J11: ENV_SEN; PinHeader_2x20_P2.54mm_Vertical
J12: EPP_RW; PinSocket_2x02_P2.54mm_Vertical
JP1: Jumper_2_Open; TestPoint_2Pads_Pitch2.54mm_Drill0.8mm
L1: CDRH127/LDNP-150MC; L_12x12mm_H8mm
Module1: ComputeModule4; Raspberry-Pi-4-Compute-Module
Q1: DMP3013SFV-7; Diodes_PowerDI3333-8
Q2, Q3, Q4, Q5: DTC143ZEBTL; SOTFL50P160X85-3N
R1: 12K 1%; R_0402_1005Metric
R2: 10K; R_0805_2012Metric
R3: 3.16K; R_0402_1005Metric
R4, R8: 51K; R_0402_1005Metric
R5, R9: 82K 1%; R_0402_1005Metric
R6, R10: 470R; R_0402_1005Metric
R7, R11: 47K 1%; R_0402_1005Metric
R12: 1K; R_0402_1005Metric
R13, R14, R15: 22R; R_0402_1005Metric
R16: 15R; R_0402_1005Metric
R17, R18: 1k; R_0402_1005Metric
R19, R20: 360R; R_0402_1005Metric
R21: 0R; R_0402_1005Metric
R22: nf; R_0402_1005Metric_Pad0.72x0.64mm_HandSolder
R23: 120R; R_0402_1005Metric
TP1: 12V; TestPoint_Pad_D1.0mm
TP2, TP3, TP7, TP8, TP9, TP10, TP11, TP15, TP17, TP19, TP20: TestPoint; TestPoint_Pad_D1.0mm
U1: TPS5450DDAR; CONV_TPS5450DDAR
U2, U3: MIC29302WU; TO-263-5_TabPin3
U4: SIM-E-MFF2-GL-250; PSON127P500X600X82-9N
U5, U7: 74LVC1G07SE-7; SOT-353_SC-70-5
U6: MAX3485; SOIC-8_3.9x4.9mm_P1.27mm

Connections:
/4G_GSM/+3v3_GSM: C18.1, C19.1, C20.1, C21.1, J5.2 (+3V3AUX), J5.39 (+3V3AUX), J5.41 (+3V3AUX), J5.52 (+3V3AUX), R9.1, R10.1, R12.2, TP11.1, U3.4 (VOUT)
/4G_GSM/GSM_UART_RX: J5.11 (REFCLK-), TP8.1
/4G_GSM/GSM_UART_TX: J5.13 (REFCLK+), TP7.1
/4G_GSM/LED_WWAN: D3.1 (K), J5.42 (~LED_WWAN)
/4G_GSM/PERST: J5.22 (~PERST), Q3.3 (C)
/4G_GSM/USIM_CLK: J5.12 (UIM_CLK), R14.1
/4G_GSM/USIM_DATA: J5.10 (UIM_DATA), R15.1, R16.2
/4G_GSM/USIM_RST: J5.14 (~UIM_RESET), R13.1
/4G_GSM/USIM_VDD: C22.2, C26.1, IC1.6 (I/O_4), J5.8 (UIM_PWR), R16.1, U4.8 (VCC)
/4G_GSM/W_DISABLE: J5.20 (~W_DISABLE), Q4.3 (C)
/+3v3_PCIe: C12.1, C13.1, C14.1, C15.1, J4.2 (+3V3AUX), J4.24 (+3V3AUX), J4.39 (+3V3AUX), J4.41 (+3V3AUX), J4.52 (+3V3AUX), JP1.1 (A), R5.1, R6.1, TP10.1, U2.4 (VOUT)
/+5R: C7.1, C8.1, J1.4, J11.2, J11.4, L1.2, R2.1, TP9.1, U7.5 (VCC)
/+12v: C1.1, C2.1, C4.1, C5.1, C6.1, C10.1, C11.1, C16.1, C17.1, D1.3 (K), J1.1, Q1.1 (S), Q1.2 (S), Q1.3 (S), R4.1, R8.1, TP1.1, U1.7 (VIN), U2.2 (VIN), U3.2 (VIN)
/CM4_MOD/CM4_3.3v: C27.1, C28.1, D4.2 (A), D5.2 (A), J3.22, J9.24, J11.1, JP1.2 (B), R20.2, R21.1, U5.5 (VCC), U6.8 (VCC)
/CM4_MOD/CONSOL_RX: J10.4, J11.10
/CM4_MOD/CONSOL_TX: J10.6, J11.8
/CM4_MOD/EEP_SCL: J11.28, J12.1
/CM4_MOD/EEP_SDA: J11.27, J12.2
/CM4_MOD/ENV_BTN: J10.2, J11.16
/CM4_MOD/GPIO_VREF: R21.2, R22.2
/CM4_MOD/RS485_RW: J10.1, U6.2 (~RE), U6.3 (DE)
/CM4_MOD/RS485_RX: J10.3, U6.1 (RO)
/CM4_MOD/RS485_TX: J10.5, U6.4 (DI)
/CM4_MOD/RS+: D6.2 (K2), J6.1, R20.1, R23.2, U6.6 (A)
/CM4_MOD/RS-: D6.1 (K1), J6.2, R19.2, R23.1, U6.7 (B)
/CM4_MOD/SCA0: J9.21, J12.3, TP19.1
/CM4_MOD/SCL0: J9.20, J12.4, TP20.1
/PCIe_CAM/ID_SC: J3.20, TP15.1
/PCIe_CAM/ID_SD: J3.21, TP17.1
/PSUs/VSNS1: R2.2, R3.1, U1.4 (VSENSE)
GND: C1.2, C3.2, C4.2, C5.2, C6.2, C7.2, C8.2, C10.2, C11.2, C12.2, C13.2, C14.2, C15.2, C16.2, C17.2, C18.2, C19.2, C20.2, C21.2, C22.1, C23.1, C24.1, C25.1, C26.2, C27.2, C28.2, D2.1 (A), D6.3 (A), IC1.5 (REF_1), J1.2, J1.3, J2.1, J3.1, J3.4, J3.7, J3.10, J3.13, J3.16, J3.19, J4.4 (GND), J4.9 (GND), J4.15 (GND), J4.18 (GND), J4.21 (GND), J4.26 (GND), J4.27 (GND), J4.29 (GND), J4.34 (GND), J4.35 (GND), J4.37 (GND), J4.40 (GND), J4.43 (GND), J4.50 (GND), J5.4 (GND), J5.9 (GND), J5.15 (GND), J5.18 (GND), J5.21 (GND), J5.26 (GND), J5.27 (GND), J5.29 (GND), J5.34 (GND), J5.35 (GND), J5.37 (GND), J5.40 (GND), J5.43 (GND), J5.50 (GND), J7.2, J8.1, J8.3, J9.1, J9.4, J9.7, J9.10, J9.13, J9.16, J9.19, J9.25, J9.26, J11.6, J11.9, J11.14, J11.20, J11.25, J11.30, J11.34, J11.39, Q2.2 (E), Q3.2 (E), Q4.2 (E), Q5.2 (E), R1.2, R3.2, R6.2, R7.2, R10.2, R11.2, R19.1, U1.6 (GND), U1.9 (POWERPAD), U2.3 (GND), U3.3 (GND), U4.1 (GND), U5.3 (GND), U6.5 (GND), U7.3 (GND)
unnamed: C2.2, D1.1 (A), Q1.4 (G), R1.1
unnamed: C3.1, J2.2, Q1.5 (D)
unnamed: C9.1, U1.1 (BOOT)
unnamed: C9.2, D2.2 (K), L1.1, U1.8 (PH)
unnamed: C23.2, IC1.1 (I/O_1), R13.2, U4.7 (RST)
unnamed: C24.2, IC1.3 (I/O_2), R14.2, U4.6 (CLK)
unnamed: C25.2, IC1.4 (I/O_3), R15.2, U4.3 (I/O)
unnamed: D3.2 (A), R12.1
unnamed: D4.1 (K), R17.1, TP2.1
unnamed: D5.1 (K), R18.1, TP3.1
unnamed: J8.7, U7.4
unnamed: Q2.3 (C), R4.2, U2.1 (EN)
unnamed: Q5.3 (C), R8.2, U3.1 (EN)
unnamed: R5.2, R7.1, U2.5 (ADJ)
unnamed: R9.2, R11.1, U3.5 (ADJ)
unnamed: R17.2, U5.4
