Mr-JoE1/SS_AI_Traffic_Radar/Hardware/Ref/CM4IOUSB3-KiCAD/PCIe-USB3.kicad_sch

## KiCad design Hardware/Ref/CM4IOUSB3-KiCAD/PCIe-USB3.kicad_sch (2023-10-18)

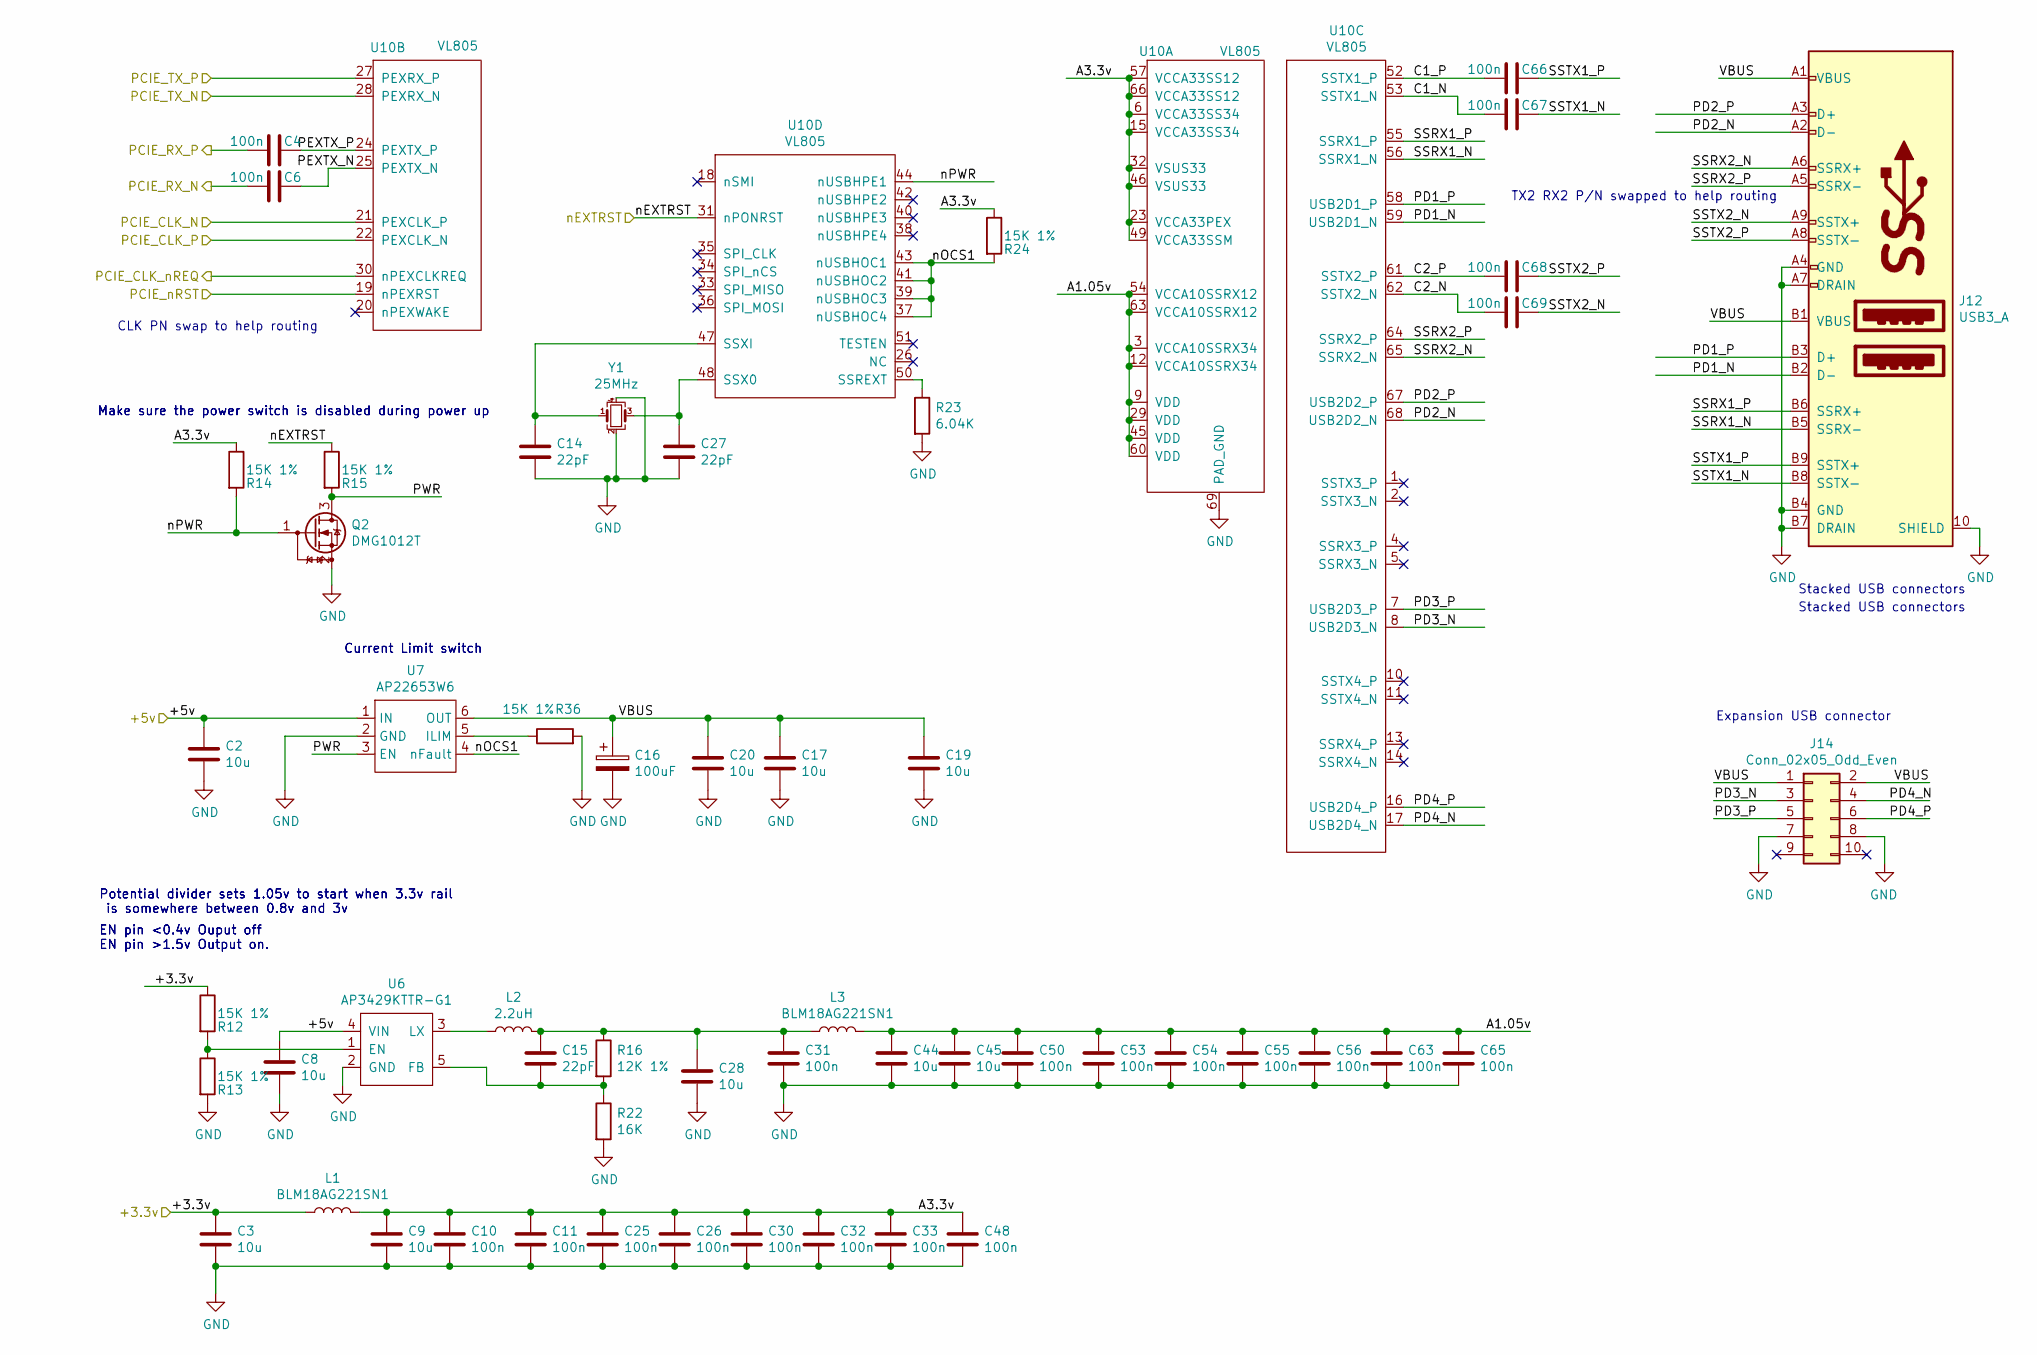
[picture p67: schematic PCIe-USB3.kicad_sch]

Parts:
C2, C3, C8, C9, C17, C19, C20, C28, C44, C45: 10u; C_0805_2012Metric; Part Description 10uF 10% 10V Ceramic Capacitor X7R 0805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
C4, C6, C10, C11, C25, C26, C30, C31, C32, C33, C48, C50, C53, C54, C55, C56, C63, C65, C66, C67, C68, C69: 100n; C_0402_1005Metric; Part Description 0.1uF 10% 16V Ceramic Capacitor X7R 040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
C14, C15, C27: 22pF; C_0402_1005Metric
C16: 100uF; CP_EIA-7343-31_Kemet-D; Part Description Capacitor, SP-Cap, 100u, 6.3V, 15mR ESR
J12: USB3_A; MTCONN_UBAF30-D2011
J14: Conn_02x05_Odd_Even; PinHeader_2x05_P2.54mm_Vertical; Part Description PinHeader_2x05_P2.54mm_Vertical
L1, L3: BLM18AG221SN1; L_0603_1608Metric; Part Description Ferrite Bead, M1608, 220R@100MHz, 100mR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
L2: 2.2uH; L_1008_2520Metric; Part Description Inductor, SMT, 2520, 2u2, IRMS=2.3A, IS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
Q2: DMG1012T; SOT-523
R12, R13, R14, R15, R24, R36: 15K 1%; R_0402_1005Metric; Part Description Resistor 15K M1005 1% 63mW
R16: 12K 1%; R_0402_1005Metric; Part Description Resistor 12K M1005 1% 63mW
R22: 16K; R_0402_1005Metric; Part Description Resistor 16K M1005 1% 63mW
R23: 6.04K; R_0402_1005Metric; Part Description Resistor 6.04K M1005 1% 63mW
U6: AP3429KTTR-G1; TSOT-23-5
U7: AP22653W6; SOT-23-6; Part Description Power Switch/Driver 1:1 P-Channel 2.1A 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
U10: VL805; QFN-68-1EP_8x8mm_P0.4mm_EP5.2x5.2mm_ThermalVias
Y1: 25MHz; Crystal_SMD_SeikoEpson_FA238-4Pin_3.2x2.5mm; Part Description Crystal 25MHz 3.2x2.5mm 30ppm 50R 14pF 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

Connections:
+3.3v: C3.1, L1.1, R12.1
+5v: C2.1, C8.1, U6.4 (VIN), U7.1 (IN)
A1.05v: C44.1, C45.1, C50.1, C53.1, C54.1, C55.1, C56.1, C63.1, C65.1, L3.2, U10.3 (VCCA10SSRX34), U10.9 (VDD), U10.12 (VCCA10SSRX34), U10.29 (VDD), U10.45 (VDD), U10.54 (VCCA10SSRX12), U10.60 (VDD), U10.63 (VCCA10SSRX12)
A3.3v: C9.1, C10.1, C11.1, C25.1, C26.1, C30.1, C32.1, C33.1, C48.1, L1.2, R14.1, R24.1, U10.6 (VCCA33SS34), U10.15 (VCCA33SS34), U10.23 (VCCA33PEX), U10.32 (VSUS33), U10.46 (VSUS33), U10.49 (VCCA33SSM), U10.57 (VCCA33SS12), U10.66 (VCCA33SS12)
C1_N: C67.2, U10.53 (SSTX1_N)
C1_P: C66.2, U10.52 (SSTX1_P)
C2_N: C69.2, U10.62 (SSTX2_N)
C2_P: C68.2, U10.61 (SSTX2_P)
GND: C2.2, C3.2, C8.2, C9.2, C10.2, C11.2, C14.2, C16.2, C17.2, C19.2, C20.2, C25.2, C26.2, C27.2, C28.2, C30.2, C31.2, C32.2, C33.2, C44.2, C45.2, C48.2, C50.2, C53.2, C54.2, C55.2, C56.2, C63.2, C65.2, J12.10 (SHIELD), J12.A4 (GND), J12.A7 (DRAIN), J12.B4 (GND), J12.B7 (DRAIN), J14.7, J14.8, Q2.2 (S), R13.2, R22.2, R23.2, R36.2, U6.2 (GND), U7.2 (GND), U10.69 (PAD_GND), Y1.2, Y1.4
unnamed: C14.1, U10.47 (SSXI), Y1.1
unnamed: C15.1, C28.1, C31.1, L2.2, L3.1, R16.1
unnamed: C15.2, R16.2, R22.1, U6.5 (FB)
unnamed: C27.1, U10.48 (SSX0), Y1.3
unnamed: L2.1, U6.3 (LX)
unnamed: R12.2, R13.1, U6.1 (EN)
unnamed: R23.1, U10.50 (SSREXT)
unnamed: R36.1, U7.5 (ILIM)
PCIE_CLK_N: U10.21 (PEXCLK_P)
PCIE_CLK_P: U10.22 (PEXCLK_N)
PCIE_CLK_nREQ: U10.30 (nPEXCLKREQ)
PCIE_RX_N: C6.2
PCIE_RX_P: C4.2
PCIE_TX_N: U10.28 (PEXRX_N)
PCIE_TX_P: U10.27 (PEXRX_P)
PCIE_nRST: U10.19 (nPEXRST)
PD1_N: J12.B2 (D-), U10.59 (USB2D1_N)
PD1_P: J12.B3 (D+), U10.58 (USB2D1_P)
PD2_N: J12.A2 (D-), U10.68 (USB2D2_N)
PD2_P: J12.A3 (D+), U10.67 (USB2D2_P)
PD3_N: J14.3, U10.8 (USB2D3_N)
PD3_P: J14.5, U10.7 (USB2D3_P)
PD4_N: J14.4, U10.17 (USB2D4_N)
PD4_P: J14.6, U10.16 (USB2D4_P)
PEXTX_N: C6.1, U10.25 (PEXTX_N)
PEXTX_P: C4.1, U10.24 (PEXTX_P)
PWR: Q2.3 (D), R15.2, U7.3 (EN)
SSRX1_N: J12.B5 (SSRX-), U10.56 (SSRX1_N)
SSRX1_P: J12.B6 (SSRX+), U10.55 (SSRX1_P)
SSRX2_N: J12.A6 (SSRX+), U10.65 (SSRX2_N)
SSRX2_P: J12.A5 (SSRX-), U10.64 (SSRX2_P)
SSTX1_N: C67.1, J12.B8 (SSTX-)
SSTX1_P: C66.1, J12.B9 (SSTX+)
SSTX2_N: C69.1, J12.A9 (SSTX+)
SSTX2_P: C68.1, J12.A8 (SSTX-)
VBUS: C16.1, C17.1, C19.1, C20.1, J12.A1 (VBUS), J12.B1 (VBUS), J14.1, J14.2, U7.6 (OUT)
nEXTRST: R15.1, U10.31 (nPONRST)
nOCS1: R24.2, U7.4 (nFault), U10.37 (nUSBHOC4), U10.39 (nUSBHOC3), U10.41 (nUSBHOC2), U10.43 (nUSBHOC1)
nPWR: Q2.1 (G), R14.2, U10.44 (nUSBHPE1)

Notes on the sheet:
Potential divider sets 1.05v to start when 3.3v rail is somewhere between 0.8v and 3v
Current Limit switch
CLK PN swap to help routing
TX2 RX2 P/N swapped to help routing
Stacked USB connectors
Make sure the power switch is disabled during power up
EN pin <0.4v Ouput off EN pin >1.5v Output on.
Expansion USB connector
