Mr-JoE1/SS_AI_Traffic_Radar/Hardware/Ref/CM4IOUSB3-KiCAD/microUSB.kicad_sch

## KiCad design Hardware/Ref/CM4IOUSB3-KiCAD/microUSB.kicad_sch (2023-10-18)

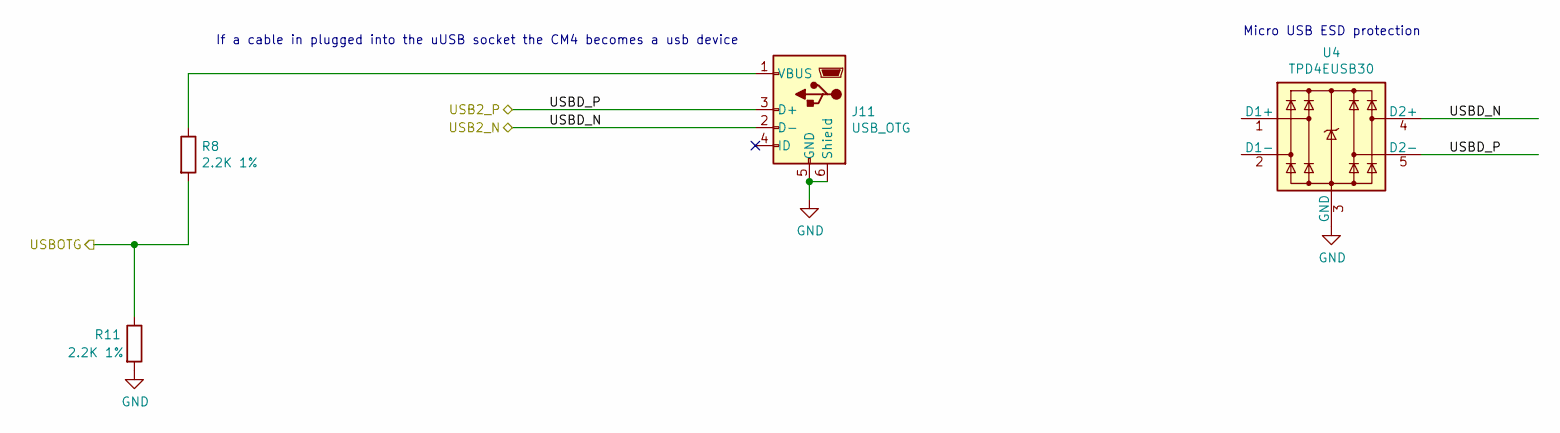
[picture p68: schematic microUSB.kicad_sch]

Parts:
J11: USB_OTG; USB_Micro-B_EDAC_UCON00686; Part Description USB - micro B USB 2.0 Receptacle Connec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
R8, R11: 2.2K 1%; R_0402_1005Metric; Part Description Resistor 2.2K M1005 1% 63mW
U4: TPD4EUSB30; USON-10_2.5x1.0mm_P0.5mm; Part Description Quad TVS diode for high speed signals (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

Connections:
GND: J11.5 (GND), J11.6 (Shield), R11.2, U4.3 (GND), U4.8 (GND)
unnamed: J11.1 (VBUS), R8.1
unnamed: U4.1 (D1+), U4.10
unnamed: U4.2 (D1-), U4.9
USB2_N: J11.2 (D-), U4.4 (D2+), U4.7
USB2_P: J11.3 (D+), U4.5 (D2-), U4.6
USBOTG: R8.2, R11.1

Notes on the sheet:
If a cable in plugged into the uUSB socket the CM4 becomes a usb device
Micro USB ESD protection
