Mr-JoE1/SS_AI_Traffic_Radar/(notices)

Notices in the files:
Hardware/Ref/CM4IO-KiCAD/RTC.kicad_sch:
© 2020-2022 Raspberry Pi Ltd (formerly Raspberry Pi (Trading) Ltd.)
Hardware/Ref/CM4IOUSB3-KiCAD/CM4IOUSB3.kicad_sch:
Copyright © 2020-2022 Raspberry Pi Ltd (formerly Raspberry Pi (Trading) Ltd.)
parts and their libraries:
Copyright 2016 Accelerated Designs. All rights reserved.
